NhanHuynh2006/smart-water-tank/iot-report-en/main.tex

\documentclass[a4paper, oneside, 13.5pt, top=2.5cm, bottom=2.5cm, left=3cm, right=2.5cm]{book}

% ================================
% Các gói hỗ trợ định dạng văn bản
% ================================
\usepackage{hcmutethesis}
\usepackage{graphicx}
\usepackage[english]{babel}
\usepackage[T5]{fontenc}
\usepackage[utf8]{inputenc}
\usepackage{indentfirst}
\usepackage{titlesec}

% ================================
% Các gói hỗ trợ kỹ thuật
% ================================
\usepackage{tikz}
\usetikzlibrary{calc, arrows.meta, fit, backgrounds, positioning}
\usepackage{amsmath, amssymb}
\usepackage{tabularx}
\usepackage{makecell}
\usepackage{wrapfig}
\PassOptionsToPackage{hidelinks}{hyperref}
\usepackage{array}
\usepackage[table]{xcolor}
\usepackage{multirow}
\usepackage{longtable}
\usepackage{float}
\usepackage{rotating}
\usepackage{chngcntr}
\usepackage{textcomp}
\usepackage{fancyhdr}
\usepackage{caption}
\usepackage{enumitem}
\usepackage{tocloft}
\usepackage{listings}
\setlength{\cftfignumwidth}{2.5em}

% ================================
% Đánh số hình và bảng theo chương
% ================================
\counterwithin{figure}{section}
\counterwithin{table}{section}

% ================================
% Định dạng tiêu đề
% ================================
\titleformat{\subsection}{\normalfont\large\bfseries}{\hspace{1em}\thesubsection}{0.5em}{}
\titleformat{\subsubsection}{\normalfont\normalsize\bfseries}{\hspace{2em}\thesubsubsection}{0.5em}{}

\setlist[itemize,enumerate]{
    labelindent=1em,
    leftmargin=3em,
    listparindent=2em,
    parsep=0pt
}

\renewcommand{\baselinestretch}{1.3}
\titlespacing*{\section}{0pt}{20pt}{15pt}
\titleformat*{\section}{\fontsize{18pt}{0pt}\selectfont \bfseries}
\titlespacing*{\subsection}{0pt}{15pt}{10pt}
\titleformat*{\subsection}{\fontsize{16pt}{0pt}\selectfont \bfseries}
\titlespacing*{\subsubsection}{0pt}{15pt}{10pt}
\titleformat*{\subsubsection}{\fontsize{14pt}{0pt}\selectfont\bfseries}
\titlespacing*{\paragraph}{0pt}{15pt}{0pt}
\titleformat*{\paragraph}{\fontsize{13pt}{0pt}\selectfont \bfseries}

\setcounter{secnumdepth}{3}
\setcounter{tocdepth}{3}

% ================================
% Định dạng khối mã nguồn
% ================================
\definecolor{codebg}{HTML}{F4F6F8}
\definecolor{codekw}{HTML}{123E6B}
\definecolor{codecm}{HTML}{5A6B78}
\lstset{
    backgroundcolor=\color{codebg},
    basicstyle=\ttfamily\footnotesize,
    keywordstyle=\color{codekw}\bfseries,
    commentstyle=\color{codecm}\itshape,
    breaklines=true,
    frame=single,
    rulecolor=\color{codecm},
    xleftmargin=1em,
    numbers=none,
    showstringspaces=false,
    captionpos=b
}

% ================================
% Figure placeholder box
% Replace \chohinh{...}{...} with
% \includegraphics[width=0.9\textwidth]{fig/filename.png}
% ================================
\newcommand{\chohinh}[2]{%
  \fbox{\parbox[c][2.9cm][c]{0.86\textwidth}{\centering \textit{#1}\\[0.5em]
  \small Insert figure here: \texttt{fig/#2}}}%
}

% ================================
% Cài đặt header và footer
% ================================
\pagestyle{fancy}
\fancyhf{}
\fancyhead[L]{\leftmark}
\fancyfoot[C]{\thepage}

% ================================
% Khai báo thông tin đồ án
% ================================
\thesislayout
\input{bia_phancong/thongtin_bia}

\setstretch{1.5}

% ================================
% Cho phép dùng mục điều khiển của IEEEtran khi không dùng lớp IEEEtran
% ================================
\makeatletter
\def\bstctlcite{\@ifnextchar[{\@bstctlcite}{\@bstctlcite[@auxout]}}
\def\@bstctlcite[#1]#2{\@bsphack
  \@for\@citeb:=#2\do{%
    \edef\@citeb{\expandafter\@firstofone\@citeb}%
    \if@filesw\immediate\write\csname #1\endcsname{\string\citation{\@citeb}}\fi}%
  \@esphack}
\makeatother

\hypersetup{hidelinks}
\begin{document}
\bstctlcite{BSTcontrol}

% Trang bìa
\coverpage
\newpage
\pagestyle{fancy}

% ======== Acknowledgments ========
\begin{acknowledgments}
Throughout this final project for the course IoT Foundations and Applications, our group received careful guidance and valuable technical feedback from Dr. Huynh The Thien. His lectures on layered architecture, application layer messaging and time series data infrastructure provided the theoretical basis for most of the design decisions in the system we built.\\

We also thank the Faculty of Advanced Education for granting us laboratory access, which allowed us to complete the hardware prototype and carry out the measurements reported here.\\

We would like to express our sincere and deepest gratitude.

\begin{table}[!h]
\centering
\begin{tabular}{p{3cm} p{3cm} p{3cm} p{3cm}}
&   & \multicolumn{2}{c}{Project group} \\
&   & \multicolumn{2}{c}{\textit{(Signature and full name)}} \\
&   &                                  \\
&   &                                  \\
&   &                                  \\
&   &                                  \\
&   &                                  \\
&   &                                  \\
\end{tabular}
\end{table}
\end{acknowledgments}
\newpage
\pagestyle{fancy}

% ======== Declaration ========
\begin{declaration}
We declare that the entire content presented in this report is the result of our own research and implementation. The firmware, the backend service and the monitoring interface were written by us. The experimental data were collected directly on the physical prototype that we assembled. Every item taken from the course lectures, technical standards and scientific literature is cited at the point of use and listed in the references.
\\
\begin{table}[!h]
\centering
\begin{tabular}{p{3cm} p{3cm} p{3cm} p{3cm}}
&   & \multicolumn{2}{c}{Project group} \\
&   & \multicolumn{2}{c}{\textit{(Signature and full name)}} \\
&   &                                  \\
&   &                                  \\
&   &                                  \\
&   &                                  \\
&   &                                  \\
&   &                                  \\
\end{tabular}
\end{table}
\end{declaration}
\newpage
\pagestyle{fancy}

% ======== Abstract ========
\begin{abstract}
\sloppy

This project builds a closed loop smart water tank for Project 08: it measures water level and flow, drives a pump automatically, accumulates consumed volume, detects and classifies faults, and can be supervised from anywhere on the Internet. The system spans the layered model of the Internet of Things: an ESP32 with an ultrasonic level sensor, two turbine flow sensors, a Hall current sensor and two float switches; MQTT over Wi-Fi to a Mosquitto broker; a FastAPI service with a SQLite time series store; and a web dashboard published through an HTTPS tunnel, where anyone may watch and only a password authenticated administrator may control.

The central design decision is to place the entire control law and every safety rule inside the edge microcontroller. Level regulation therefore keeps working while the network is down, and a ring buffer replays telemetry when it returns. The controller is a seven state machine with a 30 to 70 percent hysteresis band and minimum on and off times; eleven fault rules, a single guard function through which every pump start must pass, and independent overflow layers ensure that manual commands cannot bypass safety. Level readings pass a robust filter chain (lower quartile of a fifteen ping window, interquartile spread gate, physical rate checks and an alpha-beta filter), backed by a tank model that bridges intervals without a trusted reading, and a pump health classifier separates hydraulic from electrical pump faults using current and level evidence. A rolling baseline over 48 half hour slots detects abnormal consumption on the backend.

On the bench, every automatic fill of the control session stopped between 70.1 and 70.8 percent with at most 1.85 percent overshoot, the pump started 12.9 times per hour with no relay chatter, no false alarm was raised in 84 minutes, and pumped volume was estimated with a mean error of $-5.2$ percent against a geometric reference. Calibrated against a ruler and the pumped volume, the level reads within 0.68 centimetres root mean square outside one ultrasonic blind zone. On the final firmware the tank kept filling through a two minute network outage and stopped itself at 70.7 percent, 4 of 129 messages were lost, and commands were confirmed with a median round trip of 29 milliseconds. The report states openly where the prototype falls short: the flow sensors are fitted and the inlet sensor is calibrated, but control and accounting still use flow derived from the level; the no current fault was not injected physically; and the MQTT path inside the laboratory is not encrypted.

\end{abstract}
\newpage
\pagestyle{fancy}

% ======== Contents ========
\tableofcontents
\newpage
\listoftables
\listoffigures
\newpage
\pagestyle{fancy}

% ======== Abbreviations ========
\begin{abbreviation}
The following abbreviations are used throughout this report.
\begin{table}[!h]
\renewcommand{\arraystretch}{1.3}
\begin{tabular}{p{3cm} p{11cm}}
\textbf{Abbreviation} &  \textbf{Definition} \\
\hline
IoT   & Internet of Things \\
MQTT  & Message Queuing Telemetry Transport \\
QoS   & Quality of Service \\
LWT   & Last Will and Testament \\
ACL   & Access Control List \\
TLS   & Transport Layer Security \\
REST  & Representational State Transfer \\
API   & Application Programming Interface \\
JSON  & JavaScript Object Notation \\
IQR   & Interquartile Range \\
mDNS  & Multicast Domain Name System \\
RTT   & Round Trip Time \\
HTTPS & Hypertext Transfer Protocol Secure \\
TSDB  & Time Series Database \\
ADC   & Analog to Digital Converter \\
SAR   & Successive Approximation Register \\
PWM   & Pulse Width Modulation \\
GPIO  & General Purpose Input Output \\
MCU   & Microcontroller Unit \\
FSM   & Finite State Machine \\
ISR   & Interrupt Service Routine \\
NVS   & Non-Volatile Storage \\
EMF   & Electromotive Force \\
MAE   & Mean Absolute Error \\
RMSE  & Root Mean Square Error \\
EWMA  & Exponentially Weighted Moving Average \\
CUSUM & Cumulative Sum \\
\hline
\end{tabular}
\end{table}
\end{abbreviation}
\newpage
\pagestyle{fancy}

% ======== Main content ========

\include{chapters/chapter01}
\include{chapters/chapter02}
\include{chapters/chapter03}
\include{chapters/chapter04}
\include{chapters/chapter05}
\appendix
\include{chapters/appendixA}

% ======== References ========
\bibliographystyle{IEEEtran}
\bibliography{refs}

\end{document}
