NhanHuynh2006/smart-water-tank/iot-report-en/bia_phancong/bang_phancong.tex

% BANG PHAN CONG: sua noi dung tung dong o day.
\begin{table}[H]
\caption{Distribution of work among group members.}
\label{tab:phancong}
\centering
\renewcommand{\arraystretch}{1.15}
\begin{tabular}{|p{4.6cm}|p{8.4cm}|}
\hline
\textbf{Member} & \textbf{Area of responsibility} \\
\hline
\raggedright Trịnh Trần Quốc Bảo\newline 24119016 & Problem statement and requirements; system architecture, the edge decision principle, the bench rig and signal conditioning. Presents Parts 1 and 2. \\
\hline
\raggedright Đặng Cao Dương\newline 24119024 & Lessons from bench faults, limitations and next steps, conclusion; coordinates the live demonstration and explains each test case and its purpose. Presents Part 7 and the demo. \\
\hline
\raggedright Huỳnh Lê Thành Nhân\newline 24119068 & Firmware and code: MQTT protocol and acknowledgements, level filter pipeline, flow from level, state machine, fault rules, safety guard, pump health and leak detection. Presents Parts 3 and 4. \\
\hline
\raggedright Nguyễn Đoàn Hoàng Ngân\newline 24119064 & Backend and SQLite schema, REST API, dashboard and Cloudflare tunnel, security model, ring buffer and outage recovery. Presents Part 5. \\
\hline
\raggedright Tô Ngọc Thảo Uyên\newline 24119098 & Experiment plan and analysis: control response, volume estimation error, latency and Wi-Fi power saving, fault and outage results. Presents Part 6. \\
\hline
\end{tabular}
\end{table}
