NhanHuynh2006/smart-water-tank/iot-report-en/bia_phancong/thongtin_bia.tex

% THONG TIN TRANG BIA: ten de tai, nganh, sinh vien, giang vien huong dan, thoi gian.
% Sua o day. Ten truong, ten khoa va logo nam trong hcmutethesis.sty.
\ctname{\textbf{SMART WATER TANK: LEVEL AND FLOW MONITORING WITH AUTOMATIC PUMP CONTROL}}
\cmjname{\textbf{MAJOR IN COMPUTER ENGINEERING TECHNOLOGY}}
\cstuname{\textbf{Trịnh Trần Quốc Bảo} \\[0.15em] Student ID: 24119016 \\[0.4em]
            \textbf{Đặng Cao Dương} \\[0.15em] Student ID: 24119024 \\[0.4em]
            \textbf{Huỳnh Lê Thành Nhân} \\[0.15em] Student ID: 24119068 \\[0.4em]
            \textbf{Nguyễn Đoàn Hoàng Ngân} \\[0.15em] Student ID: 24119064 \\[0.4em]
            \textbf{Tô Ngọc Thảo Uyên} \\[0.15em] Student ID: 24119098}
\csSupervise{\textbf{Dr. HUYNH THE THIEN}}
\cttime{10/2026}
