NhanHuynh2006/smart-water-tank/iot-report-en/chapters/chapter04.tex

\chapter{BACKEND, INTERFACE, SECURITY AND RELIABILITY}
\label{chap:platform}

\section{Backend architecture}
\label{sec:o5-1}

The backend is a single Python process containing three concurrent components. The ingestion component holds a persistent broker session and subscribes to the six specified topics. The API server exposes endpoints for the dashboard and for extracting experimental data. The rolling baseline leak detector is invoked on every incoming telemetry message and is described in Section~\ref{sec:o6-6}; because it learns slowly, it is rebuilt from the stored history each time the process starts, so a restart does not discard days of learning. In addition the process keeps an in memory copy of the latest state, so that the current state endpoint can answer without touching the database, since the dashboard calls it once per second.

For every telemetry message the ingestion component records the device timestamp alongside \texttt{recv\_ts}, written by the backend on arrival, so that a one way delay $\tau = t_{recv} - t_{sample}$ is available from a single query without external instrumentation. The device timestamp is stored twice: \texttt{ts} at one second resolution, kept so that existing consumers of the payload continue to parse, and \texttt{ts\_ms} at millisecond resolution, which is the field the latency query prefers. The coarser field alone carries a quantisation error of up to 500 milliseconds, larger than the transport delay it is meant to measure, and Section~\ref{sec:o8-5} records the corrected figures side by side. The measurement assumes both clocks are synchronised; messages emitted before synchronisation completes carry a zero timestamp and are excluded from the statistics. Because that assumption cannot be discharged on a microcontroller disciplined only by the network time protocol, the one way figure is treated as a comparison quantity and the command round trip, timed entirely by the server clock, is the reported result.

\section{Data schema and API}
\label{sec:o5-2}

The schema has six tables, split according to data behaviour, and is shown with the whole repository in the code guide delivered alongside this report: \texttt{telemetry} is written continuously at one row per second, while \texttt{faults}, \texttt{pump\_events}, \texttt{commands}, \texttt{availability} and \texttt{config} are written sparsely and discretely. The telemetry table is indexed on the timestamp column, the only column ever used as a filter predicate. The group applies the tag and field separation principle of Section~\ref{sec:o2-5}: the device identifier acts as an indexed tag while the measured quantities are unindexed fields. In particular the sequence number column, although it changes on every row, is deliberately left unindexed to avoid exactly the cardinality explosion the lectures warn about \cite{slide04}. The command table stores both the send time and the acknowledgement time, whose difference is the command round trip latency.

On database choice, the group is aware that the theory in Section~\ref{sec:o2-5} identifies real limits of relational engines for high rate time series data \cite{slide04}. Those limits, however, appear at thousands of writes per second, whereas this system writes one row per second from one node, three to four orders of magnitude below the problematic regime. Deploying a dedicated time series engine would add operational complexity without any measurable benefit, so the group chose SQLite while still respecting the schema design principles above \cite{sqlite}.

\begin{table}[H]
\caption{Main API endpoints.}
\label{tab:api}
\centering
\renewcommand{\arraystretch}{1.1}
\begin{tabular}{|p{1.5cm}|p{4.6cm}|p{6.9cm}|}
\hline
\textbf{Method} & \textbf{Path} & \textbf{Purpose} \\
\hline
GET & \texttt{/api/latest} & Latest state, data freshness, pending commands \\
\hline
GET & \texttt{/api/telemetry} & Time series over a requested interval \\
\hline
GET & \texttt{/api/volume/daily} & Volume pumped in and drawn out per day \\
\hline
GET & \texttt{/api/leak/baseline} & State of the rolling baseline, slots learned \\
\hline
POST & \texttt{/api/login}, \texttt{/api/logout} & Open or close an administrator session \\
\hline
GET & \texttt{/api/auth} & Whether this browser may control the pump \\
\hline
GET & \texttt{/api/faults}, \texttt{/api/events}, \texttt{/api/commands} & Fault log, pump switching log, command log with acknowledgement latency \\
\hline
POST & \texttt{/api/command} & Issue a command, returns its identifier; session required \\
\hline
GET, PUT & \texttt{/api/config} & Read thresholds; update requires a session \\
\hline
GET & \texttt{/api/stats/latency} & Latency statistics used in Section~\ref{sec:o8-5} \\
\hline
\end{tabular}
\end{table}

Method selection follows the two properties introduced in Section~\ref{sec:o2-5}. Read endpoints use GET because they are safe and change no state. The configuration endpoint uses PUT because replacing the full threshold set is idempotent. The command endpoint uses POST because each call creates a new command record with its own identifier and is therefore not idempotent \cite{slide05}.

\textbf{Daily volume.} The first implementation computed each day's volume as the maximum minus the minimum of the accumulated counter. That is wrong whenever the counter is reset during the day, and it was: the result swung by litres after every reset. The corrected query uses a window function to take the increment between consecutive rows and sums only increments that are positive and physically possible in one second, so a reset contributes nothing instead of a large negative step. Inflow increments are additionally counted only while the previous row showed the pump running, because with flow derived from level the inlet cannot be non zero with the pump off. Rows stamped before the device clock synchronised carry a timestamp near zero and are assigned to the server's arrival date instead, which removed a spurious day in 1970 from the chart. Figure \ref{fig:daily} shows the result for the four bench days.

\begin{figure}[H]
    \centering
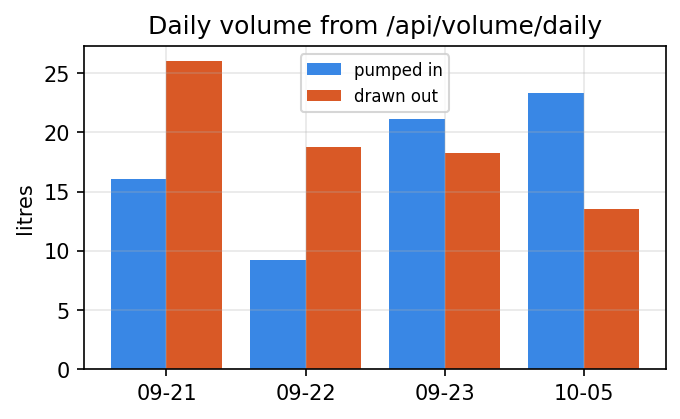
[picture p7: iot-report-en/fig/daily_volume.png]
    
    \caption{Daily volume pumped in and drawn out, as served by the API.}
    \label{fig:daily}
\end{figure}

\section{Monitoring interface}
\label{sec:o5-3}

\begin{figure}[H]
    \centering
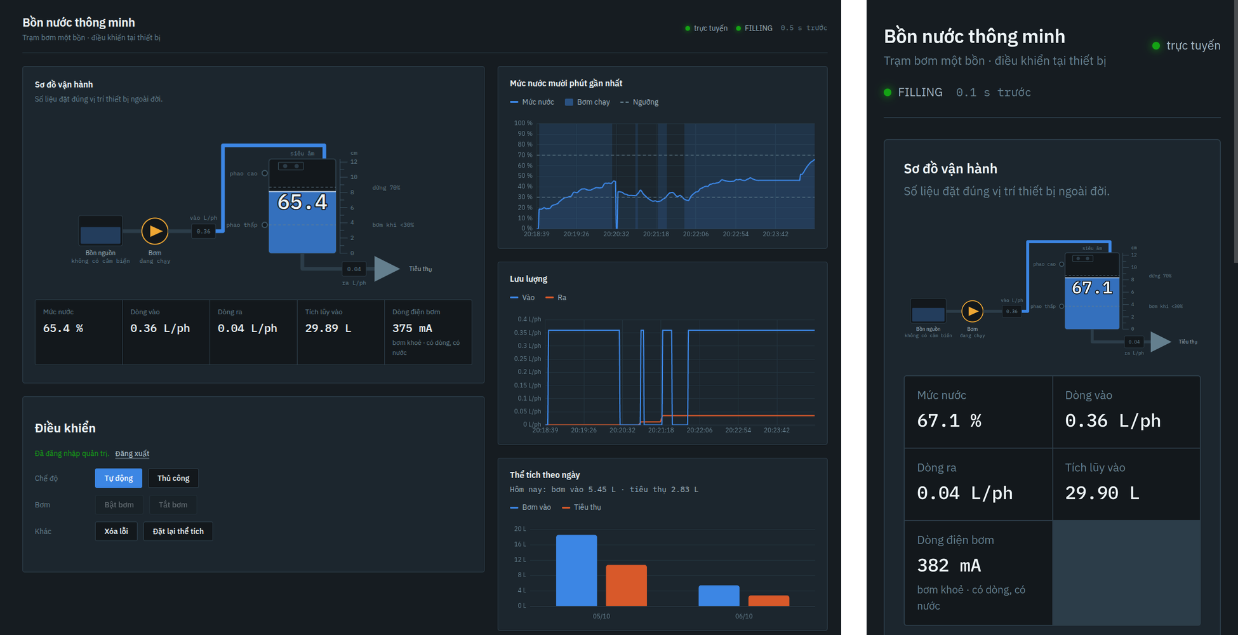
[picture p8: iot-report-en/fig/dashboard_pc_mobile.png]
    
    \caption[Monitoring dashboard on a computer and on a phone]{Monitoring dashboard during an automatic fill, on a computer (left, logged in as administrator) and on a phone (right, viewer). The same page rearranges itself to a single column on a narrow screen: process mimic first, then the numeric tiles, the controls and the charts. For these screenshots, recorded data from 6 October were replayed into an isolated copy of the backend, so the live database was not modified.}
    \label{fig:dashboard}
\end{figure}

The interface is designed for an operator who glances at the screen for a few seconds to answer three questions: what is the level, is the pump running, and is anything wrong. It is a single HTML file with no build step and no framework. The same page serves computers and phones: on a narrow screen the panels stack into one column, the numeric tiles fall into two columns, and the controls stay reachable with a thumb, which matters because the public link is most often opened on a phone (Figure~\ref{fig:dashboard}). The upper part is a process mimic in the style of a control room: the source bucket, the pump, the pipe and the tank are drawn as a diagram, the water in the tank rises and falls with the measured level against a ruler graduated from 0 to 12.4 centimetres, and the low, high and overflow thresholds are drawn at their true positions for the active configuration. Drawing the thresholds on the tank lets a viewer see at once where the level sits relative to the hysteresis band and why the pump just switched.

Below the mimic are the numeric tiles: level, inlet and outlet flow, pump current in milliamperes with the pump health label underneath it, and today's volume. Beside them are the history charts, a daily volume bar chart, and three logs: faults (with the pump health at the moment of each fault), pump events and commands. A freshness line next to the connection lamp shows how many seconds ago the last message arrived.

Two display details matter more than they appear to. The device reports once per second, so a number written straight into the page moves in visible steps; the interface eases the displayed value towards each new reading. And the filtered level still moves by a few millimetres from sample to sample, which on a large readout looks like instability; the display applies a deadband of 0.25 centimetres, below the resolution anyone can act on, so the number holds still unless the water really moves. Neither detail touches the data: the database and the API carry the unmodified values.

On the update mechanism, the lectures recommend REST for low frequency administrative tasks and WebSocket for live streams \cite{slide06, rfc6455}. The group chose polling at 1 Hz, which runs against that general recommendation and therefore needs justification. The device publishes at 1 Hz, so the polling rate equals the data production rate and no request is wasted. With a handful of clients and one node the resulting traffic is a few kilobytes per second. A WebSocket introduces a stateful channel with its own lifecycle to manage, including heartbeats and reconnection \cite{slide06}, that is a new set of failure states in exchange for a benefit that is not measurable at this scale. The conclusion reverses beyond roughly ten nodes or a required update rate of 5 Hz.

The feedback sync principle is implemented in how command state is displayed. When the user presses the pump button the interface does not change the pump symbol; it posts the request, receives an identifier, shows ``sending command'' and polls the command log for that identifier. When the acknowledgement arrives it reports the outcome in a plain sentence, including the reason for a rejection, while the pump symbol follows only the pump state reported in telemetry. An early version gave no feedback at all on a rejection, and a user reported that manual mode ``did not work'' when the device had in fact correctly refused a start inside the 20 second minimum off time; the countdown shown on the button now makes that interlock visible instead of mysterious.

\textbf{Remote access and control rights.} The assignment frames the system as remote supervision, so the dashboard is published through an outbound Cloudflare tunnel that gives it a public HTTPS address without opening any inbound port on the laboratory network. Anyone with the address can watch. Control is a separate matter: the control panel stays hidden until the browser holds an administrator session, obtained by entering a password kept in a file outside the repository. The group first tried to grant control by client address, allowing only the host machine, and abandoned it for two reasons found in testing: through the tunnel every request arrives from the loopback address, so the rule granted control to the whole Internet; and on the host itself every open tab could control the pump, which is not what the owner meant by ``only my machine''. Section~\ref{sec:o7-2} describes the session mechanism.

The interface adapts to the state reported by the device, following the conditional rendering principle \cite{slide06}: data older than 5 seconds or an arriving last will message turns the connection lamp red; a fault or overflow lock switches the status to an alarm style; and a false \texttt{level\_ok} flag marks the level as untrusted. Hiding or disabling buttons is only a convenience, since the backend rejects commands without a session and the device rejects unsafe ones regardless of who sent them.

\section{Device simulator}
\label{sec:o5-4}

The simulator implements the hydraulic model introduced in Section~\ref{sec:o2-6} together with a sensor noise model, and publishes messages that conform to the specification of Sections \ref{sec:o4-1} to \ref{sec:o4-4}. It serves two purposes: while components had not arrived it allowed the backend and interface branches to be developed fully, and it allows control parameters to be swept across dozens of configurations in a few minutes, which is not feasible on real hardware. The sweep results are reported in Section~\ref{sec:o8-3}. The simulator can also inject three failure modes, namely a pump that runs without delivering water, a sensor stuck at a fixed value, and a leak at a prescribed flow rate.

\section{Threat model and mitigations}
\label{sec:o7-1}

Under the ITU-T Y.2060 model of Section~\ref{sec:o2-2}, security is a cross cutting capability acting on every layer rather than a layer of its own \cite{itu2060}, so the analysis is organised per layer.

\begin{table}[H]
\caption{Threat scenarios and mitigations.}
\label{tab:threat}
\centering
\renewcommand{\arraystretch}{1.1}
\begin{tabular}{|p{5.2cm}|p{3.4cm}|p{4.4cm}|}
\hline
\textbf{Attack scenario} & \textbf{Consequence} & \textbf{Mitigation} \\
\hline
Connect to the broker and publish a pump on command & Overflow, pump damage & Mandatory authentication, per topic access control \\
\hline
Sniff traffic to harvest credentials & Full control takeover & \textbf{Not mitigated in the lab build:} broker on plain port 1883, reachable only inside the laboratory network; TLS on port 8883 is the deployment step \\
\hline
Forge telemetry so the system misreads the level & Incorrect pumping, possible overflow & Local interlock based on the mechanical float \\
\hline
Replay commands repeatedly to make the pump chatter & Mechanical pump damage & Minimum on and off times enforced on the device \\
\hline
Call the API directly, bypassing the web interface & Unauthorised commands & Every control endpoint checks an administrator session \\
\hline
Guess the administrator password through the public address & Control takeover & Five failures in five minutes lock the source address \\
\hline
\end{tabular}
\end{table}

The second row is the one gap the group leaves open, and Section~\ref{sec:o7-2} states it without qualification. The two rows after it are worth highlighting because they are mitigated not by cryptography but by the control design itself. The mechanical float is a physical constraint that no network message can override, and the minimum switching times are enforced in firmware, so an attacker may send any number of commands without making the pump toggle faster than the limit. This illustrates the principle that safety in a cyber physical system cannot be separated from its control design.

\section{Authentication, authorisation and encryption}
\label{sec:o7-2}

The Mosquitto configuration disables anonymous connections entirely and mandates both a password file and an access control list file \cite{mosquitto}. The group applies least privilege: the edge device may only publish on the northbound topics under its own branch and may only subscribe to its own command topic, while the backend may publish on the command topic and read the whole northbound branch. The practical meaning is that if the edge device is compromised, the attacker still cannot use that device to issue control commands, because the device account has no write permission on the command topic. This is exactly the node compromise scenario the lectures raise when introducing access control lists \cite{slide03}.

On the API side the system distinguishes a viewer, who needs nothing and may call every read endpoint, from an administrator, who may also call the command and configuration endpoints. Administrator rights are obtained by password. The password lives in a file outside the repository with owner only permissions, and is compared in constant time. A correct password creates a random 256 bit session token, returned as a cookie marked HttpOnly so page scripts cannot read it, SameSite Strict so another site cannot make the browser send it, and Secure whenever the request arrived over HTTPS, which through the tunnel is always. Sessions last seven days and are held in memory, so restarting the backend logs everyone out, which the group accepts at this scale. A missing or expired session returns 401. Five wrong passwords within five minutes lock further attempts from that address for the rest of the window, with the client address taken from the tunnel's forwarded header only when the connection itself comes from the local machine, since any remote caller could forge that header.

The group records one design it rejected. Control was first granted to requests from the host machine's own address. Behind the tunnel every request, from anywhere, arrives from the loopback address, so the rule silently gave control to the whole Internet; and even without the tunnel it gave control to every browser tab on the host rather than to a person. Identity has to come from something the person knows, not from where the packet appears to come from.

\textbf{What is not encrypted.} The system as built does not use TLS on the MQTT path, and the group does not claim end to end encryption. The broker listens on the unencrypted port 1883, inside the laboratory network only; the Cloudflare tunnel carries the dashboard and the API over HTTPS and never exposes the broker. Anyone able to capture Wi-Fi traffic on that network could therefore read the telemetry and the broker passwords of the device and the backend, which is exactly the sniffing threat of Table~\ref{tab:threat}. Within the lab, the access control list limits what a stolen device password allows, and the control design limits what a forged command can do; neither replaces encryption. For a real deployment the group would move to MQTTS on port 8883 with a certificate on the broker \cite{slide03, rfc8446}. The cost should be stated plainly: the TLS handshake requires the microcontroller to perform public key operations, which noticeably increases startup time and memory consumption. One principle holds in every configuration, namely that no secret ever appears inside the telemetry payload.

\section{Reliability during a network outage}
\label{sec:o7-3}

This is a mandatory requirement and also the most important property of the system. Four mechanisms are implemented.

First, the control loop runs on a fixed cycle, and the network calls it cannot avoid are bounded: opening a socket to the broker gives up after 500 milliseconds instead of the default three seconds, waiting for the broker's acknowledgement gives up after two seconds, and no message is written to a socket that cannot accept it at once (Section~\ref{sec:o4-4}). Measured on the final firmware with the link cut for 120 seconds, the longest control period during the outage was 0.88 seconds, against up to ten seconds before the socket check was added. During an outage the system therefore loses only remote visibility while retaining every control and safety function, and the longest control period is published in the first message after reconnection so the claim can be checked rather than assumed.

Second, when the link is down telemetry messages are not discarded but packed into a compact structure and pushed into a circular buffer holding 240 entries, about four minutes of data. The circular buffer was chosen for exactly the reason given in the lectures, namely constant time insertion with no array shifting \cite{slide01}. Each entry stores only the essential fields as scaled integers instead of a full JSON string. Once the link returns the whole buffer is replayed in order, tagged so it can be excluded from latency statistics. The buffer only starts filling once the firmware knows the link is down, which is why the socket is closed after three seconds of refused writes rather than left to the 15 second keep alive.

Third, accumulated volume is written to non volatile storage and reloaded at startup, so a sudden power loss does not erase the consumption history.

Fourth, inside the initialisation routine and before any sensor is read, the relay control pin is driven to the pump off level, so every restart begins from a safe state. The state machine then stays in \texttt{BOOT} until a first level reading has been accepted, so the zero that the level variable holds at power up can never be read as an empty tank (Section~\ref{sec:o8-3}). The integrated brownout detector acts as an additional protective layer: when the supply falls below the critical threshold, flash writes become unreliable and the core may execute corrupted instructions, so the hardware deliberately holds the device in a safe reset state until the voltage recovers \cite{slide01}.

\begin{table}[H]
\caption{Independent layers of overflow protection.}
\label{tab:layers}
\centering
\renewcommand{\arraystretch}{1.1}
\begin{tabular}{|p{4.6cm}|p{3.6cm}|p{4.8cm}|}
\hline
\textbf{Mechanism} & \textbf{Location} & \textbf{Still effective when} \\
\hline
High threshold of the hysteresis band & State machine & Sensor is healthy \\
\hline
Safety limit at 85 percent & Fault rule & Sensor is healthy \\
\hline
Raw distance closer than 4.5 cm, three pings in a row & Fault rule, unfiltered & The filter chain is producing nonsense \\
\hline
No level progress in 90 seconds & Fault rule & Level reading is frozen or false \\
\hline
2.5 litres in one run; 240 s and unconditional 300 s run limits & Fault rules & Every level sensor has failed \\
\hline
Upper mechanical float & Digital input & Ultrasonic sensor has failed \\
\hline
Relay driven off as the first instruction at boot & Firmware start up & Controller has just reset \\
\hline
\end{tabular}
\end{table}

The value of this arrangement lies in the independence of the layers. The first two both rely on the filtered ultrasonic level and fail together if it fails, but the raw distance guard bypasses the filter, the run limits consult only the clock, and the float requires no measurement at all. The time limits are honestly the weakest layer: a 240 second run at the measured delivery adds 1.44 litres, more than the whole 1.24 litre tank, so on their own they bound the damage rather than prevent it, and they sit behind the float rather than replacing it. No single point of failure disables the overflow protection as a whole.
