NhanHuynh2006/smart-water-tank/iot-report-en/chapters/chapter01.tex

\chapter{INTRODUCTION AND BACKGROUND}
\label{chap:intro}

\section{Motivation and problem statement}
\label{sec:o1-1}

Household water management in Vietnam still relies largely on a mechanical float placed inside the storage tank. The device is cheap and durable, but it solves exactly one problem: cutting the pump when the tank is full. The owner has no idea how much water was consumed, cannot notice a pipe leak until the bill rises unexpectedly, and has no way of knowing that the pump is running dry until it has already failed.

The problem carries every characteristic of a cyber physical system, meaning a system in which computation, communication and a physical process are tied together through feedback loops \cite{slide01}. A physical quantity is measured, digitised, transported to a data infrastructure, turned into a decision, and finally acted back upon the same physical process through an actuator.

From an engineering point of view the tank is a nonlinear plant carrying a hard safety constraint. Discharge flow depends on the square root of the water column height, so the plant response changes with the current level. At the same time there is one constraint that may never be violated under any circumstance, including a manual command issued by an operator: the tank must not overflow. Having to guarantee control quality and an absolute safety constraint at the same time is what lifts this project above a simple exercise in wiring a sensor to a display.

The system must therefore address four groups of problems: measuring level and flow with an error budget established experimentally rather than copied from a datasheet; holding the level inside a desired band without letting the pump chatter around the switching threshold; detecting abnormal hydraulic operating modes; and providing remote supervision through a time series store and a real time interface. Overarching all of them is a single requirement that shapes the whole architecture: essential level control must keep working when the network link is lost.

\section{Scope and working method}
\label{sec:o1-2}

The system is built at laboratory prototype scale with one sensing node, a tank with a 1.24 litre working volume and a low voltage direct current pump. The entire electrical side operates at safe extra low voltage. Distributed multi node deployment, machine learning based consumption forecasting and integration with a commercial cloud platform are outside the scope of this work.

The group organised the work along the V model introduced in the project management part of the course \cite{slide01}, in which every decomposition step on the descending branch has a matching verification step on the ascending branch: requirement analysis pairs with full system acceptance, architectural design pairs with integration testing, protocol specification pairs with protocol level testing, and circuit design pairs with unit testing of each individual sensor.

One methodological decision deserves emphasis. The group specified the complete MQTT topic tree, the message payloads, the set of API endpoints and the database schema before writing a single line of code. That specification acted as an internal contract, which allowed the firmware branch, the backend branch and the interface branch to advance in parallel instead of waiting on one another. While components had not yet arrived, a simulator publishing messages that conform to the agreed specification let the other two branches be developed and tested in full.

\section{Requirements of the assignment}
\label{sec:o2-1}

The assignment, Project 08, asks for a smart water tank that monitors consumption and controls its pump automatically. Table \ref{tab:yeucau} restates each requirement in the words of the brief and points to where the report answers it. The third column is the group's own assessment of how completely the requirement is done, because a requirement that is only partly met is better stated than hidden.

\begin{table}[H]
\caption{Requirements of Project 08 and where they are addressed.}
\label{tab:yeucau}
\centering
\renewcommand{\arraystretch}{1.1}
\small
\begin{tabular}{|>{\raggedright\arraybackslash}p{6.3cm}|>{\raggedright\arraybackslash}p{2.7cm}|>{\raggedright\arraybackslash}p{4.4cm}|}
\hline
\textbf{Requirement} & \textbf{Where} & \textbf{Status} \\
\hline
ESP32 class controller with tank level and flow sensors; pressure and pump current optional & Sections~\ref{sec:o3-3}, \ref{sec:o6-2}, \ref{sec:o8-2} & Partly validated: both fitted and read, inlet calibrated; control and volume use level derived flow \\
\hline
Low voltage pump through a relay or MOSFET driver with inductive protection & Section~\ref{sec:o3-4} & Done \\
\hline
Prevent overflow and behave safely on failed or implausible sensors & Sections~\ref{sec:o6-4}, \ref{sec:o7-3} & Done, seven independent layers \\
\hline
Instantaneous flow and accumulated volume & Sections~\ref{sec:o6-2}, \ref{sec:o8-2} & Done, from level; mean error $-5.2$\% \\
\hline
Publish telemetry, actuator state, faults and availability over MQTT & Sections \ref{sec:o4-1} to \ref{sec:o4-4} & Done \\
\hline
Time series storage, REST API, dashboard with level, flow, daily volume, pump state, alarms and freshness & Sections \ref{sec:o5-1} to \ref{sec:o5-4} & Done \\
\hline
Automatic control with hysteresis or a state machine and at least one fault rule, such as pump on with near zero flow & Sections~\ref{sec:o6-3}, \ref{sec:o6-4} & Done, eleven rules \\
\hline
Manual mode cannot bypass safety; commands acknowledged with confirmed state & Sections~\ref{sec:o6-5}, \ref{sec:o4-3} & Done \\
\hline
Local level control keeps working during a network outage & Sections~\ref{sec:o3-2}, \ref{sec:o7-3}, \ref{sec:o8-5} & Done \\
\hline
Advanced: leak detection from a rolling baseline, or pump current and flow consistency to classify pump faults & Sections~\ref{sec:o6-6}, \ref{sec:o6-7} & Both built; baseline still converging \\
\hline
Calibrate level and flow against a physical reference & Section~\ref{sec:o8-2} & Done: ruler and pumped volume, RMSE 0.68 cm; one blind zone \\
\hline
Control response, switching frequency, fault detection delay, volume estimation error & Sections~\ref{sec:o8-2} to \ref{sec:o8-4} & Done \\
\hline
Sensor or no flow fault test, network loss and recovery, telemetry and control latency & Sections~\ref{sec:o8-4}, \ref{sec:o8-5} & Done; outage rerun on final firmware; \texttt{NO\_CURRENT} not injected \\
\hline
\end{tabular}
\end{table}

\section{Layered architecture and computation placement}
\label{sec:o2-2}

An Internet of Things deployment is commonly described by a five layer model made of perception, transport, processing, application and business layers, allowing each stage of signal conversion, transport and storage to be optimised independently \cite{slide01}. Recommendation ITU-T Y.2060 adds two capability groups that cut across the stack, management and security \cite{itu2060}. Treating security as cross cutting rather than as a separate layer has a direct consequence for our design: it cannot be handled at a single point but must appear in broker authentication, per topic access control, transport encryption and API authorisation. Data flow is likewise split into a southbound path carrying commands down to the hardware and a northbound path carrying telemetry and alerts up to the server \cite{slide01}.

Deciding where a computation belongs is driven by quantitative constraints rather than taste. Edge computation offers deterministic latency and very low bandwidth cost but only short term storage, while cloud computation offers durable storage and analytic capacity at the price of latency from hundreds of milliseconds to several seconds \cite{slide01}. The resulting rule is that any operation requiring an immediate safe stop must be computed at the edge, whereas trend analysis is routed upward. Cutting the pump on a dry run condition or when the level passes the safety threshold clearly belongs to the first category, which is the direct basis for the decision in Section~\ref{sec:o3-2}.

\section{Sensing, digitisation and actuation}
\label{sec:o2-3}

Faithful reconstruction of a continuous analog signal requires a sampling rate greater than twice its highest frequency component \cite{shannon1949}. With the pump actually fitted and the tank base measuring 10 by 10 centimetres, the group measured the fill rate directly rather than deriving it from the datasheet. The level rose 1.2 centimetres in 20 seconds, that is $0.06$ centimetres per second, equivalent to $0.36$ litres per minute. This is nearly five times slower than the $1.67$ litres per minute the JT-DC3L datasheet promises at zero head, the difference being delivery head and tubing resistance. A sampling period of 200 milliseconds therefore satisfies the condition by roughly three orders of magnitude. The group records both figures deliberately: an earlier draft quoted 0.6 centimetres per second from an unchecked estimate, the datasheet implies 0.28, and the bench measures 0.06. Only the last of the three was used to size the timing thresholds of Section~\ref{sec:o6-3}, because a threshold derived from a datasheet the hardware does not obey will fire during normal operation. Even the bench figure is not a constant: on 5 October, with a lower source bucket, the same pump delivered 0.24 litres per minute, a fact that matters again in Section~\ref{sec:o8-2}. The ESP32 digitises voltage using a successive approximation register converter \cite{slide01, esp32ds}, and mapping a continuous range onto finite integer steps introduces an unavoidable loss of precision with a quantisation step of

\begin{equation}
\Delta V = \frac{V_{ref}}{2^N}
\label{eq:lsb}
\end{equation}

and quantisation noise bounded within $\pm \frac{1}{2}\Delta V$. This error is mathematical in nature and can never be filtered away in software \cite{slide01}. At 12 bits and 3.3 volts the step is 0.806 millivolts, a figure used in Section~\ref{sec:o3-3}. The lectures also warn that the transfer curve is severely nonlinear near both ends of the range, which is why our dividers place each signal near the middle of the span.

A microcontroller operating at 3.3 volts with roughly 12 milliamperes per pin cannot perform mechanical work directly, so a power stage with galvanic separation has to be inserted. When current through an inductive load is interrupted abruptly, the collapsing field produces a reverse spike following Lenz law, $V = L\,di/dt$, which can exceed several hundred volts and destroy the switching device; the standard remedy is a flyback diode placed antiparallel across the load \cite{slide01}.

\section{Application layer messaging}
\label{sec:o2-4}

A standard HTTP header easily exceeds 500 to 1000 bytes, so sending a measurement of a few bytes spends most of the energy budget on framing, and every transaction additionally forces the radio through a complete TCP handshake \cite{slide03}. MQTT addresses this with a binary frame whose fixed header is two bytes, routed through a broker under a publish and subscribe model that decouples communication in space, time and synchronisation \cite{slide03, mqtt311}.

Three MQTT mechanisms are exploited directly by our system. The three quality of service levels define delivery as at most once, at least once and exactly once, and the lectures caution against defaulting every topic to the highest level because a constrained node will exhaust its memory. The last will mechanism lets the broker publish a pre registered payload by itself once a client vanishes without a clean disconnect, and retained messages make the broker push the current value immediately to a newly subscribing client, eliminating the cold start gap \cite{slide03}. On the security side, MQTTS carries the same binary frames inside a TLS tunnel on port 8883 instead of the unencrypted port 1883, and the lectures stress that a username and password pair alone is insufficient without an access control list mapping each client to the topics it may read and write \cite{slide03, rfc8446}.

\section{Data infrastructure and the feedback sync principle}
\label{sec:o2-5}

Machine telemetry has three structural invariants: it is append only, indexed primarily by time, and its write to read ratio is very high \cite{slide04}. A relational engine is built for transactional integrity, so every inserted row forces a rebalancing of an in memory B-tree, whereas a time series engine optimises for tail appends and separates indexed tags from unindexed fields. The lectures also warn about index cardinality explosion when a randomly varying value is placed in a tag position \cite{slide04}, a principle our schema in Section~\ref{sec:o5-2} follows. The REST style demands client server separation and statelessness, favours nouns over verbs, and asks the designer to evaluate safety $f(s)=s$ and idempotency $f(f(s))=f(s)$ \cite{fielding2000, slide05}; on the microcontroller side, firmware must forbid dynamic allocation inside the loop and reserve a fixed buffer at startup \cite{slide05, arduinojson}.

The single idea with the largest influence on our interface design is the feedback sync principle derived from the device shadow model \cite{slide04}. The anti pattern to avoid is a dashboard toggle that flips to the on state the instant the user presses it, before anything is known about whether the real machine started. The correct architecture splits the path: the user action maps to an outgoing command topic while the indicator stays unchanged until an explicit acknowledgement arrives from the device. This is the basis for the mechanism described in Section~\ref{sec:o4-3}.

\section{On off control with hysteresis}
\label{sec:o2-6}

The material in this section does not appear in the course slides. The group added it from control engineering literature and states the sources here explicitly, so that it is clearly distinguished from the knowledge taken from the lectures.

On off control, also called two position control, is the simplest form of feedback control, in which the actuator takes one of exactly two states \cite{ogata2010}. If the two thresholds coincide, even the smallest measurement noise around that point makes the actuator flip repeatedly, causing rapid wear and repeated inrush events. The standard remedy is to separate them into a hysteresis band inside which the state is held unchanged \cite{astrom2008}:

\begin{equation}
u(t) = 1 \text{ if } h < h_L; \quad u(t) = 0 \text{ if } h > h_H; \quad u(t) = u(t^-) \text{ if } h_L \le h \le h_H
\label{eq:hysteresis}
\end{equation}

The width $h_H - h_L$ is a direct trade off parameter: a wider band lowers the switching frequency but widens the level excursion.

For diagnosis, the group applies the principle of checking consistency between two independent signal sources, following established fault diagnosis theory \cite{isermann2006}. Slow leaks belong to the class of small persistent shift detection, for which the cumulative sum method of Page is far more sensitive than a fixed threshold because it accumulates small deviations over time \cite{page1954}.

To select control parameters before hardware existed, the group built a dynamic model from the volume balance $dV/dt = Q_{in} - Q_{out} - Q_{leak}$ with $h = V/A$, where discharge follows Torricelli law $Q_{out} = C_d A_o \sqrt{2gh}$ \cite{white2011}. The square root dependence makes the plant nonlinear, since discharge at a full tank is appreciably faster than near empty. This is why the hysteresis parameters had to be swept in simulation, as described in Section~\ref{sec:o8-3}.
