NhanHuynh2006/smart-water-tank/IOT/docs/SO_LIEU_20261005.md

# Số liệu đo trên phần cứng ngày 05/10/2026 (dùng để sửa báo cáo và slide)

File gốc nằm cùng thư mục: `systest_20261005_203736.json`, `bench_outage_20261005_203452.json`,
`stepcal_20261005.txt`, `stepcal_high_20261005.txt`, `results_20261005.json`.
E5 (bơm lỗi bằng tay) **không làm** theo quyết định của nhóm.

## Phần cứng và cấu hình đã đổi
- Rơ-le ở **GPIO 10**, Flash Mode **DIO** (`board_build.flash_mode = dio`). Không reset, không chập chờn.
- Thứ tự mạch bơm: rơ-le → ACS712 → bơm chìm; dây bơm có tụ và diode, nguồn có tụ 470 µF.
- Cảm biến lưu lượng: vào GPIO 4, ra GPIO 19 (đã đổi chỗ). Hết nhiễu, dùng được để so sánh.
  Hệ số K đầu vào **85,5** xung/(L/phút), chỉnh theo thước (K = 98 đếm thiếu 14,6 %).
- Hình học: cảm biến cách đáy **15,88 cm** (6¼ inch), mức làm việc tối đa **12,4 cm** (cách cảm biến 3,5 cm), đáy 10 × 10 cm, 1,24 L.
- Ngưỡng 30 / 70 / 85 %. Cửa sổ 15 mẫu, lấy phân vị 25 (tiếng dội yếu làm đọc xa hơn khoảng +0,43 cm mỗi chu kỳ 40 kHz).

## E1 — hiệu chuẩn mực nước (bơm theo bậc, chuẩn là thể tích bơm vào)
- Đọc thước lần cuối 4,9 cm, cảm biến báo 4,92 cm.
- Vùng thấp (mực 0,7–4,9 cm): sai lệch so với thể tích bơm trong khoảng ±0,5 cm (bậc 3 và 5 bị dội chập lệch tới 1 cm).
- **Vùng mù** khi mặt nước cách cảm biến khoảng 7,9–8,7 cm (mực 7–8 cm, 57–64 %): cảm biến trả về tiếng dội ma ổn định
  (bậc thực 7,21 cm đọc 1,01 cm; bậc thực 7,97 cm đọc −5,42 cm). Firmware loại bằng cổng hình học, cổng tốc độ và mô hình bắc cầu tối đa 90 s.
- Nước không chảy ngược qua bơm: đóng van xả, mực phẳng trong 80 s, cảm biến đầu vào 0.

| Bậc | Thể tích (L) | Mực theo thể tích (cm) | Khoảng cách p25 (cm) | Mực cảm biến (cm) |
|---|---|---|---|---|
| Lượt thấp 0–6 | 0 / 0,071 / 0,142 / 0,213 / 0,282 / 0,350 / 0,419 | +0 / 0,71 / 1,42 / 2,13 / 2,82 / 3,50 / 4,19 | 17,68 / 15,16 / 13,57 / 14,13 / 12,07 / 12,16 / 10,96 | −1,80 / 0,72 / 2,31 / 1,75 / 3,81 / 3,72 / 4,92 |
| Lượt cao 0–6 | 0 / 0,067 / 0,136 / 0,202 / 0,268 / 0,333 / 0,400 | +0 / 0,67 / 1,35 / 2,02 / 2,68 / 3,33 / 4,00 | 11,40 / 11,04 / 9,83 / 14,87 / 21,30 / 8,71 / 6,31 | 4,48 / 4,84 / 6,05 / 1,01 (ma) / −5,42 (ma) / 7,17 / 9,57 |

(Lượt thấp bắt đầu từ đáy khô nên bậc 0 âm; lượt cao bắt đầu từ 4,48 cm.)

## Điều khiển tự động
- Ba chu kỳ đủ (17:07–17:40): dừng ở 70,1–70,4 %, vượt 1,72 %, thời gian bơm khoảng 128 s.
- Chu kỳ tối 20:32–20:35: bật từ dưới 30 %, tự dừng ở **70,7 %**.
- Bơm hiện chỉ đưa vào khoảng 0,24–0,3 L/phút (kiểm tra bồn nguồn, van xả để hé).

## E6 — mất mạng 120 s, backend vẫn chạy (bench_outage_20261005_203452)
- Cắt lúc bơm đang chạy ở 9,0 %; sau 120 s mực **50,9 %**, bơm vẫn chạy, không đổi trạng thái lúc mất mạng; chu kỳ đó tự dừng ở 70,7 %.
- Last will (offline) sau **21,8 s**; có lại mạng thì trực tuyến sau **10,0 s**, bản tin trực tiếp đầu tiên sau 10,9 s.
- Gửi lại **125** bản tin đã đệm (seq 707–831), thiếu **4/129**, bộ đệm không tràn (ring_drop 0).
- Vòng điều khiển dừng lâu nhất khi mất mạng **0,88 s** (trước khi sửa là 10 s).

## Kiểm thử hệ thống systest (20:37, 5/5 PASS)
- T1 kết nối: 10 bản tin/10 s, không hụt seq, đủ trường, status giữ lại online.
- T2 bảo mật: xem 200, lệnh không phiên 401, sai mật khẩu 401, đăng nhập 200.
- T3 / E7 lệnh: n = 40, mất 0, khứ hồi **trung vị 29,1 ms, p95 48,5 ms**, nhỏ nhất 16,5, lớn nhất 67,5 ms.
- T4 từ chối: bật bơm ở chế độ tự động → `auto_mode_active`; bật lại trong thời gian nghỉ → `min_off_time`; xóa lỗi khi không có lỗi → `no_active_fault`.
- T5 bơm tay: dòng khi chạy **471–487 mA**, khi tắt 0 mA; nhãn starting → ok.

## Chỗ báo cáo còn ghi số cũ cần sửa
17,5 cm / 14 cm (hình học), 0,36 L/phút, nhiễu 1500 Hz ở cảm biến lưu lượng, rơ-le GPIO 26, bảng E5 (bỏ hoặc ghi không đo), E6/E7/E1 điền số ở trên.
