NhanHuynh2006/smart-water-tank/slides-en/README.txt

English slide deck, 43 slides (about 36 min full script + 10-15 min demo).
Live deck (present, download as PPTX/PDF): https://claude.ai/artifact/TmihFwubP3Ltox1HqgkGtL

project/            source of every slide; speaker notes = English script
SCRIPT_EN.md        full English script with timings + likely Q&A
KICH_BAN_VI.md      the same script in Vietnamese, for rehearsal
img/                architecture & command diagrams (archify), dashboard screenshot
diagrams/           archify specs (*.json) and chart geometry scripts (level.py, bars.py)

Still to fill: group number on slide 1.
Numbers match the report of 5 Oct (E1 calibration, E6 outage on final firmware, systest, E7 29 ms).
