NhanHuynh2006/smart-water-tank/iot-report-en/fig/architecture.png

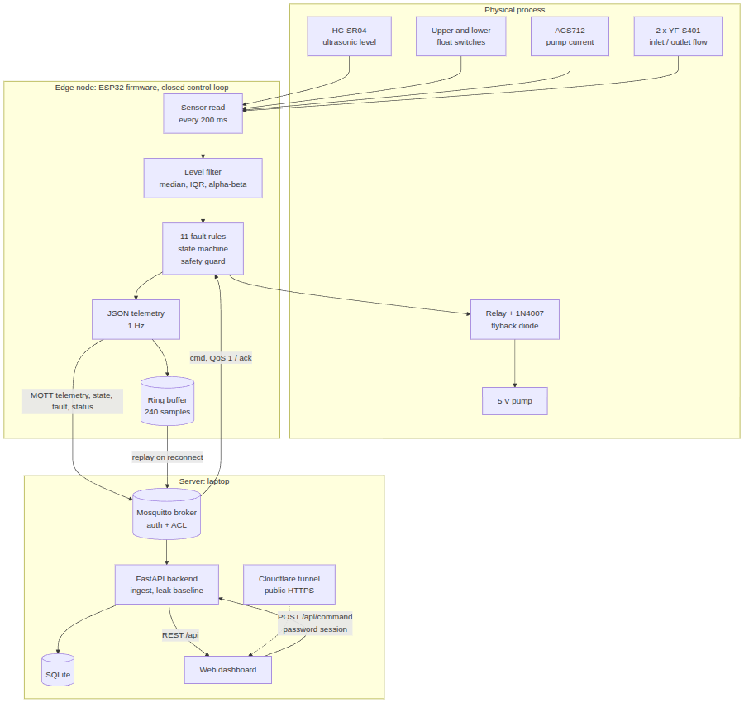
iot-report-en/fig/architecture.png
