NhanHuynh2006/smart-water-tank/iot-report-en/fig/dashboard.png

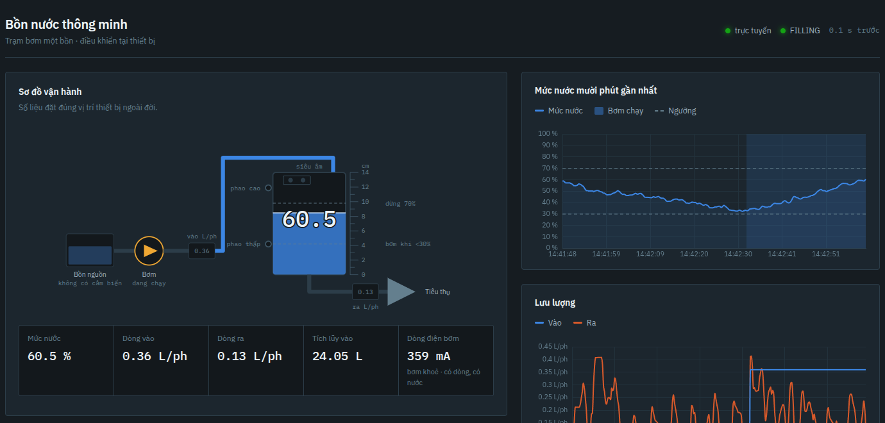
iot-report-en/fig/dashboard.png
