NhanHuynh2006/smart-water-tank/iot-report-en/fig/e7_rtt_hist.png

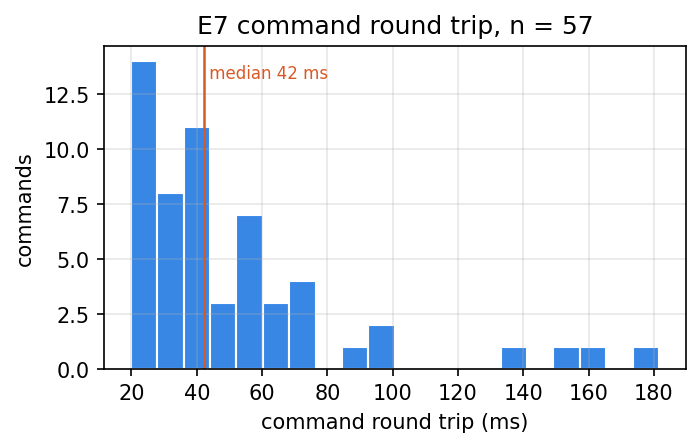
iot-report-en/fig/e7_rtt_hist.png
