NhanHuynh2006/smart-water-tank/slides-en/img/architecture.png

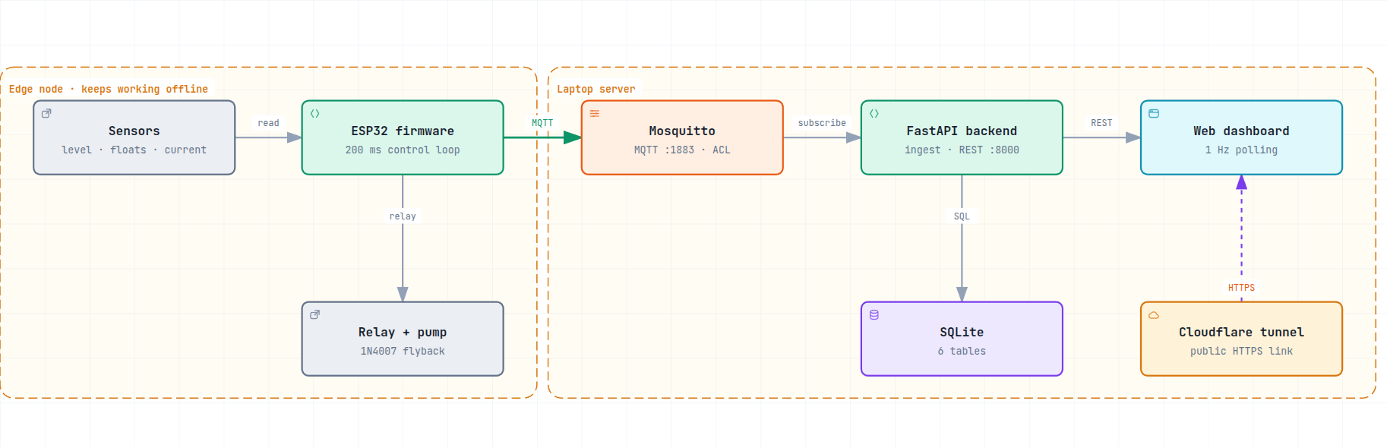
slides-en/img/architecture.png
