NhanHuynh2006/smart-water-tank/slides-en/img/command.png

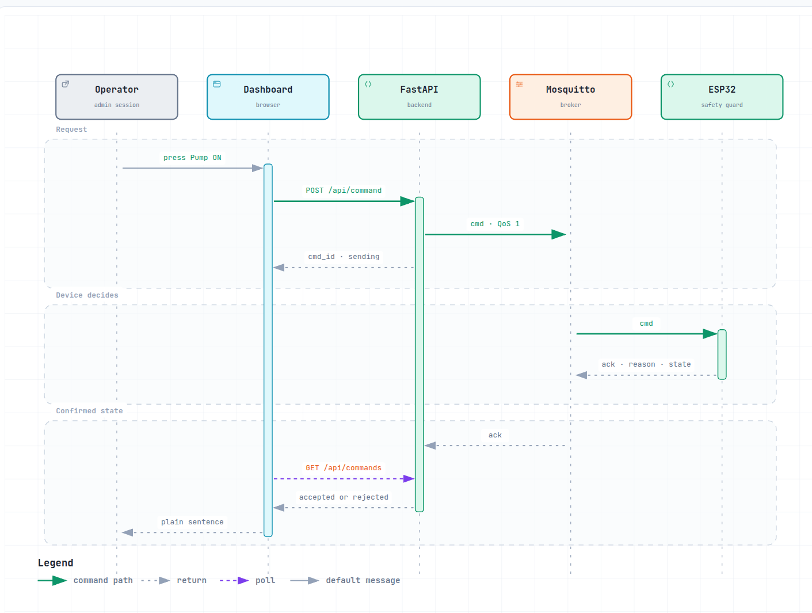
slides-en/img/command.png
