NhanHuynh2006/smart-water-tank/IOT/src/main.cpp

// ============================================================
//  Smart Water Tank - firmware chinh cho ESP32
//  Toan bo luat dieu khien va luat phat hien su co nam o day,
//  nen he van chay dung khi mat ket noi mang.
// ============================================================
#include <Arduino.h>
#include <WiFi.h>
#include <ESPmDNS.h>
#include <PubSubClient.h>
#include <ArduinoJson.h>
#include <Preferences.h>
#include <time.h>
#include <sys/time.h>
#include "config.h"

// ------------------------------------------------------------
//  Trang thai
// ------------------------------------------------------------
enum State { ST_BOOT, ST_IDLE, ST_FILLING, ST_MANUAL_ON,
             ST_FAULT_DRYRUN, ST_FAULT_SENSOR, ST_OVERFLOW_LOCK };

static const char* STATE_NAME[] = {
  "BOOT","IDLE","FILLING","MANUAL_ON",
  "FAULT_DRYRUN","FAULT_SENSOR","OVERFLOW_LOCK" };

State state = ST_BOOT;
bool  autoMode  = true;
bool  pumpOn    = false;
char  faultCode[24] = "";

// ------------------------------------------------------------
//  Do luong
// ------------------------------------------------------------
volatile uint32_t flowPulses = 0;        // cam bien DAU VAO
uint32_t lastPulseSnapshot   = 0;
volatile uint32_t flowOutPulses = 0;     // cam bien DAU RA
// Bo dem xung THO: dem MOI suon xuong, khong qua bo loc nao. Dung de biet
// day tin hieu co dang bat song hay khong.
volatile uint32_t flowRawPulses    = 0;
volatile uint32_t flowOutRawPulses = 0;
uint32_t lastPulseOutSnapshot   = 0;
uint32_t lastRawSnapshot        = 0;
uint32_t lastRawOutSnapshot     = 0;
// false = day tin hieu dang nhieu, so doc luu luong KHONG dung duoc
bool  flowOk = true, flowOutOk = true;

float levelCm   = 0, levelPct = 0;
bool  levelOk   = false;
float flowLpm    = 0;                    // L/phut DAU VAO
float volumeL    = 0, volumeTodayL    = 0;
float flowOutLpm = 0;
float sensorInLpm = 0, sensorOutLpm = 0, sensorInL = 0, sensorOutL = 0;  // cam bien, chi de doi chieu
float volumeOutL = 0, volumeOutTodayL = 0;
float currentMv = 0, currentOffsetMv = 0;
// floatMax = nuoc da cham vach CAO tren bon chua  -> phai ngat bom
// floatMin = nuoc da tut duoi vach THAP tren bon chua -> duoc phep bat bom
bool  floatMax  = false, floatMin = false;

uint32_t lastValidLevelMs = 0;
uint32_t sensorGoodSince  = 0;
float    lastGoodLevelCm  = -1;

// ------------------------------------------------------------
//  Dinh thi
// ------------------------------------------------------------
uint32_t pumpOnSince = 0, pumpOffSince = 0;
uint32_t dryRunSince = 0, noCurrentSince = 0, leakSince = 0;
uint32_t lastControlMs = 0, lastTelemetryMs = 0, lastNvsMs = 0;
// true khi bom chay du lau ma muc KHONG len (nhan no_flow). Cap nhat moi chu
// ky trong loop(); readLevel va mo hinh dung no de bo gia dinh "bom chay thi
// muc phai len" — gia dinh nay sai khi xa ra bang luong bom vao.
bool pumpNoFlow = false;
uint32_t ctlGapMaxMs = 0;     // chu ky dieu khien dai nhat, xem buildTelemetry
uint32_t ringDropped = 0;     // so mau offline bi ghi de vi bo dem day
uint32_t seqNo = 0;

// ------------------------------------------------------------
//  MQTT
// ------------------------------------------------------------
WiFiClient   net;
PubSubClient mqtt(net);
Preferences  prefs;

char topicTelemetry[64], topicPumpState[64], topicFault[64];
char topicStatus[64], topicCmd[64], topicAck[64];

uint32_t nextReconnectMs = 0;
uint8_t  reconnectFails  = 0;

// ------------------------------------------------------------
//  SOCKET CON GHI DUOC KHONG
//  Do tren mach 05/10: cat mang 120 s thi vong dieu khien bi treo 10 GIAY
//  (ctl_gap_ms = 10032). Nguyen nhan: khi broker im lang ma TCP chua bao dut,
//  bo dem gui cua socket day dan, va WiFiClient::write() thu lai 10 lan,
//  moi lan cho select() 1 giay. Trong 10 giay do khong doc cam bien, khong
//  xet chong tran. Kiem tra truoc bang select() voi thoi gian cho bang 0:
//  khong ghi duoc thi KHONG gui, coi nhu mat mang.
// ------------------------------------------------------------
static uint32_t unwritableSince = 0;
static bool netWritable() {
  int fd = net.fd();
  if (fd < 0) return false;
  fd_set set; FD_ZERO(&set); FD_SET(fd, &set);
  struct timeval tv = {0, 0};
  return select(fd + 1, NULL, &set, NULL, &tv) > 0 && FD_ISSET(fd, &set);
}
// Chi gui khi chac chan khong bi chan. Tra ve false neu bo qua.
static bool mqttCanSend() {
  if (!mqtt.connected()) return false;
  if (netWritable()) { unwritableSince = 0; return true; }
  if (unwritableSince == 0) unwritableSince = millis();
  return false;
}

// ------------------------------------------------------------
//  Bo dem vong khi mat mang
// ------------------------------------------------------------
struct Sample {
  uint32_t ts;
  uint32_t seq;
  int16_t  levelPct10;   // phan tram x10
  int16_t  flowLpm100;    // L/phut x100, dau vao
  int16_t  flowOutLpm100; // L/phut x100, dau ra
  uint32_t volumeL100;    // lit x100, dau vao
  uint8_t  flags;        // bit0 pump, bit1 levelOk, bit2 floatMax
  uint8_t  state;
};
Sample  ring[OFFLINE_BUFFER_SIZE];
uint16_t ringHead = 0, ringCount = 0;

void ringPush(const Sample& s) {
  ring[ringHead] = s;
  ringHead = (ringHead + 1) % OFFLINE_BUFFER_SIZE;
  if (ringCount < OFFLINE_BUFFER_SIZE) ringCount++;
  else ringDropped++;          // day: mau cu nhat bi ghi de, dem lai de biet
}

// ------------------------------------------------------------
//  Tien ich
// ------------------------------------------------------------
// Loc xung qua gan nhau. Do tren mach that: khi Wi-Fi bat, hai chan nay bat
// duoc 1600 den 2700 Hz nhieu trong khi khong he co nuoc chay; tat Wi-Fi thi
// dem duoc dung 0. Dien tro keo len NOI BO cua ESP32 khoang 45 kOhm, qua yeu
// de giu muc cao truoc nhieu vo tuyen tren day dan dai.
// YF-S401 o luu luong toi da 6 L/phut chi cho 6 x 98 = 588 Hz, tuc moi xung
// cach nhau it nhat 1,7 ms. Bo qua xung den som hon FLOW_MIN_PULSE_US.
// LUU Y: day CHI la lop phong thu phan mem. Cach sua that la han them dien
// tro keo len NGOAI 4,7 kOhm len 3,3 V, manh gap 10 lan loai noi bo.
volatile uint32_t lastFlowUs = 0, lastFlowOutUs = 0;

void IRAM_ATTR onFlowPulse() {
  uint32_t now = micros();
  flowRawPulses++;
  if (now - lastFlowUs >= FLOW_MIN_PULSE_US) { flowPulses++; lastFlowUs = now; }
}
void IRAM_ATTR onFlowOutPulse() {
  uint32_t now = micros();
  flowOutRawPulses++;
  if (now - lastFlowOutUs >= FLOW_MIN_PULSE_US) { flowOutPulses++; lastFlowOutUs = now; }
}

void setRelay(bool on) {
#if RELAY_ACTIVE_LOW
  digitalWrite(PIN_RELAY, on ? LOW : HIGH);
#else
  digitalWrite(PIN_RELAY, on ? HIGH : LOW);
#endif
}

uint32_t nowTs() {
  time_t t = time(nullptr);
  return (t > 1600000000) ? (uint32_t)t : 0;   // 0 = chua dong bo NTP
}

// Dau thoi gian do phan giai mili giay. Truong "ts" cu chi co do phan giai
// mot giay, nen hieu (recv_ts - ts) bi sai so luong tu hoa toi +-500 ms va
// nhan chim do tre mang that. Truong nay giu nguyen "ts" de khong pha vo
// cac ben doc cu, va bo sung "ts_ms" cho phep do E7.
uint64_t nowTsMs() {
  struct timeval tv;
  if (gettimeofday(&tv, nullptr) != 0) return 0;
  if (tv.tv_sec < 1600000000) return 0;        // 0 = chua dong bo NTP
  return (uint64_t)tv.tv_sec * 1000ULL + (uint64_t)(tv.tv_usec / 1000);
}

// ------------------------------------------------------------
//  Doc cam bien
// ------------------------------------------------------------
float readDistanceOnce() {
  digitalWrite(PIN_TRIG, LOW);  delayMicroseconds(4);
  digitalWrite(PIN_TRIG, HIGH); delayMicroseconds(10);
  digitalWrite(PIN_TRIG, LOW);
  uint32_t dur = pulseIn(PIN_ECHO, HIGH, 30000UL);   // timeout 30 ms
  if (dur == 0) return -1;
  return dur * 0.0343f / 2.0f;                        // cm
}

// Bo loc trung vi 5 mau: loai bo dot bien don le do song mat nuoc
// Trung vi truot. Ban cu phat 5 lan lien tiep cach nhau 6 ms ngay trong mot
// lan goi: vi pham khuyen cao >= 60 ms cua HC-SR04 nen lan phat sau bat phai
// tieng vong con lai cua lan truoc, va ham chan toi 180 ms trong chu ky 200 ms.
// Nay moi chu ky dieu khien phat DUNG MOT lan, cach nhau tron CONTROL_PERIOD_MS
// = 200 ms, va trung vi lay tren cua so LEVEL_MEDIAN_WINDOW mau gan nhat.
static float   levelWin[LEVEL_MEDIAN_WINDOW];
static uint8_t levelWinCount = 0, levelWinHead = 0, levelFailStreak = 0;

// So doc THO cua lan phat gan nhat, chua qua bo loc nao. Chan an toan
// LEVEL_MIN_DISTANCE_CM dung thang so nay, de mot bo loc hong khong the
// lam mat luon lop bao ve cuoi cung. Am nghia la lan phat do khong co tieng doi.
static float   lastRawDistCm = -1.0f;
// Dau ra cua bo loc mu. Am nghia la chua co mau nao de khoi tao.
static float   levelEmaCm    = -1.0f;
// Toc do uoc luong boi bo loc alpha-beta, cm moi giay.
static float    levelVelCmS  = 0.0f;
static uint32_t lastFiltMs   = 0;

// ------------------------------------------------------------
//  DEM LY DO LOAI SO DOC MUC NUOC
//  Khong the sua cai gi minh chua do duoc. Moi cong loc co mot o dem rieng,
//  cong bo ra telemetry, de biet CONG NAO dang loai va loai bao nhieu.
// ------------------------------------------------------------
enum { RJ_ECHO, RJ_GATE, RJ_FEW, RJ_SPREAD, RJ_RANGE, RJ_RATE, RJ_FALL, RJ_REJOIN, RJ_N };
static uint16_t rej[RJ_N] = {0};
static uint16_t levelTries = 0, levelGood = 0;
// Toc do doi muc, cm moi giay. Duong = dang day, am = dang can.
static float   levelRateCmS  = 0.0f;
// Dong xa uoc luong, L/phut. Chi cap nhat khi bom tat va muc da on dinh,
// giu nguyen trong luc bom chay. Dung chung cho dashboard va mo hinh muc.
static float    drainHoldLpm = 0.0f;
static uint32_t pumpOffAtMs  = 0;
static bool     prevPumpOn   = false;
static float   lastRateLevelCm = -1.0f;
static uint32_t lastRateMs   = 0;
// Mo hinh muc nuoc chay song song voi phep do, de coi tiep khi cam bien mat.
static float   levelModelCm  = -1.0f;
static uint32_t blindSinceMs = 0;
// So lan phat LIEN TIEP cho ket qua gan hon LEVEL_MIN_DISTANCE_CM.
static uint8_t tooCloseStreak = 0;

// Moc dau moi lan bom, de do tien do va tong luong da bom trong lan do.
static float   fillStartVolumeL = 0, fillStartLevelCm = -1;
static uint32_t progressMarkMs  = 0;
// Thoi diem levelOk bat dau false trong khi dang bom. 0 = dang co tin hieu.
static uint32_t fillBlindSince  = 0;
static float   progressMarkCm   = -1;

// Cua so truot chi nhan nhung so doc NAM TRONG DAI VAT LY CO THE.
// Mat cam bien cach day bon TANK_SENSOR_TO_BOTTOM_CM, nuoc day nhat thi
// khoang cach con TANK_SENSOR_TO_BOTTOM_CM - TANK_MAX_LEVEL_CM. Ngoai dai
// do cong them bien LEVEL_GATE_MARGIN_CM la nhieu, loai truoc khi vao cua so
// chu khong de no lam ban trung vi.
float medianOf5() {
  // Khong bao gio nhan so doc duoi 3 cm vao cua so trung vi: HC-SR04 co vung
  // mu 2 cm, gan hon the la rac chu khong phai phep do. Chan an toan
  // waterTooClose doc thang khoang cach tho nen van bat duoc truong hop nuoc
  // that su len qua cao, khong phu thuoc cua so nay.
  const float dFloor = 3.0f;
  float dMin = TANK_SENSOR_TO_BOTTOM_CM - TANK_MAX_LEVEL_CM - LEVEL_GATE_MARGIN_CM;
  if (dMin < dFloor) dMin = dFloor;
  // Nuoc khong the o duoi day bon. So doc xa hon day qua LEVEL_FLOOR_MARGIN_CM
  // la tieng doi lac (do 05/10: nuoc that cach cam bien 8 cm ma doc 21,3 cm).
  const float dMax = TANK_SENSOR_TO_BOTTOM_CM + LEVEL_FLOOR_MARGIN_CM;

  float d = readDistanceOnce();
  lastRawDistCm = d;
  levelTries++;
  if (d < 0) rej[RJ_ECHO]++;
  else if (d < dMin || d > dMax) rej[RJ_GATE]++;
  // Chi dem khi CO tieng doi. Lan phat khong co tieng doi khong noi len dieu
  // gi ve muc nuoc, va khong duoc phep lam dut chuoi lan cung khong.
  if (d > 0) {
    if (d < LEVEL_MIN_DISTANCE_CM) { if (tooCloseStreak < 255) tooCloseStreak++; }
    else tooCloseStreak = 0;
  }
  bool good = (d > 0) && (d >= dMin) && (d <= dMax);

  if (good) {
    levelWin[levelWinHead] = d;
    levelWinHead = (levelWinHead + 1) % LEVEL_MEDIAN_WINDOW;
    if (levelWinCount < LEVEL_MEDIAN_WINDOW) levelWinCount++;
    levelFailStreak = 0;
  } else {
    // Vai lan hong roi rac thi bo qua, cua so cu van dung. Hong LIEN TIEP
    // moi co nghia la mat cam bien that, luc do xoa han cua so de levelOk
    // chuyen sang false va luat SENSOR_TIMEOUT co co hoi phat.
    if (levelFailStreak < 255) levelFailStreak++;
    if (levelFailStreak >= LEVEL_FAIL_STREAK_MAX) { levelWinCount = 0; return -1; }
  }
  // Can it nhat mot nua cua so truoc khi dam lay trung vi. Voi cua so 9 mau
  // la 5 mau: du de 4 mau hong lien tiep khong lam lech ket qua.
  if (levelWinCount < (LEVEL_MEDIAN_WINDOW + 1) / 2) { rej[RJ_FEW]++; return -1; }

  // Chep levelWinCount mau MOI NHAT, di nguoc tu dau ghi. Chep tu chi so 0
  // la sai khi vong dem da quay vong: cac o dau khong con la mau moi nhat.
  float v[LEVEL_MEDIAN_WINDOW];
  for (uint8_t i = 0; i < levelWinCount; i++)
    v[i] = levelWin[(levelWinHead + LEVEL_MEDIAN_WINDOW - 1 - i) % LEVEL_MEDIAN_WINDOW];

  for (uint8_t i = 0; i + 1 < levelWinCount; i++)
    for (uint8_t j = i + 1; j < levelWinCount; j++)
      if (v[j] < v[i]) { float t = v[i]; v[i] = v[j]; v[j] = t; }

  // Cua so trai ra qua rong thi cac mau khong noi ve cung mot mat nuoc.
  // Tra ve -1 de bao KHONG DOC DUOC, chu khong dam lay trung vi cua hai nhom
  // xap xi bang nhau — trung vi luc do chi la mot lan tung dong xu.
#if !LEVEL_TRUST_ALWAYS
  // Do phan tan bang KHOANG TU PHAN VI, khong bang max - min.
  //
  // Do ngay 23/09 trong mot lan bom binh thuong: 605 lan phat, 244 bi loai,
  // va 98 phan tram so bi loai la do chinh cong nay. Khong co tieng doi chi
  // chiem 2 phan tram — cam bien tra ve gan nhu moi lan.
  //
  // Nguyen nhan: max - min nhay voi DUY NHAT mot tieng doi lac. Mot mau trong
  // 15 doi tu day thung la du bi vut ca cua so. Dung bo loc trung vi — von de
  // chiu duoc nhieu le — roi chan no bang thuoc do nhay voi nhieu le nhat la
  // tu pha chinh minh.
  //
  // Khoang tu phan vi bo qua mot phan tu cao nhat va mot phan tu thap nhat.
  // Vai tieng doi lac khong lam no nhuc nhich. No chi lon ra khi cam bien
  // that su nhay giua hai che do — mat nuoc va day thung — khoang nua so mau
  // moi ben, dung truong hop can tu choi.
  uint8_t q1 = levelWinCount / 4, q3 = (levelWinCount * 3) / 4;
  if (q3 >= levelWinCount) q3 = levelWinCount - 1;
  if (v[q3] - v[q1] > LEVEL_SPREAD_MAX_CM) { rej[RJ_SPREAD]++; return -1; }
#endif

  return v[(levelWinCount * LEVEL_PICK_PCT) / 100];
}

// Mot lan phat hong KHONG co nghia la mat cam bien. Giu so doc hop le cuoi
// them LEVEL_STALE_MS nua roi moi ha co levelOk.
void markLevelStale() {
  // lastGoodLevelCm >= 0: da CO it nhat mot so do that. Thieu dieu kien nay
  // thi ngay sau khi khoi dong levelOk bang true (setup() dat lastValidLevelMs
  // = millis() de tinh SENSOR_TIMEOUT tu luc bat may) trong khi levelPct van
  // la 0 — bo dieu khien thay "bon can" va BAT BOM sau moi lan khoi dong, bat
  // ke bon dang day bao nhieu. Thay trong du lieu 23/09: moi lan khoi dong lai
  // deu co mot lan bom bat o seq 2 voi muc 0,0 %.
  levelOk = (lastGoodLevelCm >= 0) && (lastValidLevelMs != 0) &&
            (millis() - lastValidLevelMs <= LEVEL_STALE_MS);
  // Mat han cam bien thi xoa bo loc. Neu khong, luc tin hieu quay lai no se
  // keo dau ra tu gia tri cu sang gia tri moi trong suot ba giay, va muc nuoc
  // hien tren giao dien se troi tu tu qua mot khoang cham khong he co that.
  if (!levelOk) levelEmaCm = -1.0f;
}

void readLevel() {
  float d = medianOf5();
  if (d < 0) { markLevelStale(); return; }

  float h = TANK_SENSOR_TO_BOTTOM_CM - d;
  h = LEVEL_CAL_A * h + LEVEL_CAL_B;

  // Loc so doc phi vat ly ngay tai nguon
  if (h < -LEVEL_GATE_MARGIN_CM || h > TANK_MAX_LEVEL_CM + 2.0f) { rej[RJ_RANGE]++; markLevelStale(); return; }

  // Tieng doi tro ve tu DAY bon hoac xa hon nghia la KHONG CO NUOC, chu khong
  // phai la phep do hong. Thung 10 x 10 cm hep hon chum song 15 do cua
  // HC-SR04 o khoang 15,5 cm, nen luc can nuoc tia song danh vao THANH thung
  // roi moi doi ve, thanh ra xa hon day that — do duoc 21 cm thay vi 15,5 cm.
  //
  // Neu coi do la loi thi bon can se khong bao gio do duoc, bom khong bao gio
  // duoc phep chay, va he thong thanh vo dung. Vay coi la muc 0.
  // An toan khong mat gi: neu cam bien that su hong theo kieu tra so qua lon,
  // luat NO_PROGRESS ngat bom sau NO_PROGRESS_MS vi muc khong nhich len.
  //
  // Phai ep ve 0 TRUOC khi kiem tra toc do doi muc, neu khong so am se bi
  // hieu la muc nhay 6 cm trong mot chu ky va bi loai oan.
  if (h < 0) h = 0;

#if !LEVEL_TRUST_ALWAYS
  if (lastGoodLevelCm >= 0) {
    float dt = (millis() - lastValidLevelMs) / 1000.0f;
    // Gioi han = phan do nuoc that su co the troi trong khoang dt, CONG
    // them sai so cua rieng phep do. Thieu ve sau thi nhieu tung mau bi
    // hieu nham la cam bien hong.
    float allowed = MAX_LEVEL_RATE_CMS * dt + LEVEL_NOISE_CM;
    if (dt > 0.05f && fabs(h - lastGoodLevelCm) > allowed) {
      rej[RJ_RATE]++; markLevelStale(); return;
    }
    // Cong khong doi xung khi dang bom. Bom day 0,36 L/phut con xa trong luc
    // chi 0,147 L/phut, nen muc BAT BUOC phai len — moi so doc tut xuong deu
    // la sai. Cong doi xung o tren khong bat duoc chuoi truot dan cua cam
    // bien, vi tung buoc mot deu nam duoi gioi han cua no.
    // NHUNG gia dinh "dang bom thi muc phai len" sai khi xa ra bang luong bom
    // vao (do 05/10: bom 0,32 L/phut, xa ~0,3 L/phut, muc dung o ~52 %).
    // Luc do moi so doc thap hon lastGoodLevelCm qua 1 cm deu bi loai, ma
    // lastGoodLevelCm lai khong bao gio cap nhat — cong tu KHOA CHET, thiet
    // bi mu 40 s roi bao SENSOR_TIMEOUT du day cam van cam. Mot cu tut that
    // thi lap lai on dinh, con mot tieng doi lac thi khong: cho qua khi cong
    // nay da chan lien tiep FALL_ACCEPT_STREAK lan (2 s).
    static uint8_t fallStreak = 0;
    static float   fallRef    = -1;
    // So voi muc DA LOC (levelEmaCm), khong so voi mot mau le: mau le co the
    // la dinh nhieu, va so voi no thi muc that hoi thap hon cung bi chan mai.
    float ref = (levelEmaCm >= 0) ? levelEmaCm : lastGoodLevelCm;
    if (pumpOn && dt > 0.05f && (ref - h) > LEVEL_FALL_PUMPING_CM) {
      // Tut that thi cac so doc nam sat nhau; tieng doi lac (do 05/10: luc
      // bom chay lau, cam bien bao muc tu 22 % roi 12 % trong khi nuoc that
      // o 55 %) thi nhay lung tung. Chi chap nhan chuoi on dinh.
      if (fallRef >= 0 && fabs(h - fallRef) < 1.0f) fallStreak++;
      else fallStreak = 0;
      fallRef = h;
      if (FALL_ACCEPT_STREAK >= 255 || fallStreak < FALL_ACCEPT_STREAK) {
        rej[RJ_FALL]++; markLevelStale(); return;
      }
      fallStreak = 0; fallRef = -1;   // chuoi on dinh: tut that
    } else {
      fallStreak = 0; fallRef = -1;
    }
  }

  // Quay lai sau mot doan mat cam bien: doi chieu voi mo hinh truoc khi tin.
  // Trong doan mat, mo hinh la thu duy nhat con biet muc nuoc o dau; neu nhan
  // bua so doc dau tien quay ve thi chinh mo hinh bi keo sup theo.
  // Nhung mo hinh cung co the sai: no gia dinh bom day dung PUMP_FILL_LPM,
  // nen khi xa ra bang luong bom vao thi mo hinh cu tang con muc that dung
  // yen, va cong nay chan mai moi so doc that (do 05/10). So doc that ma
  // ON DINH (lech nhau duoi 1 cm) lien tiep JOIN_ACCEPT_STREAK lan thi tin
  // so do, keo mo hinh ve theo.
  static uint8_t joinStreak = 0;
  static float   joinRef    = -1;
  if (blindSinceMs != 0 && levelModelCm >= 0 &&
      fabs(h - levelModelCm) > MODEL_REJOIN_CM) {
    if (joinRef >= 0 && fabs(h - joinRef) < 1.0f) joinStreak++;
    else joinStreak = 0;
    joinRef = h;
    if (JOIN_ACCEPT_STREAK >= 255 || joinStreak < JOIN_ACCEPT_STREAK) {
      rej[RJ_REJOIN]++; markLevelStale(); return;
    }
    levelModelCm = h;          // so do on dinh thang: mo hinh da troi
    joinStreak = 0; joinRef = -1;
  } else {
    joinStreak = 0; joinRef = -1;
  }

  {
  }
#endif

  // h la so doc THO sau trung vi. Cac cong xac thuc o tren deu so voi no,
  // va lastGoodLevelCm cung luu no — neu so voi dau ra da lam muot thi cong
  // chan toc do se tu so voi chinh phien ban tre cua minh va mat tac dung.
  lastGoodLevelCm  = h;
  lastValidLevelMs = millis();
  levelOk  = true;
  levelGood++;

  // Trung vi loai dot bien nhung KHONG lam muot. Trung binh truot mu moi lam
  // muot. Mau dau tien nhay thang vao, khong co gi de trung binh voi no.
  // Bo loc ALPHA-BETA thay cho trung binh truot mu.
  //
  // Nguoi dung thay so muc nuoc nhay len roi xuong roi len, ca luc xa lan luc
  // bom, trong khi nuoc that chi di MOT chieu. Trung binh truot mu chi biet
  // keo dau ra ve phia so moi, nen moi dot nhieu +-0,3 cm deu day no nguoc
  // chieu mot chut. Nuoc xa that chi tut 0,12 cm moi 5 giay, nho hon nhieu.
  //
  // Alpha-beta theo doi CA muc nuoc LAN toc do. No du bao diem ke tiep theo
  // xu huong, roi chi sua mot phan nho theo sai lech. Voi muc nuoc doi deu —
  // dung la luc bom hay xa — no khong bi tre, va nhieu khong day duoc no
  // nguoc chieu. beta = alpha^2 / (2 - alpha) cho dap ung tat dan toi han.
  uint32_t nowF = millis();
  if (levelEmaCm < 0) {
    levelEmaCm = h; levelVelCmS = 0; lastFiltMs = nowF;
  } else {
    float dtF = (nowF - lastFiltMs) / 1000.0f;
    lastFiltMs = nowF;
    if (dtF > 2.0f) dtF = 2.0f;
    if (dtF > 0.01f) {
      const float a = LEVEL_AB_ALPHA;
      const float b = a * a / (2.0f - a);
      float pred = levelEmaCm + levelVelCmS * dtF;
      float r    = h - pred;
      levelEmaCm  = pred + a * r;
      levelVelCmS += (b / dtF) * r;
      // Toc do that khong the vuot gioi han vat ly cua bom va van xa.
      if (levelVelCmS >  MAX_LEVEL_RATE_CMS) levelVelCmS =  MAX_LEVEL_RATE_CMS;
      if (levelVelCmS < -MAX_LEVEL_RATE_CMS) levelVelCmS = -MAX_LEVEL_RATE_CMS;
    }
  }

  levelCm  = levelEmaCm;
  levelPct = (levelEmaCm / TANK_MAX_LEVEL_CM) * 100.0f;
  if (levelPct > 100) levelPct = 100;
  if (levelPct < 0)   levelPct = 0;

  // Toc do doi muc lay thang tu bo loc alpha-beta: no da duoc uoc luong cung
  // voi muc nuoc, khong phai lay hieu hai so doc roi lam muot lai lan nua.
  levelRateCmS = levelVelCmS;
}

// ------------------------------------------------------------
//  MO HINH MUC NUOC CHAY SONG SONG
//  Co so do that thi keo mo hinh ve so do. Mat cam bien thi mo hinh tu chay
//  tiep, va may trang thai dieu khien theo no thay vi ngat bom ngay.
// ------------------------------------------------------------
void updateDrainEstimate() {
  uint32_t now = millis();
  if (prevPumpOn && !pumpOn) pumpOffAtMs = now;          // vua tat bom
  if (!pumpOn && pumpOffAtMs == 0) pumpOffAtMs = now;     // luc khoi dong
  prevPumpOn = pumpOn;

  bool settled = !pumpOn && levelOk && (now - pumpOffAtMs > DRAIN_SETTLE_MS);
  if (!settled) return;                                   // giu so cu
  float netLpm = levelRateCmS * TANK_AREA_CM2 * 60.0f / 1000.0f;   // am khi xa
  float inst   = netLpm < 0 ? -netLpm : 0.0f;
  drainHoldLpm += (inst - drainHoldLpm) * DRAIN_EMA_ALPHA;
}

void updateLevelModel(uint32_t dtMs) {
  updateDrainEstimate();
  float dt = dtMs / 1000.0f;

  if (levelModelCm < 0) {                 // chua khoi tao
    if (levelOk) levelModelCm = levelCm;
    return;
  }

  // Du bao: bom day vao voi luu luong da hieu chuan, va nuoc xa ra theo toc
  // do quan sat duoc gan nhat luc bom tat.
  // Bom chay ma bang chung cho thay muc khong len thi mo hinh cung khong
  // duoc tu y cong them nuoc, neu khong no troi xa khoi so do that.
  // Luu luong vao: lay tu CAM BIEN dau vao khi no dang do duoc (05/10: het
  // nhieu, da hieu chuan K theo thuoc). Mo hinh chinh xac thi cong "lech mo
  // hinh" moi chan duoc tieng doi lac o vung mu ma khong chan nham muc that.
  float inLpm = (sensorInLpm > 0.05f) ? sensorInLpm
              : ((pumpOn && !pumpNoFlow) ? PUMP_FILL_LPM : 0.0f);
  float fillCmS = inLpm * 1000.0f / 60.0f / TANK_AREA_CM2;
  // Dung chung uoc luong dong xa voi dashboard, doi ra cm/s.
  float drainCmS = drainHoldLpm * 1000.0f / 60.0f / TANK_AREA_CM2;
  levelModelCm += (fillCmS - drainCmS) * dt;

  if (levelModelCm < 0) levelModelCm = 0;
  if (levelModelCm > TANK_MAX_LEVEL_CM) levelModelCm = TANK_MAX_LEVEL_CM;

  if (levelOk) {
    levelModelCm += (levelCm - levelModelCm) * MODEL_CORRECT_ALPHA;
    blindSinceMs = 0;
  } else if (blindSinceMs == 0) {
    blindSinceMs = millis();
  }
}

// Phan tram dung de DIEU KHIEN: so do that khi co, mo hinh khi mat cam bien.
float controlPct() {
  if (levelOk) return levelPct;
  if (levelModelCm >= 0) return (levelModelCm / TANK_MAX_LEVEL_CM) * 100.0f;
  return 0;
}

void readFlow(uint32_t dtMs) {
  noInterrupts();
  uint32_t p  = flowPulses,    pr  = flowRawPulses;
  uint32_t po = flowOutPulses, por = flowOutRawPulses;
  interrupts();

  uint32_t d     = p  - lastPulseSnapshot;     lastPulseSnapshot    = p;
  uint32_t dOut  = po - lastPulseOutSnapshot;  lastPulseOutSnapshot = po;
  uint32_t dRaw  = pr - lastRawSnapshot;       lastRawSnapshot      = pr;
  uint32_t dRawO = por - lastRawOutSnapshot;   lastRawOutSnapshot   = por;

  float inv = (dtMs > 0) ? (1000.0f / dtMs) : 0;

  // Tan so THO quyet dinh so doc co dung duoc hay khong. Vuot qua nguong
  // vat ly nghia la day tin hieu dang bat song chu khong phai co nuoc chay.
#if FLOW_FROM_LEVEL
  // Van doc hai cam bien de DOI CHIEU, khong dung cho dieu khien. Do 05/10:
  // sau khi doi day, nhieu 1500 Hz luc bom chay da het (dau vao 29,8 Hz khi
  // bom chay, 0 Hz khi tat), nen so cua cam bien dang duoc ghi lai song song.
  {
    float a = 0.2f;
    sensorInLpm  += ((d    * inv) / FLOW_K_FACTOR     - sensorInLpm)  * a;
    sensorOutLpm += ((dOut * inv) / FLOW_OUT_K_FACTOR - sensorOutLpm) * a;
    sensorInL  += (d    / FLOW_K_FACTOR)     / 60.0f;   // xung / (K*60) = lit
    sensorOutL += (dOut / FLOW_OUT_K_FACTOR) / 60.0f;
  }
  // Bo han hai cam bien luu luong. Dau vao la hang so da hieu chuan khi bom
  // chay; dau ra suy nguoc tu toc do doi muc:
  //     luu luong rong = toc do doi muc x tiet dien x 60 / 1000
  //     dau ra         = luu luong bom - luu luong rong
  // Bom tat ma muc van tut thi luu luong rong am, va dau ra chinh la phan tut.
  flowLpm    = pumpOn ? PUMP_FILL_LPM : 0.0f;
  // Dau ra la dong xa da uoc luong luc bom tat, KHONG phai hieu so tuc thi
  // giua bom va toc do doi muc. Xem giai thich o DRAIN_SETTLE_MS.
  flowOutLpm = drainHoldLpm;

  flowOk    = true;       // hang so hieu chuan, luon dung duoc
  flowOutOk = levelOk;    // chi dang tin khi muc nuoc dang doc duoc

  float addIn  = flowLpm    * (dtMs / 1000.0f) / 60.0f;
  volumeL      += addIn;
  volumeTodayL += addIn;
  if (flowOutOk) {
    float addOut = flowOutLpm * (dtMs / 1000.0f) / 60.0f;
    volumeOutL      += addOut;
    volumeOutTodayL += addOut;
  }
  return;
#elif FLOW_SENSOR_ENABLED
  flowOk    = (dRaw  * inv) <= FLOW_MAX_PLAUSIBLE_HZ;
  flowOutOk = (dRawO * inv) <= FLOW_MAX_PLAUSIBLE_HZ;
#else
  flowOk = flowOutOk = false;   // chua dau xong, khong tin so doc nao het
#endif

  if (flowOk) {
    flowLpm = (d * inv) / FLOW_K_FACTOR;
    float addL = flowLpm * (dtMs / 1000.0f) / 60.0f;
    volumeL      += addL;
    volumeTodayL += addL;
  } else {
    // Bao 0 va KHONG cong don. Cong don so rac vao bo dem the tich la cach
    // chac chan nhat de pha hong rang buoc an toan theo the tich.
    flowLpm = 0;
  }

  if (flowOutOk) {
    flowOutLpm = (dOut * inv) / FLOW_OUT_K_FACTOR;
    float addOut = flowOutLpm * (dtMs / 1000.0f) / 60.0f;
    volumeOutL      += addOut;
    volumeOutTodayL += addOut;
  } else {
    flowOutLpm = 0;
  }
}

// Chi dung o dang nhi phan: do phan giai khong du cho gia tri dinh luong
void readCurrent() {
  uint32_t acc = 0;
  for (int i = 0; i < 200; i++) acc += analogRead(PIN_CURRENT);
  float mv = (acc / 200.0f) * 3300.0f / 4095.0f;
  currentMv = fabs(mv - currentOffsetMv);

  // Diem nghi cua ACS712 KHONG dung yen. Do thuc te tren mach nay thay no
  // troi 32 mV trong 20 giay dau sau khi cap nguon, tuc lon hon ca nguong
  // nhan biet 15 mV. Hieu chuan mot lan duy nhat luc khoi dong la khong du:
  // sau vai phut moi phep so sanh deu lech theo.
  // Nen bam theo diem nghi bang trung binh truot cham, chi cap nhat KHI BOM
  // DANG TAT. Bom chay thi dung cap nhat, neu khong no se hoc luon ca dong
  // cua bom va lam luat NO_CURRENT mu han.
  if (!pumpOn) {
    currentOffsetMv += (mv - currentOffsetMv) * CURRENT_OFFSET_ALPHA;
  }
}

void readFloats() {
#if FLOAT_MAX_ACTIVE_LOW
  floatMax = (digitalRead(PIN_FLOAT_MAX) == LOW);
#else
  floatMax = (digitalRead(PIN_FLOAT_MAX) == HIGH);
#endif
#if FLOAT_MIN_ACTIVE_LOW
  floatMin = (digitalRead(PIN_FLOAT_MIN) == LOW);
#else
  floatMin = (digitalRead(PIN_FLOAT_MIN) == HIGH);
#endif
}

// ------------------------------------------------------------
//  PHAN LOAI SUC KHOE BOM
//  Tu tinh nhat quan giua dong dien va dong chay. Chi la NHAN chan doan de
//  cong bo; viec ngat bom van do cac luat NO_CURRENT, DRY_RUN va NO_PROGRESS
//  lam. Moi su co cong bo kem nhan nay, nen biet ngay hong phan dien hay
//  hong phia nuoc.
// ------------------------------------------------------------
enum PumpHealth { PH_IDLE, PH_STARTING, PH_OK, PH_NO_CURRENT, PH_NO_FLOW, PH_DRY };
const char* PUMP_HEALTH_NAME[] = { "idle", "starting", "ok", "no_current", "no_flow", "dry" };

PumpHealth pumpHealth() {
  static PumpHealth last = PH_IDLE;
  if (!pumpOn) return last = PH_IDLE;
  uint32_t on = millis() - pumpOnSince;
  if (on < PUMP_START_MS) return last = PH_STARTING;       // xung dong, ro le
  if (currentMv < CURRENT_ON_MV) return last = PH_NO_CURRENT;
  // Co dong nhung thap han muc bom ngap nuoc: dong co quay khong tai.
  if (currentMv * CURRENT_MA_PER_MV < DRY_CURRENT_MA) return last = PH_DRY;

  bool evidence;
#if FLOW_FROM_LEVEL
  // Mat muc nuoc thi khong ket luan duoc gi ve dong chay: giu nhan cu.
  if (!levelOk) return last;
  evidence = levelRateCmS > FLOW_EVIDENCE_CMS;
#else
  evidence = flowOk && flowLpm >= DRYRUN_FLOW_LPM;
#endif
  if (on < FLOW_EVIDENCE_MS) return last = (evidence ? PH_OK : PH_STARTING);
  return last = (evidence ? PH_OK : PH_NO_FLOW);
}

// ------------------------------------------------------------
//  CHAN AN TOAN CUNG
//  Chay MOI chu ky, truoc may trang thai, va khong dua vao levelOk,
//  vao trung vi hay vao phao. Chi can MOT trong cac dieu kien nay dung
//  la bom bi ngat ngay trong chu ky do.
// ------------------------------------------------------------
bool waterTooClose() {
  return tooCloseStreak >= TOO_CLOSE_STREAK;
}

// ------------------------------------------------------------
//  RAO AN TOAN
//  Moi duong dan co the bat bom deu phai di qua ham nay.
//  Tra ve nullptr neu duoc phep, tra ve ma ly do neu bi chan.
// ------------------------------------------------------------
const char* pumpBlockReason() {
  if (faultCode[0] != '\0')                 return "fault_active";
  if (floatMax)                             return "float_max_triggered";
  if (waterTooClose())                      return "water_too_close";
  if (levelOk && levelPct >= LEVEL_OVERFLOW_PCT) return "overflow_guard";
  // Bom DANG chay ma cam bien vua mat tin hieu (vung mu ~7-8 cm): cho chay
  // tiep theo mo hinh nhu che do tu dong, toi da MODEL_MAX_BLIND_MS, va chan
  // tran theo muc mo hinh. Truoc day bom tay bi ngat moi lan di qua vung mu,
  // khong bao gio len duoc toi phao tren.
  // Bat MOI khi dang mu cung cho phep, mien la mo hinh hop le: neu khong,
  // nuoc dung yen trong vung mu thi bom tay khong bao gio bat duoc (06/10).
  // Thoi gian mu tinh tu luc bom bat, nen moi lan bat chi duoc chay mu toi
  // da MODEL_MAX_BLIND_MS; phao tren va khoang cach tho van chan tran.
  uint32_t blindFor = blindSinceMs ? millis() - blindSinceMs : 0;
  if (pumpOn && millis() - pumpOnSince < blindFor) blindFor = millis() - pumpOnSince;
  bool modelBridge = !levelOk && levelModelCm >= 0 &&
                     (!pumpOn || blindFor < MODEL_MAX_BLIND_MS);
  if (modelBridge && controlPct() >= LEVEL_OVERFLOW_PCT) return "overflow_guard";
  if (!levelOk && !modelBridge)             return "level_sensor_invalid";
  if (!pumpOn && pumpOffSince && millis() - pumpOffSince < MIN_OFF_MS)
                                            return "min_off_time";
  return nullptr;
}

void publishPumpState();

bool startPump() {
  if (pumpBlockReason() != nullptr) return false;
  if (!pumpOn) {
    pumpOn = true; setRelay(true);
    pumpOnSince = millis();
    dryRunSince = noCurrentSince = 0;
    fillStartVolumeL = volumeL;
    fillBlindSince   = 0;
    fillStartLevelCm = levelOk ? levelCm : -1;
    progressMarkMs   = pumpOnSince;
    progressMarkCm   = levelOk ? levelCm : -1;
    publishPumpState();
  }
  return true;
}

void stopPump() {
  if (pumpOn) {
    pumpOn = false; setRelay(false);
    pumpOffSince = millis();
    publishPumpState();
  }
}

void raiseFault(const char* code) {
  if (strcmp(faultCode, code) == 0) return;
  strncpy(faultCode, code, sizeof(faultCode) - 1);
  // Chup nhan suc khoe bom TRUOC khi ngat: sau stopPump() nhan chi con "idle".
  const char* health = PUMP_HEALTH_NAME[pumpHealth()];
  stopPump();

  StaticJsonDocument<256> doc;
  doc["dev"]  = DEVICE_ID;
  doc["code"] = code;
  doc["pump_health"] = health;
  doc["current_ma"]  = (currentMv < CURRENT_NOISE_MV) ? 0.0f : currentMv * CURRENT_MA_PER_MV;
  doc["ts"]   = nowTs();
  doc["level_pct"] = levelPct;
  doc["flow_lpm"]  = flowLpm;
  char buf[256]; size_t n = serializeJson(doc, buf);
  if (n >= sizeof(buf) - 1) Serial.println("[LOI] ban tin su co bi cat");
  if (mqttCanSend()) mqtt.publish(topicFault, (uint8_t*)buf, n, false);

  digitalWrite(PIN_LED_FAULT, HIGH);
  Serial.printf("[FAULT] %s\n", code);
}

// ------------------------------------------------------------
//  BAY LUAT PHAT HIEN SU CO, kiem tra theo thu tu uu tien
// ------------------------------------------------------------
void checkFaults() {
  uint32_t now = millis();

  // 1. Mat tin hieu cam bien muc
  // lastValidLevelMs == 0 nghia la chua tung doc duoc mau hop le nao ke tu khi
  // khoi dong. Ban cu doi dieu kien nay khac 0 nen thiet bi dut day cam bien
  // ngay tu dau se KHONG BAO GIO bao loi, chi im lang khong chay bom.
  uint32_t sinceValid = lastValidLevelMs ? (now - lastValidLevelMs) : now;

  // MAU THUAN DA SUA. Luat nay cat o SENSOR_TIMEOUT_MS = 9 giay, trong khi
  // mo hinh muc nuoc duoc phep chay mu toi MODEL_MAX_BLIND_MS = 45 giay.
  // Ket qua la mo hinh KHONG BAO GIO duoc dung toi: bom luon bi ngat o giay
  // thu 9, dung cai tinh huong ma mo hinh sinh ra de vuot qua.
  //
  // Dang bom va mo hinh con dung duoc thi cho theo cua so cua mo hinh. Luc
  // ranh roi thi van la 9 giay, vi khong co gi phai vuot qua ca.
  // Mo hinh con dung duoc (dang bom HOAC dang ranh) thi cho theo cua so cua
  // mo hinh. Do 05/10: co mot VUNG MU khi mat nuoc cach cam bien ~8-9 cm,
  // muc di qua vung nay mat 40-75 s ca luc bom lan luc xa.
  uint32_t levelTimeoutMs =
      (levelModelCm >= 0) ? MODEL_MAX_BLIND_MS : SENSOR_TIMEOUT_MS;
  if (!levelOk && sinceValid > levelTimeoutMs) {
    raiseFault("SENSOR_TIMEOUT"); state = ST_FAULT_SENSOR; return;
  }
  // 2. Mau thuan giua phao va sieu am, ca hai chieu
  if (floatMax && levelOk && levelPct < CONFLICT_LEVEL_PCT) {
    raiseFault("SENSOR_CONFLICT"); state = ST_FAULT_SENSOR; return;
  }
  // Phao muc thap bao da tut duoi vach thap ma sieu am lai bao con day:
  // mot trong hai dang hong, khong duoc tin cai nao het.
  if (floatMin && levelOk && levelPct > CONFLICT_MIN_PCT) {
    raiseFault("SENSOR_CONFLICT"); state = ST_FAULT_SENSOR; return;
  }
  // 3. Chong tran. Ba duong doc lap: phao, phan tram da loc, va khoang cach
  //    tho. Chi can mot duong bao la khoa, khong doi hai duong dong y.
  if (floatMax || waterTooClose() || (levelOk && levelPct >= LEVEL_OVERFLOW_PCT)) {
    raiseFault("OVERFLOW"); state = ST_OVERFLOW_LOCK; return;
  }
  // 4. Bom chay kho
  // Khi suy luu luong tu muc nuoc thi dau vao la mot HANG SO hieu chuan, nen
  // no khong bao gio tut duoi nguong va luat nay khong con y nghia. Tat han
  // con hon de no nam do gia vo canh gac. Chay kho van duoc bat bang
  // NO_CURRENT va NO_PROGRESS, ca hai dua tren dai luong do that.
#if !FLOW_FROM_LEVEL
  if (pumpOn && flowOk) {
    if (flowLpm < DRYRUN_FLOW_LPM) {
      if (dryRunSince == 0) dryRunSince = now;
      else if (now - dryRunSince > DRYRUN_MS) {
        raiseFault("DRY_RUN"); state = ST_FAULT_DRYRUN; return;
      }
    } else dryRunSince = 0;
  } else dryRunSince = 0;
#endif

  // 4b. Bom chay kho theo DONG DIEN: co dong (khong phai dut day) nhung thap
  //     hon han muc luc bom day nuoc. Nhanh hon NO_PROGRESS rat nhieu.
  static uint32_t dryCurrentSince = 0;
  if (pumpOn && now - pumpOnSince >= PUMP_START_MS &&
      currentMv >= CURRENT_ON_MV && currentMv * CURRENT_MA_PER_MV < DRY_CURRENT_MA) {
    if (dryCurrentSince == 0) dryCurrentSince = now;
    else if (now - dryCurrentSince > DRY_CURRENT_MS) {
      dryCurrentSince = 0;
      raiseFault("DRY_RUN"); state = ST_FAULT_DRYRUN; return;
    }
  } else dryCurrentSince = 0;

  // 5. Bom duoc lenh bat nhung khong co dong dien
  if (pumpOn) {
    if (currentMv < CURRENT_ON_MV) {
      if (noCurrentSince == 0) noCurrentSince = now;
      else if (now - noCurrentSince > NOCURRENT_MS) {
        raiseFault("NO_CURRENT"); state = ST_FAULT_DRYRUN; return;
      }
    } else noCurrentSince = 0;
  } else noCurrentSince = 0;

  // 6. Nghi ngo ro ri: bom tat ma van co dong chay
  if (!pumpOn && flowOk && flowLpm > LEAK_FLOW_LPM) {
    if (leakSince == 0) leakSince = now;
    else if (now - leakSince > LEAK_MS) {
      raiseFault("LEAK_SUSPECTED");   // canh bao, khong khoa bom
      leakSince = now;
    }
  } else leakSince = 0;

  // 7. Bom chay qua lau ma chua day
  if (pumpOn && pumpOnSince && now - pumpOnSince > MAX_FILL_MS) {
    raiseFault("FILL_TIMEOUT"); state = ST_FAULT_DRYRUN; return;
  }

  // 8. Tran cuoi cung theo thoi gian. Khong dieu kien, khong ngoai le.
  //    Luat 7 co the bi vo hieu neu pumpOnSince bi dat lai, luat nay thi khong.
  if (pumpOn && pumpOnSince && now - pumpOnSince > PUMP_HARD_LIMIT_MS) {
    raiseFault("HARD_LIMIT"); state = ST_OVERFLOW_LOCK; return;
  }

  // 9. Da bom qua nhieu nuoc trong MOT lan. Dem bang cam bien luu luong
  //    dau vao, hoan toan doc lap voi cam bien sieu am va voi phao.
  if (pumpOn && flowOk && (volumeL - fillStartVolumeL) > MAX_FILL_VOLUME_L) {
    raiseFault("VOLUME_LIMIT"); state = ST_OVERFLOW_LOCK; return;
  }

  // 10. Bom chay ma muc nuoc khong len. Hoac cam bien muc hong, hoac nuoc
  //     dang di dau mat. Ca hai deu la ly do phai dung.
  if (pumpOn && levelOk) {
    if (progressMarkCm < 0) { progressMarkCm = levelCm; progressMarkMs = now; }
    // Moc chi di XUONG theo day cua dai nhieu, khong bao gio di len theo mot
    // so doc vot cao. Ban cu dat moc bang so doc tuc thoi, nen mot dinh nhieu
    // nang moc len va muc that sau do khong con vuot noi moc + nguong.
    else if (levelCm < progressMarkCm) progressMarkCm = levelCm;
    else if (levelCm > progressMarkCm + NO_PROGRESS_CM) {
      progressMarkCm = levelCm; progressMarkMs = now;       // co tien do that
    } else if (now - progressMarkMs > NO_PROGRESS_MS) {
      raiseFault("NO_PROGRESS"); state = ST_FAULT_DRYRUN; return;
    }
  }
}

// ------------------------------------------------------------
//  MAY TRANG THAI
// ------------------------------------------------------------
// Su co thuoc nhom cam bien thi tu phuc hoi duoc; cac su co khac phai cho
// nguoi van hanh xoa bang tay.
static bool isSensorFault(const char* code) {
  return !strcmp(code, "SENSOR_TIMEOUT")
      || !strcmp(code, "SENSOR_CONFLICT")
      || !strcmp(code, "LEVEL_LOST");
}

void runStateMachine() {
  uint32_t now = millis();

  // BAT BIEN: co ma su co thi trang thai PHAI la mot trang thai su co.
  //
  // Ban cu de hai thu nay roi nhau. ST_MANUAL_ON bi rao chan va ST_FILLING
  // khi tat che do tu dong deu nhay thang ve ST_IDLE ma khong xoa faultCode.
  // Ket qua la thiet bi hien IDLE nhu binh thuong, trong khi pumpBlockReason
  // van tra ve "fault_active" va chan moi lenh bat bom. Nhin thi lanh, thuc
  // te la ket cung va khong co gi tren giao dien noi ra dieu do.
  if (faultCode[0] != '\0' &&
      (state == ST_BOOT || state == ST_IDLE ||
       state == ST_FILLING || state == ST_MANUAL_ON)) {
    state = isSensorFault(faultCode) ? ST_FAULT_SENSOR : ST_FAULT_DRYRUN;
  }

  switch (state) {
    case ST_BOOT:
      if (levelOk) state = ST_IDLE;
      break;

    case ST_IDLE:
      // Hai duong doc lap cung cho phep bat bom. Sieu am rot 30 phan tram
      // so lan do trong thung hep nay, nen neu chi dua vao no thi co luc bon
      // can that ma he thong van dung yen. Phao muc thap la duong thu hai.
      if (autoMode && ((levelOk && levelPct < LEVEL_LOW_PCT) || floatMin)) {
        if (startPump()) state = ST_FILLING;
      }
      break;

    case ST_FILLING:
      if (!autoMode) { stopPump(); state = ST_IDLE; break; }
      // Mat tin hieu muc: cho them FILL_LEVEL_GRACE_MS roi moi ngat.
      //
      // Khong ngat ngay, vi chinh viec bom chay lam mat nuoc gon va lam
      // levelOk chop tat — ngat ngay thi lan bom nao cung dung som.
      // Khong cho vo han, vi so phan tram luc do dong bang o lan doc cuoi.
      //
      // Trong suot khoang an han nay, waterTooClose van doc thang khoang
      // cach tho tung lan phat nen chan chong tran khong he bi tat.
      // Mat tin hieu muc thi KHONG ngat ngay nua. Mo hinh muc nuoc chay song
      // song se cam lai viec dieu khien, va bom van len duoc toi nguong thay
      // vi dung som o khoang 50 phan tram nhu truoc.
      //
      // Nhung mo hinh khong duoc thay cam bien lau dai: qua MODEL_MAX_BLIND_MS
      // ma van khong co mot so do that nao thi ngat va bao loi.
      if (!levelOk) {
        if (fillBlindSince == 0) fillBlindSince = now;
        else if (now - fillBlindSince > MODEL_MAX_BLIND_MS || levelModelCm < 0) {
          raiseFault("LEVEL_LOST"); state = ST_FAULT_SENSOR; break;
        }
      } else {
        fillBlindSince = 0;
      }
      if (controlPct() > LEVEL_HIGH_PCT && now - pumpOnSince >= MIN_ON_MS) {
        stopPump(); state = ST_IDLE;
      }
      break;

    case ST_MANUAL_ON:
      // Rao an toan van duoc kiem tra moi chu ky ngay ca o che do thu cong.
      // MIN_ON_MS khong ap dung o day: rao chan luon thang.
      if (autoMode || pumpBlockReason() != nullptr) {
        stopPump();
        state = autoMode ? ST_IDLE : ST_IDLE;
      }
      break;

    case ST_FAULT_SENSOR:
      stopPump();   // giu ngat moi chu ky, khong chi mot lan luc phat loi
      // Nhom tu phuc hoi: tin hieu hop le lien tuc du lau thi tu het
      if (levelOk && !(floatMax && levelPct < CONFLICT_LEVEL_PCT)
                  && !(floatMin && levelPct > CONFLICT_MIN_PCT)) {
        if (sensorGoodSince == 0) sensorGoodSince = now;
        else if (now - sensorGoodSince > SENSOR_RECOVER_MS) {
          faultCode[0] = '\0';
          digitalWrite(PIN_LED_FAULT, LOW);
          sensorGoodSince = 0;
          state = ST_IDLE;
        }
      } else sensorGoodSince = 0;
      break;

    case ST_FAULT_DRYRUN:
    case ST_OVERFLOW_LOCK:
      stopPump();   // giu trang thai cho toi khi nguoi van hanh xoa loi
      break;
  }
}

// ------------------------------------------------------------
//  Cong bo ban tin
// ------------------------------------------------------------
void publishPumpState() {
  StaticJsonDocument<128> doc;
  doc["dev"]   = DEVICE_ID;
  doc["pump"]  = pumpOn;
  doc["state"] = STATE_NAME[state];
  doc["ts"]    = nowTs();
  char buf[128]; size_t n = serializeJson(doc, buf);
  if (mqttCanSend()) mqtt.publish(topicPumpState, (uint8_t*)buf, n, true);
}

size_t buildTelemetry(char* buf, size_t cap, const Sample* s) {
  // 640 chu khong phai 512. Ban tin day du dai 449 byte va con them duoc
  // ma su co dai toi 15 ky tu, nen 512 chi con thua vai chuc byte. Them hai
  // truong flow_ok la tran, va ArduinoJson CAT CUT AM THAM: no van tra ve
  // mot chuoi, chi la chuoi JSON hong.
  StaticJsonDocument<1024> doc;
  doc["dev"] = DEVICE_ID;
  if (s) {
    doc["ts"]  = s->ts;
    doc["seq"] = s->seq;
    doc["level_pct"] = s->levelPct10 / 10.0f;
    doc["flow_lpm"]     = s->flowLpm100 / 100.0f;
    doc["flow_out_lpm"] = s->flowOutLpm100 / 100.0f;
    doc["volume_l"]  = s->volumeL100 / 100.0f;
    doc["pump"]      = (bool)(s->flags & 0x01);
    doc["level_ok"]  = (bool)(s->flags & 0x02);
    doc["float_max"] = (bool)(s->flags & 0x04);
    doc["state"]     = STATE_NAME[s->state];
    doc["replay"]    = true;
  } else {
    doc["ts"]    = nowTs();
    doc["ts_ms"] = nowTsMs();
    doc["seq"]   = seqNo;
    doc["level_pct"]      = levelPct;
    doc["level_cm"]       = levelCm;
    doc["level_ok"]       = levelOk;
    doc["flow_lpm"]           = flowLpm;
    doc["volume_l"]           = volumeL;
    doc["volume_today_l"]     = volumeTodayL;
    doc["flow_out_lpm"]       = flowOutLpm;
    doc["flow_ok"]            = flowOk;
    doc["flow_out_ok"]        = flowOutOk;
    doc["level_trust_always"] = (bool)LEVEL_TRUST_ALWAYS;
    doc["level_rate_cms"]     = levelRateCmS;
    doc["level_model_cm"]     = levelModelCm;
    doc["blind_ms"]           = blindSinceMs ? (millis() - blindSinceMs) : 0;
    // Dem cong don ly do loai so doc, de biet cong nao dang chan.
    doc["lv_try"]  = levelTries;  doc["lv_ok"]   = levelGood;
    doc["rj_echo"] = rej[RJ_ECHO];   doc["rj_gate"]   = rej[RJ_GATE];
    doc["rj_few"]  = rej[RJ_FEW];    doc["rj_spread"] = rej[RJ_SPREAD];
    doc["rj_rng"]  = rej[RJ_RANGE];  doc["rj_rate"]   = rej[RJ_RATE];
    doc["rj_fall"] = rej[RJ_FALL];   doc["rj_join"]   = rej[RJ_REJOIN];
    doc["flow_src"]           = FLOW_FROM_LEVEL ? "level" : "sensor";
    doc["volume_out_l"]       = volumeOutL;
    doc["volume_out_today_l"] = volumeOutTodayL;
    doc["pump"]      = pumpOn;
    doc["state"]     = STATE_NAME[state];
    doc["mode"]      = autoMode ? "AUTO" : "MANUAL";
    doc["current_mv"]= currentMv;
    // Doi ra mA de hien thi. mV la dien ap tho cua cam bien, khong phai dong.
    doc["pump_health"] = PUMP_HEALTH_NAME[pumpHealth()];
    doc["current_ma"]= (currentMv < CURRENT_NOISE_MV) ? 0.0f
                                                       : currentMv * CURRENT_MA_PER_MV;
    doc["float_max"] = floatMax;
    doc["float_min"] = floatMin;
    doc["fault"]     = faultCode;
    doc["rssi"]      = WiFi.RSSI();
    // Chu ky dieu khien dai nhat ke tu ban tin song truoc. Binh thuong ~200.
    // Ban tin dau tien sau khi mat mang cho biet vong dieu khien co bi mang
    // lam treo hay khong trong suot thoi gian mat ket noi.
    doc["ctl_gap_ms"] = ctlGapMaxMs;
    doc["sens_in_lpm"]  = sensorInLpm;   doc["sens_out_lpm"] = sensorOutLpm;
    doc["sens_in_l"]    = sensorInL;     doc["sens_out_l"]   = sensorOutL;
    doc["ring_drop"]  = ringDropped;
  }
  if (doc.overflowed()) {
    Serial.println("[LOI] ban tin telemetry TRAN BO DEM — JSON se hong, "
                   "hay tang StaticJsonDocument va char buf[]");
  }
  size_t n = serializeJson(doc, buf, cap);
  if (n >= cap - 1) {
    Serial.printf("[LOI] ban tin telemetry bi CAT CUT o %u byte\n", (unsigned)n);
  }
  return n;
}

void flushRing();
void publishTelemetry() {
  seqNo++;
  // Da tung dat 448 va bi cat cut. Hau qua rat kho tim: thiet bi van gui,
  // broker van chuyen, backend van song — nhung json.loads hong nen moi ban
  // tin bi vut lang le, va dashboard dung yen o so cu hang phut.
  char buf[1024];
  size_t n = buildTelemetry(buf, sizeof(buf), nullptr);

  if (mqttCanSend()) {
    if (ringCount) flushRing();      // con mau dem tu lan mat mang truoc
    ctlGapMaxMs = 0;
    if (!mqtt.publish(topicTelemetry, (uint8_t*)buf, n, false)) {
      Serial.printf("[MQTT] GUI THAT BAI, ban tin %u byte — bo dem qua nho?\n",
                    (unsigned)n);
    }
  } else {
    Sample s;
    s.ts = nowTs(); s.seq = seqNo;
    s.levelPct10 = (int16_t)(levelPct * 10);
    s.flowLpm100    = (int16_t)(flowLpm * 100);
    s.flowOutLpm100 = (int16_t)(flowOutLpm * 100);
    s.volumeL100 = (uint32_t)(volumeL * 100);
    s.flags = (pumpOn ? 1 : 0) | (levelOk ? 2 : 0) | (floatMax ? 4 : 0);
    s.state = (uint8_t)state;
    ringPush(s);
  }
}

void flushRing() {
  if (ringCount == 0) return;
  Serial.printf("[MQTT] phat lai %u ban tin da dem\n", ringCount);
  uint16_t idx = (ringHead + OFFLINE_BUFFER_SIZE - ringCount) % OFFLINE_BUFFER_SIZE;
  char buf[1024];
  while (ringCount > 0) {
    // Socket day thi dung lai, giu phan con lai cho lan sau, khong chan
    // vong dieu khien (xem netWritable).
    if (!netWritable()) { Serial.println("[MQTT] socket day, phat lai tiep sau"); return; }
    size_t n = buildTelemetry(buf, sizeof(buf), &ring[idx]);
    mqtt.publish(topicTelemetry, (uint8_t*)buf, n, false);
    idx = (idx + 1) % OFFLINE_BUFFER_SIZE;
    ringCount--;
    mqtt.loop();
    delay(5);
  }
}

void sendAck(const char* cmdId, const char* status, const char* reason) {
  StaticJsonDocument<320> doc;
  doc["dev"]    = DEVICE_ID;
  doc["cmd_id"] = cmdId;
  doc["status"] = status;
  if (reason) doc["reason"] = reason;
  doc["state"]  = STATE_NAME[state];
  doc["pump"]   = pumpOn;
  doc["mode"]   = autoMode ? "AUTO" : "MANUAL";
  doc["ts"]     = nowTs();
  char buf[320]; size_t n = serializeJson(doc, buf);
  if (n >= sizeof(buf) - 1)
    Serial.printf("[LOI] xac nhan lenh bi cat o %u byte\n", (unsigned)n);
  if (mqttCanSend()) mqtt.publish(topicAck, (uint8_t*)buf, n, false);
}

// ------------------------------------------------------------
//  Xu ly lenh di xuong
// ------------------------------------------------------------
void onMessage(char* topic, byte* payload, unsigned int len) {
  // CHEP ban tin ra bo dem rieng TRUOC khi phan tich.
  //
  // payload tro vao bo dem noi bo cua PubSubClient, va thu vien dung CHUNG
  // mot bo dem do cho ca nhan lan gui. deserializeJson voi con tro khong-const
  // chay che do khong sao chep: cmdId, action chi la con tro vao bo dem ay.
  // Lenh "pump" goi startPump() -> publishPumpState() -> mqtt.publish(), ghi
  // de len bo dem, va cmdId bien thanh rac ngay truoc khi gui xac nhan.
  //
  // Do that ngay 23/09: xac nhan lenh "mode" dai 118 byte va ve dung, con
  // xac nhan lenh "pump" dai DUNG 256 byte — bang kich thuoc bo dem gui — vi
  // cmd_id da thanh rac. JSON bi cat, backend vut di, bang lenh treo mai o
  // "pending" trong khi bom da chay that.
  char in[256];
  if (len >= sizeof(in)) return;
  memcpy(in, payload, len);
  in[len] = '\0';

  StaticJsonDocument<256> doc;
  if (deserializeJson(doc, in)) return;

  // Chep luon hai chuoi can dung ve sau, khong phu thuoc vao song chet cua doc.
  char cmdId[24], action[20];
  strlcpy(cmdId,  doc["cmd_id"] | "unknown", sizeof(cmdId));
  strlcpy(action, doc["action"] | "",        sizeof(action));

  if (!strcmp(action, "mode")) {
    bool wantAuto = doc["value"] | true;
    autoMode = wantAuto;
    if (autoMode && state == ST_MANUAL_ON) { stopPump(); state = ST_IDLE; }
    sendAck(cmdId, "accepted", nullptr);

  } else if (!strcmp(action, "pump")) {
    bool want = doc["value"] | false;
    if (autoMode) { sendAck(cmdId, "rejected", "auto_mode_active"); return; }
    if (want) {
      const char* why = pumpBlockReason();
      if (why) { sendAck(cmdId, "rejected", why); return; }
      startPump(); state = ST_MANUAL_ON;
      sendAck(cmdId, "accepted", nullptr);
    } else {
      stopPump(); state = ST_IDLE;
      sendAck(cmdId, "accepted", nullptr);
    }

  } else if (!strcmp(action, "clear_fault")) {
    if (faultCode[0] == '\0') { sendAck(cmdId, "rejected", "no_active_fault"); return; }
    // Cung ba duong kiem tra nhu luat chong tran, de khong xoa duoc loi
    // trong khi dieu kien gay ra no van con.
    if (floatMax || waterTooClose() || (levelOk && levelPct >= LEVEL_OVERFLOW_PCT)) {
      sendAck(cmdId, "rejected", "condition_still_present"); return;
    }
    faultCode[0] = '\0';
    digitalWrite(PIN_LED_FAULT, LOW);
    state = ST_IDLE;
    sendAck(cmdId, "accepted", nullptr);

  } else if (!strcmp(action, "reset_volume")) {
    // Xoa ca bo dem trong ngay LAN bo dem tong. Ban cu chi xoa bo dem ngay,
    // nen 5 858 lit rac do nhieu tich luy lai nam mai trong NVS va khong co
    // cach nao xoa duoc tu giao dien.
    volumeTodayL = volumeOutTodayL = 0;
    volumeL      = volumeOutL      = 0;
    prefs.putFloat("vol", 0.0f);
    prefs.putFloat("volday", 0.0f);
    prefs.putFloat("volout", 0.0f);
    prefs.putFloat("voloutday", 0.0f);
    sendAck(cmdId, "accepted", nullptr);

  } else {
    sendAck(cmdId, "rejected", "unknown_action");
  }
}

// ------------------------------------------------------------
//  Ket noi khong chan
// ------------------------------------------------------------
static const char* resetReasonText() {
  switch (esp_reset_reason()) {
    case ESP_RST_POWERON:  return "power_on";
    case ESP_RST_SW:       return "software";
    case ESP_RST_PANIC:    return "panic";
    case ESP_RST_INT_WDT:
    case ESP_RST_TASK_WDT:
    case ESP_RST_WDT:      return "watchdog";
    case ESP_RST_BROWNOUT: return "brownout";
    case ESP_RST_EXT:      return "reset_pin";
    default:               return "other";
  }
}

// Mat Wi-Fi thi xoa dia chi broker da phan giai: mang moi thi IP moi.
static bool  wifiLost = false;
static void  wifiAnnouncedReset(){ wifiLost = true; }

// Ma trang thai cua WiFi.status() doi ra chu, de doc man hinh biet hong o dau
static const char* wifiStatusText(int st) {
  switch (st) {
    case WL_IDLE_STATUS:     return "dang khoi dong";
    case WL_NO_SSID_AVAIL:   return "KHONG THAY MANG nay";
    case WL_CONNECT_FAILED:  return "SAI MAT KHAU hoac bi tu choi";
    case WL_CONNECTION_LOST: return "MAT KET NOI";
    case WL_DISCONNECTED:    return "chua noi";
    default:                 return "trang thai la";
  }
}

void mqttTryConnect() {
  if (millis() < nextReconnectMs) return;
  if (WiFi.status() != WL_CONNECTED) {
    // Ban cu im lang hoan toan o nhanh nay. Hau qua: mat Wi-Fi trong nhu
    // thiet bi treo — man hinh chi co mot dong [BOOT] san sang roi khong gi
    // nua, va khong co cach nao biet la hong o Wi-Fi hay o MQTT.
    static uint32_t lastWifiMsgMs = 0;
    if (millis() - lastWifiMsgMs > 5000) {
      lastWifiMsgMs = millis();
        Serial.printf("[WIFI] chua noi duoc — %s (ma %d)\n",
                    wifiStatusText(WiFi.status()), WiFi.status());
    }
    // Thu lan luot cac mang da khai bao. Moi lan vao day thi doi sang mang
    // ke tiep, nen neu mot mang bien mat thiet bi tu chuyen sang mang khac
    // thay vi nam cho mai mot cai khong con ton tai.
    wifiAnnouncedReset();
    // Cho moi lan thu Wi-Fi it nhat 10 s. Ban cu goi lai WiFi.begin() moi
    // 1 s: bat tay WPA2 + DHCP cua diem phat dien thoai can 2-5 s, nen lan
    // nao cung bi cat ngang va thiet bi KHONG BAO GIO vao duoc mang
    // (do 05/10: "chua noi (ma 6)" lien tuc trong khi mat khau dung).
    static uint32_t lastBeginMs = 0;
    if (lastBeginMs != 0 && millis() - lastBeginMs < 10000) {
      nextReconnectMs = millis() + RECONNECT_BASE_MS;
      return;
    }
    lastBeginMs = millis();
    static uint8_t netIdx = 0;
    const char* ssids[] = { WIFI_SSID, WIFI_SSID_2, WIFI_SSID_3 };
    const char* pwds[]  = { WIFI_PASSWORD, WIFI_PASSWORD_2, WIFI_PASSWORD_3 };
    do { netIdx = (netIdx + 1) % 3; } while (ssids[netIdx][0] == '\0' && netIdx != 0);
    WiFi.begin(ssids[netIdx], pwds[netIdx]);
    nextReconnectMs = millis() + RECONNECT_BASE_MS;
    return;
  }
  static bool wifiAnnounced = false;
  if (!wifiAnnounced) {
    wifiAnnounced = true;
    Serial.printf("[WIFI] da noi '%s' · IP %s · RSSI %d dBm\n",
                  WiFi.SSID().c_str(), WiFi.localIP().toString().c_str(), WiFi.RSSI());
  }

  // Hoi mang xem may chay broker dang o IP nao. Chi hoi mot lan cho moi lan
  // noi lai Wi-Fi; khong tra loi thi dung dia chi du phong trong config.
  // Neu lan hoi truoc khong thay (vi du laptop vao diem phat sau ESP32) thi
  // dia chi du phong gan nhu chac chan sai: hoi lai o moi lan thu ket noi
  // that bai, voi han ngan 500 ms de vong dieu khien khong dung lau.
  static String brokerAddr;
  static bool brokerFallback = false;
  static bool mdnsStarted = false;      // MDNS.begin mot lan cho moi lan noi Wi-Fi
  static bool firstQuery = true;
  if (wifiLost) { wifiLost = false; brokerAddr = ""; wifiAnnounced = false;
                  mdnsStarted = false; firstQuery = true; }
  if (brokerAddr.isEmpty()) {
    brokerAddr = MQTT_HOST;
    brokerFallback = false;
    if (MQTT_HOST_NAME[0] != '\0') {
      if (!mdnsStarted) { MDNS.begin("watertank"); mdnsStarted = true; }
      IPAddress ip = MDNS.queryHost(MQTT_HOST_NAME, firstQuery ? 2000 : 500);
      firstQuery = false;
      if (ip != IPAddress((uint32_t)0)) {
        brokerAddr = ip.toString();
        Serial.printf("[mDNS] %s.local -> %s\n", MQTT_HOST_NAME, brokerAddr.c_str());
      } else {
        brokerFallback = true;
        Serial.printf("[mDNS] khong thay %s.local, dung dia chi du phong %s\n",
                      MQTT_HOST_NAME, MQTT_HOST);
      }
    }
    mqtt.setServer(brokerAddr.c_str(), MQTT_PORT);
  }
  Serial.printf("[MQTT] dang ket noi %s:%d... ", brokerAddr.c_str(), MQTT_PORT);
  // Mo TCP truoc voi han 500 ms. Mac dinh WiFiClient cho toi 3 giay, va
  // trong 3 giay do vong dieu khien DUNG HAN: khong doc muc nuoc, khong xet
  // chong tran. Khi Wi-Fi con ma broker mat (may chu tat, tuong lua chan)
  // thi lan thu nao cung ton du 3 giay. PubSubClient thay socket da mo se
  // dung luon, khong tu mo lai.
  bool ok = net.connect(brokerAddr.c_str(), MQTT_PORT, 500);
  if (ok) ok = mqtt.connect(DEVICE_ID, MQTT_USER, MQTT_PASS,
                         topicStatus, 1, true, "{\"online\":false}");
  if (ok) {
    Serial.println("thanh cong");
    reconnectFails = 0;
    // Kem ly do khoi dong lan cuoi: phan biet nap lai phan sun, mat nguon
    // va sut ap (brownout) ma khong can cam day serial.
    char st[96];
    snprintf(st, sizeof(st), "{\"online\":true,\"reset\":\"%s\",\"up_s\":%lu}",
             resetReasonText(), (unsigned long)(millis() / 1000));
    mqtt.publish(topicStatus, st, true);
    mqtt.subscribe(topicCmd, 1);
    publishPumpState();
    flushRing();
  } else {
    reconnectFails = min<uint8_t>(reconnectFails + 1, 5);
    uint32_t wait = RECONNECT_BASE_MS * (1UL << reconnectFails);
    if (wait > RECONNECT_MAX_MS) wait = RECONNECT_MAX_MS;
    nextReconnectMs = millis() + wait;
    net.stop();
    if (brokerFallback) brokerAddr = "";   // lan sau hoi mDNS lai
    Serial.printf("that bai rc=%d, thu lai sau %lu ms\n", mqtt.state(), wait);
  }
}

// ------------------------------------------------------------
void setup() {
  // Dua ro le ve NGAT NGAY DONG DAU TIEN, truoc ca Serial.begin.
  // Tu luc cap dien toi luc dong nay chay, chan GPIO 10 van tha noi, va
  // mo dun ro le kich muc thap se hieu muc tha noi la LENH BAT. Moi mili
  // giay tri hoan o day la mot mili giay bom chay ngoai y muon.
  // Phan con lai, khoang 300 ms cua bootloader ROM, phan mem khong the
  // rut ngan duoc: chi dien tro keo len NGOAI 10 kOhm tu chan IN len 3,3 V
  // moi bit han duoc, xem docs/wiring.md.
  pinMode(PIN_RELAY, OUTPUT);
  setRelay(false);

  Serial.begin(115200);
  delay(200);

  pinMode(PIN_TRIG, OUTPUT);
  pinMode(PIN_ECHO, INPUT);
#if FLOW_PIN_PULLUP
  pinMode(PIN_FLOW, INPUT_PULLUP);   // noi thang, keo len noi bo len 3,3 V
#else
  pinMode(PIN_FLOW, INPUT);          // qua chia ap, KHONG keo len noi bo
#endif
  pinMode(PIN_FLOAT_MAX, INPUT_PULLUP);
  pinMode(PIN_FLOAT_MIN, INPUT_PULLUP);
  pinMode(PIN_LED_OK, OUTPUT);
  pinMode(PIN_LED_FAULT, OUTPUT);
  pinMode(PIN_BTN_RESET, INPUT_PULLUP);
  analogReadResolution(12);

  attachInterrupt(digitalPinToInterrupt(PIN_FLOW), onFlowPulse, FALLING);
#if FLOW_OUT_PIN_PULLUP
  pinMode(PIN_FLOW_OUT, INPUT_PULLUP);
#else
  pinMode(PIN_FLOW_OUT, INPUT);
#endif
  attachInterrupt(digitalPinToInterrupt(PIN_FLOW_OUT), onFlowOutPulse, FALLING);

  snprintf(topicTelemetry, sizeof(topicTelemetry), "wt/%s/%s/telemetry",  SITE_ID, DEVICE_ID);
  snprintf(topicPumpState, sizeof(topicPumpState), "wt/%s/%s/state/pump", SITE_ID, DEVICE_ID);
  snprintf(topicFault,     sizeof(topicFault),     "wt/%s/%s/event/fault",SITE_ID, DEVICE_ID);
  snprintf(topicStatus,    sizeof(topicStatus),    "wt/%s/%s/status",     SITE_ID, DEVICE_ID);
  snprintf(topicCmd,       sizeof(topicCmd),       "wt/%s/%s/cmd",        SITE_ID, DEVICE_ID);
  snprintf(topicAck,       sizeof(topicAck),       "wt/%s/%s/cmd/ack",    SITE_ID, DEVICE_ID);

  // Do gia tri lech khong cua cam bien dong khi bom chac chan dang tat.
  // Cho nguon va cam bien on dinh truoc, neu khong se lay nham gia tri
  // dang troi ngay sau khi cap dien lam moc.
  delay(CURRENT_SETTLE_MS);
  uint32_t acc = 0;
  for (int i = 0; i < 200; i++) acc += analogRead(PIN_CURRENT);
  currentOffsetMv = (acc / 200.0f) * 3300.0f / 4095.0f;

  prefs.begin("wtank", false);
  volumeL         = prefs.getFloat("vol", 0);
  volumeTodayL    = prefs.getFloat("volday", 0);
  volumeOutL      = prefs.getFloat("volout", 0);
  volumeOutTodayL = prefs.getFloat("voloutday", 0);

  WiFi.mode(WIFI_STA);
  WiFi.begin(WIFI_SSID, WIFI_PASSWORD);
  // Tat che do tiet kiem dien cua Wi-Fi. Mac dinh ESP32 chi bat radio theo
  // nhip DTIM cua router, nen goi tin den phai nam cho toi 100-300 ms moi
  // duoc xu ly. Tat di thi do tre lenh giam manh, doi lai ton them dong.
  WiFi.setSleep(false);
  configTime(7 * 3600, 0, "pool.ntp.org", "time.nist.gov");

  mqtt.setServer(MQTT_HOST, MQTT_PORT);
  mqtt.setCallback(onMessage);
  mqtt.setKeepAlive(MQTT_KEEPALIVE_S);
  // 768 chu khong phai 512. Ban tin telemetry dung bo dem 640 byte, va
  // PubSubClient::publish tra ve false MA KHONG BAO GI neu goi tin dai hon
  // bo dem cua no. Hai con so nay phai di cung nhau, neu khong thiet bi se
  // im lang dung luc no tuong minh dang gui.
  mqtt.setBufferSize(1200);
  // Cho CONNACK toi da 2 giay thay vi 15 (mac dinh = keepalive).
  mqtt.setSocketTimeout(2);

  lastValidLevelMs = millis();
  Serial.println("[BOOT] san sang");
}

void loop() {
  // Ket noi lai khong chan: vong dieu khien khong bao gio bi treo vi mang
  if (!mqtt.connected()) mqttTryConnect();
  else {
    // Socket khong ghi duoc qua 3 s: broker da mat ma TCP chua biet.
    // Dong han de chuyen sang che do dem va noi lai, thay vi doi keep alive
    // 15 s (trong luc do moi mau gui vao socket chet deu mat).
    if (!netWritable()) {
      if (unwritableSince == 0) unwritableSince = millis();
      if (millis() - unwritableSince > 3000) {
        Serial.println("[MQTT] socket khong ghi duoc 3 s, dong ket noi");
        net.stop(); unwritableSince = 0;
      }
    } else {
      unwritableSince = 0;
      mqtt.loop();
    }
  }

  uint32_t now = millis();

  if (now - lastControlMs >= CONTROL_PERIOD_MS) {
    uint32_t dt = now - lastControlMs;
    lastControlMs = now;
    if (dt > ctlGapMaxMs) ctlGapMaxMs = dt;

    readLevel();
    readFlow(dt);
    readCurrent();
    readFloats();

    { PumpHealth h = pumpHealth(); pumpNoFlow = (h == PH_NO_FLOW || h == PH_DRY); }
    updateLevelModel(dt);
    checkFaults();
    runStateMachine();

    digitalWrite(PIN_LED_OK, mqtt.connected() ? HIGH : LOW);

    // Nut xoa loi tren thiet bi
    if (digitalRead(PIN_BTN_RESET) == LOW && faultCode[0] != '\0') {
      if (!floatMax && !(levelOk && levelPct >= LEVEL_OVERFLOW_PCT)) {
        faultCode[0] = '\0';
        digitalWrite(PIN_LED_FAULT, LOW);
        state = ST_IDLE;
      }
    }
  }

  if (now - lastTelemetryMs >= TELEMETRY_PERIOD_MS) {
    lastTelemetryMs = now;
    publishTelemetry();
  }

  if (now - lastNvsMs >= NVS_SAVE_PERIOD_MS) {
    lastNvsMs = now;
    prefs.putFloat("vol", volumeL);
    prefs.putFloat("volday", volumeTodayL);
    prefs.putFloat("volout", volumeOutL);
    prefs.putFloat("voloutday", volumeOutTodayL);
  }
}
