NhanHuynh2006/smart-water-tank/water-tank-arduino/water_tank/water_tank.ino

// ============================================================
//  Arduino IDE bat buoc moi sketch phai co mot file .ino
//  trung ten voi thu muc chua no. File nay CO Y de trong.
//
//  Toan bo phan sun nam trong water_tank_firmware.cpp, ke ca
//  setup() va loop(). Ly do khong doi thang main.cpp thanh
//  .ino: Arduino IDE tu chen prototype ngay sau dong #include
//  cuoi cung, tuc la TRUOC cho dinh nghia "struct Sample",
//  nen ham ringPush(const Sample&) se bao loi chua khai bao.
//  De code trong file .cpp thi Arduino bien dich nhu C++ thuan
//  va khong dung toi trinh chen prototype do.
//
//  Dung viet code vao file nay.
// ============================================================
