NhanHuynh2006/smart-water-tank/IOT/include/config.example.h

// ============================================================
//  config.h  -  DAY LA FILE DUY NHAT BAN CAN SUA
//  Sua wifi, dia chi broker va cac nguong o day roi nap lai.
// ============================================================
#pragma once

// ---------- Wi-Fi ----------
#define WIFI_SSID       "TEN_WIFI_CUA_BAN"
#define WIFI_PASSWORD   "MAT_KHAU_WIFI"

// Mang du phong. Thiet bi thu lan luot tung mang cho toi khi vao duoc mot cai.
// De trong thi bo qua. ESP32 CHI bat duoc bang 2,4 GHz — mang 5 GHz no khong
// nhin thay, du dien thoai va may tinh deu thay binh thuong.
#define WIFI_SSID_2     ""
#define WIFI_PASSWORD_2 ""
#define WIFI_SSID_3     ""
#define WIFI_PASSWORD_3 ""

// ---------- MQTT broker ----------
// ---------- Tim broker ----------
// Dat ten may chay mosquitto vao day thi thiet bi tu hoi mang xem may do
// dang o IP nao, bang mDNS. Doi Wi-Fi hay doi IP bao nhieu lan cung khong
// phai sua file nay nua.
//
// Vi sao can: trong hai ngay thu nghiem, IP may tinh doi hai lan
// (x.x.x.x -> x.x.x.x) va ca hai lan thiet bi deu im lang cho
// toi khi sua tay MQTT_HOST. Dat tay mot dia chi IP la tu buoc minh phai sua
// no moi lan doi mang.
//
// Ten lay bang lenh: hostname
// Kiem tra phan giai duoc chua: getent hosts $(hostname).local
// De trong "" thi bo qua mDNS va dung thang MQTT_HOST ben duoi.
#define MQTT_HOST_NAME  "ten-may-cua-ban"

// Dia chi du phong, dung khi mDNS khong tra loi.
#define MQTT_HOST       "192.168.1.10"   // IP may chay mosquitto
#define MQTT_PORT       1883
#define MQTT_USER       "device1"
#define MQTT_PASS       "device_pass"

// ---------- Dinh danh thiet bi ----------
#define SITE_ID         "lab1"
#define DEVICE_ID       "esp32-01"

// ---------- Chan GPIO ----------
#define PIN_TRIG        5     // ultrasonic trigger
#define PIN_ECHO        18    // ultrasonic echo (qua chia ap 10k/20k)
// DA DAO NGAY 21/09. Bang chung: che do thu cong, bom TAT, ong xa LUON MO.
//    GPIO 4  doc 0,26-0,36 L/phut   <- co dong chay
//    GPIO 19 doc 0,00                <- khong co dong chay
// Bom dang tat thi duong VAO bat buoc phai bang 0. No khong bang 0, con
// duong duoc goi la RA thi lai bang 0 dung luc nuoc dang xa that.
// Vay GPIO 4 la cam bien DAU RA, va GPIO 19 la cam bien DAU VAO.
#define PIN_FLOW        4     // xung cam bien luu luong DAU VAO (bom -> bon); doi cho voi DAU RA ngay 05/10
#define PIN_FLOW_OUT   19     // xung cam bien luu luong DAU RA  (bon -> tieu thu)
#define PIN_RELAY       10    // relay dieu khien bom. GPIO 10 = chan SD3 cua flash:
                              // CHI dung duoc khi flash o che do DIO (platformio.ini)
#define PIN_CURRENT     34    // ACS712 (qua chia ap 10k/10k), chan chi vao
#define PIN_FLOAT_MAX   27    // phao muc cao, INPUT_PULLUP
#define PIN_FLOAT_MIN   14    // phao MUC THAP tren bon chua, INPUT_PULLUP
#define PIN_LED_OK      2
#define PIN_LED_FAULT   25
#define PIN_BTN_RESET   33    // nut xoa loi, INPUT_PULLUP

// DO THAT NGAY 21/09: dat 1, firmware dua chan len MUC CAO de NGAT bom,
// nhung bom VAN CHAY. Muc nuoc dang tu 0,2 cm len 11,2 cm trong khi web bao
// "bom tat". Vay module nay KICH MUC CAO, phai dat 0.
//
// Day la ly do that su cua viec bom khong chiu dung: khong phai phan mem
// quen ngat, ma la moi lan phan mem ra lenh NGAT thi phan cung lai BAT.
#define RELAY_ACTIVE_LOW  0

// ---------- Cuc tinh hai phao ----------
// Ca hai chan deu bat keo len noi bo, nen chan HO doc ra muc CAO.
// Dat 1 = tiep diem DONG (chan bi keo xuong dat) co nghia la DA KICH HOAT.
// Dat 0 = tiep diem HO (chan o muc cao) co nghia la DA KICH HOAT.
//
// DO THAT TREN MACH NGAY 21/09: ca hai chan doc ra MUC THAP khi bon CHUA day.
// Vay muc thap la trang thai NGHI, va phao muc cao phai dat 0.
// Cach nay con an toan hon: dut day thi chan len muc cao, thanh "bon day",
// va bom bi chan — hong theo huong an toan.
//
// KIEM CHUNG LAI bang: pio run -e test_floats -t upload -t monitor
// Nhan tay phao muc cao len, dong chu phai doi thanh "DA KICH HOAT".
// CA HAI PHAO DEU NAM TREN BON CHUA. Bon nguon khong co cam bien nao ca,
// nen phan mem KHONG CACH NAO biet bon nguon con nuoc hay khong, va khong
// duoc phep vin vao do de chan bom. Chay kho duoc bat bang ba luat khac:
// DRY_RUN (co lenh bom ma khong co dong chay), NO_CURRENT (khong co dong
// dien) va NO_PROGRESS (bom chay ma muc khong len).
//
//   phao MUC CAO  (GPIO 27): nuoc cham toi vach cao  -> NGAT bom
//   phao MUC THAP (GPIO 14): nuoc tut duoi vach thap -> CHO PHEP bat bom
//
// DO THAT NGAY 21/09, luc bon gan can:
//   GPIO 27 doc MUC THAP  -> phao muc cao chua cham -> dat ACTIVE_LOW = 0
//   GPIO 14 doc MUC CAO   -> phao muc thap da cham  -> dat ACTIVE_LOW = 0
// Hai phao cung kieu, cung dau day, nen cung mot gia tri la hop ly.
//
// KIEM CHUNG LAI: pio run -e test_floats -t upload -t monitor
#define FLOAT_MAX_ACTIVE_LOW  0
#define FLOAT_MIN_ACTIVE_LOW  0

// ---------- Hinh hoc bon ----------
// DO THAT NGAY 21/09: mat cam bien cach day thung 15,5 cm, day 10 x 10 cm.
//
// Muc nuoc cao nhat KHONG duoc lay bang 15,5. HC-SR04 co vung mu 2 cm va so
// doc duoi 4 cm da khong con dang tin. Chua 5,5 cm cho vung mu va sai so,
// con lai 10 cm la muc lam viec.
//
// The tich lam viec = 100 cm2 x 10 cm = 1 000 cm3 = 1 LIT.
// Bon 1 lit, khong phai 10 lit. Moi nguong thoi gian va the tich ben duoi
// deu duoc tinh lai theo con so nay.
// SUA NGAY 23/09 tu 15,5 len 17,5 cm.
//
// Nguoi dung do bang thuoc: nuoc that 9 cm, nhung giao dien bao 7 cm.
// Kiem chung o CA HAI dau thang do thay chi co mot nguyen nhan khop:
//    nuoc 9 cm  ->  khoang cach do duoc 17,5 - 9 = 8,5 cm
//                   cong thuc cu: 15,5 - 8,5 = 7,0 cm   <- dung so bao sai
//    bon can    ->  khoang cach 17,5 cm
//                   cong thuc cu: 15,5 - 17,5 = -2 -> ep ve 0  <- van dung
//
// Mot so bu cong thang (LEVEL_CAL_B) chi khop o diem 9 cm roi lam lech diem 0.
// Sua dung con so hinh hoc thi khop ca hai, VA cac cong loc hinh hoc — dMin,
// dMax, waterTooClose — cung tu dong dich theo. Do la ly do khong dung bias.
#define TANK_SENSOR_TO_BOTTOM_CM   15.88f   // do bang thuoc 05/10: 6 1/4 inch tu day len mat cam bien
// SUA NGAY 23/09 tu 10 len 14 cm — dung chieu cao THAT cua thung.
//
// Vi sao lay ca 14 chu khong tru bot: de 100 phan tram tren giao dien la 100
// phan tram cua cai thung nguoi dung nhin thay. Truoc day toi dat 10 cm, nen
// web bao 70 phan tram trong khi mat chi thay 7/14 = 50 phan tram chieu cao
// thung — hai ben noi ve hai thang do khac nhau va khong cach nao khop.
//
// An toan khong mat gi, vi cac nguong deu la phan tram cua con so nay:
//    dung bom   70%  = 9,8 cm   con cach mieng thung 4,2 cm
//    khoa tran  85%  = 11,9 cm  con cach mieng thung 2,1 cm
//    chan cung        = 13,0 cm con cach mieng thung 1,0 cm
// Khoang cach cam bien o muc khoa tran la 17,5 - 11,9 = 5,6 cm, van nam trong
// dai do duoc cua HC-SR04. Khong bao gio chay toi vung mu 2 cm.
#define TANK_MAX_LEVEL_CM          12.4f    // = 15,88 - 3,5 cm chua trong duoi cam bien
#define TANK_AREA_CM2             100.0f

// ---------- Hieu chuan (lay tu thi nghiem E1 va E2) ----------
#define LEVEL_CAL_A     1.0f
#define LEVEL_CAL_B     0.0f
// He so K = so xung moi giay tren moi lit/phut. KHAC NHAU THEO LOAI CAM BIEN:
//    YF-S201  (ren 1/2", 1-30 L/phut) : 7.5
//    YF-S401  (ren 1/4", 0.3-6 L/phut): 98.0
//    YF-B10   (ren 1/2", 1-25 L/phut) : 6.6
// Dat sai he so nay thi so doc lech dung bang ti so hai he so.
// Gia tri duoi day PHAI duoc kiem chung lai bang thi nghiem E2.
#define FLOW_K_FACTOR       85.5f   // 05/10: hieu chuan theo thuoc (98 dem thieu 14,6 %)   // cam bien DAU VAO
#define FLOW_OUT_K_FACTOR   98.0f   // cam bien DAU RA, doi neu hai con khac loai

// Chan xung cam bien luu luong noi the nao.
//    1 = noi THANG vao GPIO, dung dien tro keo len NOI BO cua ESP32 len 3,3 V.
//        Dung cho cam biến hall ngo ra cuc thu ho, KHONG co chia ap.
//    0 = qua CHIA AP 10k/20k tu 5 V, chan de o che do INPUT thuan.
//        Dung khi mo dun da co san dien tro keo len VCC 5 V.
//
// KHONG BAO GIO dung dong thoi keo len noi bo VA chia ap: dien tro keo len
// cua ESP32 khoang 45 kOhm, mac song song voi 20 kOhm xuong dat cho dien ap
// nghi 3,3 x 20/(45+20) = 1,02 V. Nguong vao cua ESP32 la 0,825 V va 2,475 V,
// nen 1,02 V roi vao VUNG KHONG XAC DINH va chan se dao dong theo nhieu,
// sinh ra hang nghin xung gia moi giay.
#define FLOW_PIN_PULLUP       1   // cho chan PIN_FLOW
#define FLOW_OUT_PIN_PULLUP   1   // cho chan PIN_FLOW_OUT

// Khoang cach toi thieu giua hai xung duoc dem, tinh bang micro giay.
// YF-S401 toi da 6 L/phut x 98 = 588 Hz -> moi xung cach nhau >= 1700 us.
// Dat 1200 us cho tran 833 Hz: con du 40 phan tram bien so voi cam bien
// that, nhung cat bot phan lon nhieu do Wi-Fi da do duoc o 1600-2700 Hz.
#define FLOW_MIN_PULSE_US   1200UL

// Tan so xung LON NHAT ma cam bien co the sinh ra ve mat vat ly.
// YF-S401 chay het co 6 L/phut x 98 xung moi lit/phut = 588 Hz.
// YF-S201 chay het co 30 L/phut x 7,5 = 225 Hz.
// Lay 1200 Hz la rong gap doi truong hop nhanh nhat.
//
// CAO HON SO NAY KHONG PHAI LA NUOC. Do thuc te tren mach ngay 21/09: chan
// GPIO 4 dem duoc 17 000 Hz khi da TAT Wi-Fi va khong co giot nuoc nao chay.
// Day tin hieu dang tha noi tren dien tro keo len noi bo 45 kOhm nen bat song.
//
// Phai bat duoc truong hop nay, vi bo loc FLOW_MIN_PULSE_US khong loai bo
// duoc nhieu — no chi lay mau thua ra, bien 17 000 Hz thanh 833 Hz, tuc
// 8,5 L/phut, mot con so trong RAT THAT. Doc con so do vao rang buoc an toan
// con nguy hiem hon la khong co cam bien.
// HA TU 1200 XUONG 700 ngay 22/09. Do sau khi gan dien tro 4,7 kOhm, luc bom
// chay hai chan van cho 1474 va 1548 Hz. Mot phan nhieu do dao dong xuong
// duoi 1200 Hz va LOT QUA cong, cong don hon 2 lit ao trong vai giay va lam
// no bao dong gia VOLUME_LIMIT ngay trong lan bom dau tien.
//
// 700 Hz van cao hon gioi han vat ly 588 Hz cua YF-S401, va cao gap hai muoi
// lan tan so that cua he nay: bom day 0,36 L/phut, tuc chi 35 Hz.
#define FLOW_MAX_PLAUSIBLE_HZ   700.0f

// ---------- TAT HAI CAM BIEN LUU LUONG ----------
// Dat 0 khi day tin hieu chua dau xong. Do that ngay 21/09, bom da rut,
// khong mot giot nuoc chay:
//    GPIO 4  : 3 445 Hz keo len · 13 403 Hz khong keo · 3 150 Hz keo xuong
//    GPIO 19 : 3 282 Hz keo len · 12 123 Hz khong keo · 2 938 Hz keo xuong
//    GPIO 23 : 0 Hz keo len · 0 Hz keo xuong   <- chan doi chieu, khong noi gi
// Tan so DOI theo tung kieu keo, nghia la khong co nguon nao giu chac day.
// Gioi han vat ly cua YF-S401 la 588 Hz.
//
// Nhieu do lot qua duoc nguong 1200 Hz tung luc, sinh ra 8 lit "da bom" trong
// mot bon 1 lit, va lam no cac bao dong gia LEAK_SUSPECTED va VOLUME_LIMIT.
// Mot cam bien noi doi thi phai TAT han, khong duoc tin mot nua: he van chay
// dung bang cam bien muc, hai phao va cam bien dong dien.
//
// Bat lai thanh 1 sau khi da: cap du 5 V va GND cho ca hai cam bien, va gan
// dien tro keo len 4,7 kOhm tu moi chan tin hieu len 3,3 V.
// Kiem tra bang: pio run -e test_flownoise -t upload -t monitor
// 21/09, sau khi bo TXS0108E khoi hai chan luu luong:
//    GPIO 4  : 3 445 Hz  ->  25 Hz   (keo len 3,3 V)
//    GPIO 19 : 3 282 Hz  ->  51 Hz
//    GPIO 23 : 0 Hz (chan doi chieu, khong noi gi)
// Giam khoang 100 lan, du duoi nguong 1200 Hz nen bat lai duoc.
// VAN CON 25-51 Hz, tuc 0,26 va 0,52 L/phut ao — xem muc canh bao ben duoi.
// 22/09, SAU KHI GAN DIEN TRO 4,7 kOhm len 3,3 V cho ca hai chan:
//    bom TAT  : GPIO 19 = 0,0 Hz    ·  GPIO 4 = 0,0 Hz     <- sach tuyet doi
//    bom CHAY : GPIO 19 = 1548,4 Hz ·  GPIO 4 = 1474,4 Hz
//
// Nen luc bom tat gio DUNG BANG 0, truoc do la 25-51 Hz. So doc luc khong bom
// da dung duoc, va bo dem the tich khong con cong don rac nua.
//
// Luc bom chay van con khoang 1500 Hz, tuc 15,8 L/phut trong khi bom that chi
// day 0,36 L/phut — van la nhieu, nhung da giam ba lan so voi 4750 Hz do duoc
// truoc khi gan dien tro. Phan con lai thuoc ve diot 1N4007 mac song song
// nguoc hai cuc bom va viec tach day bom khoi day tin hieu.
//
// Cong FLOW_MAX_PLAUSIBLE_HZ = 1200 Hz bat duoc muc 1500 Hz nay va bao
// "khong tin duoc" dung trong khoang bom chay, nen bat cam bien la an toan.
#define FLOW_SENSOR_ENABLED   1

// ---------- SUY LUU LUONG TU MUC NUOC ----------
// Dat 1 de BO HAN hai cam bien luu luong va tinh moi thu tu toc do doi muc.
//
// Ly do: do ngay 22/09, luu luong xa that la 0,147 L/phut, trong khi dai lam
// viec cua YF-S401 la 0,30 - 6,00 L/phut. Luu luong that nam duoi day dai hai
// lan nen canh quat khong quay, va cam bien dau ra doc 0 mai mai. Khong phai
// hong, chi la sai dai do.
//
// Muc nuoc sau khi loc thi du muot de lam viec nay: chinh con so 0,147 L/phut
// o tren duoc tinh ra tu muc nuoc, va no dang tin hon cam bien dang lap.
//
//    luu luong rong = toc do doi muc (cm/s) x tiet dien (cm2) x 60 / 1000
//    dau ra         = luu luong bom - luu luong rong
//    dau vao        = luu luong bom khi bom chay, bang 0 khi bom tat
//
// Cai gia phai tra: dau vao thanh mot hang so hieu chuan chu khong con la
// phep do doc lap, nen luat DRY_RUN mat y nghia va bi tat theo. Chay kho van
// duoc bat bang NO_CURRENT va NO_PROGRESS.
#define FLOW_FROM_LEVEL       1

// Luu luong bom, DO TREN MACH THAT ngay 21/09 bang toc do doi muc nuoc:
// muc len 1,2 cm trong 20 giay tren tiet dien 100 cm2 = 0,36 L/phut.
// Datasheet JT-DC3L ghi 1,67 L/phut o cot nuoc bang 0; chenh gan nam lan
// la do cot nuoc va suc can duong ong. Dung so DO DUOC, khong dung datasheet.
#define PUMP_FILL_LPM       0.36f

// He so lam muot cho toc do doi muc. Toc do la dao ham nen no khuech dai
// nhieu; can lam muot manh hon ca ban than muc nuoc. 0,02 o chu ky 200 ms
// cho hang so thoi gian khoang 10 giay.
#define LEVEL_RATE_ALPHA    0.02f

// ---------- Uoc luong dong xa ----------
// Dong xa CHI duoc do khi bom TAT va muc nuoc da on dinh, roi GIU NGUYEN
// trong luc bom chay — do mo van xa khong doi khi bom bat.
//
// Vi sao: cong thuc cu (dau ra = luu luong bom - toc do doi muc) lay mot
// buoc nhay TUC THI (bom bat, 0 -> 0,36 L/phut) tru di mot uoc luong TRE
// (bo loc can vai giay moi nhan ra muc da bat dau len). Trong vai giay do dau
// ra vot len theo bom, luc bom tat thi tut ve 0. Nguoi dung thay duong do
// nhay len dung luc duong xanh nhay len — van xa khong he biet bom bat.
//
// Toc do tu bo loc alpha-beta (alpha 0,03) co hang so thoi gian khoang
// 0,2 / sqrt(beta) = 9,4 giay, nen doi 20 giay sau khi bom tat moi bat dau do.
#define DRAIN_SETTLE_MS     20000UL
// Lam muot rieng cho dong xa: 0,01 o chu ky 200 ms la khoang 20 giay.
#define DRAIN_EMA_ALPHA     0.01f

// ---------- Tham so dieu khien ----------
#define LEVEL_LOW_PCT       30.0f
// Ha tu 80 xuong 70 va tu 95 xuong 85 de mat nuoc dung xa mat cam bien hon.
// Bon cao 25 cm: dung o 70% la nuoc cao 17,5 cm, con cach cam bien 37,5 cm;
// khoa chong tran o 85% la nuoc cao 21,3 cm, con cach cam bien 33,7 cm.
// Truoc day dung o 80% va khoa o 95% thi chi con cach 32,5 va 26,3 cm,
// qua sat vung mu 2 cm cua HC-SR04 va qua sat mieng bon.
#define LEVEL_HIGH_PCT      70.0f
#define LEVEL_OVERFLOW_PCT  85.0f

// Chan an toan doc thang tu khoang cach tho, KHONG qua bo loc nao.
// Cam bien doc gan hon so nay la nuoc da len qua cao: NGAT BOM NGAY.
// Doc lap hoan toan voi levelOk, voi trung vi va voi phao.
// Muc cao nhat 10 cm thi khoang cach con 15,5 - 10 = 5,5 cm.
// Dat chan cung o 4,5 cm: gan hon the la nuoc da vuot muc lam viec 1 cm,
// va cung da cham nguong so doc khong con dang tin cua HC-SR04.
// Dich theo TANK_SENSOR_TO_BOTTOM_CM. Chan cung dat o muc 11 cm, tuc cao hon
// muc lam viec 10 cm dung 1 cm: khoang cach con 17,5 - 11 = 6,5 cm.
// Chan cung dat o muc nuoc 13 cm, tuc con cach mieng thung 1 cm:
// khoang cach cam bien 17,5 - 13 = 4,5 cm.
#define LEVEL_MIN_DISTANCE_CM   4.5f

// Bao nhieu lan phat LIEN TIEP duoi nguong tren thi moi coi la nuoc that su
// da len qua cao. Mot lan duy nhat khong du: do that cho thay cam bien thinh
// thoang tra ve mot so ngan vo co, va luc bom vua khoi dong thi con hay hon.
// Da gap: bom vua bat 4 giay da bi khoa OVERFLOW trong khi bon dang can kiet.
//
// 3 lan x chu ky 200 ms = 600 ms. Nuoc day nhanh nhat cung chi len 0,278 cm/s,
// tuc 0,17 cm trong 600 ms — khong the vuot qua chan an toan trong khoang do.
#define TOO_CLOSE_STREAK        3
// Bon chi 1 lit. Bom JT-DC3L day 1,67 L/phut, tuc 0,028 L moi giay.
// Giu bom chay toi thieu 10 giay la bom them 0,28 lit, bang 28 phan tram
// bon — du de vot tu nguong dung 70 phan tram len gan tran. Ha xuong 3 giay:
// chi con 8 phan tram, van du dai de tranh ro le dong cat lien hoi.
#define MIN_ON_MS            3000UL
#define MIN_OFF_MS          20000UL
// Thoi gian bom toi da truoc khi ket luan bat thuong.
// TINH LAI THEO BOM THAT (JT-DC3L, 100 L/gio = 1,67 L/phut o cot nuoc bang 0):
//    the tich bon      = 100 cm2 x 10 cm = 1 L
//    bom tu 30% len 80% = 5 L
//    o luu luong TOI DA  : 5 / 1,67 x 60 = 180 s  <- dung bang gia tri cu
//    o luu luong thuc te : bom co cot nuoc nen cham hon, khoang 300 s
// Gia tri cu 180 s se bao FILL_TIMEOUT ngay trong lan bom binh thuong.
// Dat 600 s = khoang hai lan thoi gian day thuc te. PHAI do lai bang thi
// nghiem E3 roi chinh cho khop bom cua ban.
// TINH LAI THEO BON THAT (1 lit) VA BOM THAT (JT-DC3L, 1,67 L/phut):
//    day tu 30% len 70% = 0,4 lit -> 14 giay o luu luong toi da
//    day tu can len day  = 1,0 lit -> 36 giay o luu luong toi da
// Co cot nuoc thi cham hon, cu cho la cham gap doi: 72 giay.
// Dat 90 giay. Gia tri cu 240 giay rong gap hon ba lan thuc te, tuc la
// bom co the chay them hon hai phut sau khi bon da day.
// DO THAT NGAY 21/09 tren bom da lap vao he: muc len 1,2 cm trong 20 giay,
// tuc 0,06 cm/s = 0,36 L/phut. Cham hon datasheet (1,67 L/phut) gan nam lan
// vi con cot nuoc va suc can duong ong.
//    day tu can len 70 phan tram = 7 cm -> 117 giay
// Dat 200 giay, rong gan gap doi. Gia tri cu 90 giay se bao FILL_TIMEOUT
// ngay giua mot lan bom hoan toan binh thuong.
// TINH LAI theo muc lam viec 14 cm va toc do RONG do duoc 0,032 cm/s
// (van xa luon mo): day tu 30 phan tram len 70 phan tram la 5,6 cm, het 175
// giay. Gia tri cu 200 giay sat qua, se bao FILL_TIMEOUT ngay giua lan bom
// binh thuong. Dat 240 giay: vua du, va den luc do neu cam bien con tot thi
// khoa chong tran o 85 phan tram cung da chan truoc roi.
#define MAX_FILL_MS         240000UL

// ---------- Ba chan an toan KHONG phu thuoc cam bien sieu am ----------
// Bon 10 lit. Bom them qua so nay trong MOT lan bom la chac chan co van de:
// hoac cam bien muc sai, hoac nuoc dang chay di dau do.
// The tich lam viec gio la 100 cm2 x 14 cm = 1,4 lit.
#define MAX_FILL_VOLUME_L    2.5f

// Bom chay ma muc nuoc khong nhich len duoc NO_PROGRESS_CM trong
// NO_PROGRESS_MS thi ngat. Bom that day 1,67 L/phut vao tiet dien 400 cm2
// tuc 0,069 cm/s, nen trong 60 s phai len it nhat 4,1 cm. Lay 1,5 cm la
// rong gap gan ba lan, du cho bom yeu hay cot nuoc cao.
// Voi toc do do duoc 0,06 cm/s, trong 45 giay muc phai len 2,7 cm.
// Doi hoi 1,0 cm la chi bang mot phan ba thuc te — du rong de nhieu +-1 cm
// cua sieu am khong gay bao dong gia, van du chat de bat duoc cam bien noi doi.
// Ban cu 20 giay/1,0 cm da bao NO_PROGRESS ngay giua lan bom binh thuong.
// TINH LAI ngay 22/09 theo nhieu DO DUOC luc bom chay.
//
// Muc nuoc luc bom chay dao dong khoang +-0,6 cm, tuc dai dinh-dinh 1,2 cm.
// Nguong cu 1,0 cm NAM TRONG dai nhieu do, nen hai chuyen xay ra:
//   - mot so doc vot cao dat "moc tien do" len cao gia tao, va muc that sau
//     do khong bao gio vuot noi moc + 1,0 cm nua;
//   - bao dong NO_PROGRESS no giua lan bom hoan toan binh thuong.
//
// Dat 2,0 cm, cao hon han dai nhieu 1,2 cm. Trong 60 giay bom that dua muc
// len 0,06 x 60 = 3,6 cm, tuc van gap 1,8 lan nguong. Hai dai tach han nhau.
//
// 60 giay bom them 0,36 lit vao bon 1 lit. Chap nhan duoc, va MAX_FILL_MS,
// PUMP_HARD_LIMIT_MS, waterTooClose cung phao muc cao deu van canh.
// TINH LAI ngay 23/09 theo toc do RONG do duoc khi van xa DANG MO.
//
// Sai cu: toi lay 0,06 cm/s, la toc do bom khi van xa DONG. Van cua nguoi
// dung luon mo, nen nuoc vao mot phan chay ra ngay. Toc do RONG do duoc:
//    3,13 cm luc 10:29:46  ->  5,63 cm luc 10:31:05  =  0,032 cm/s
// Trong 60 giay muc chi len 1,9 cm, tuc NGAY DUOI nguong 2,0 cm. Bao dong
// gia la chac chan xay ra, va da xay ra: NO_PROGRESS no dung luc muc dang
// len muot va cam bien dang doc tot.
//
// Dat 90 giay / 1,5 cm. Toc do doi hoi la 1,5/90 = 0,0167 cm/s, bang mot
// nua toc do rong do duoc — bien an toan 1,9 lan. Nhieu cua muc nuoc sau khi
// loc chi con khoang 0,1 cm moi buoc nen 1,5 cm nam cao hon han.
//
// 90 giay bom them 0,54 lit. Bon 1 lit, nhung nguong dung 70 phan tram va
// MAX_FILL_MS = 200 s deu cat truoc, va day chi la luoi do cuoi cung cho
// truong hop cam bien muc noi doi.
#define NO_PROGRESS_MS      90000UL
#define NO_PROGRESS_CM      1.5f

// Tran cuoi cung. Khong dieu kien, khong ngoai le, khong tu phuc hoi.
// Bom khong duoc phep chay lien tuc lau hon so nay du bat ky ly do gi.
#define PUMP_HARD_LIMIT_MS  300000UL

// ---------- Nguong phat hien su co ----------
#define DRYRUN_MS           6000UL
#define DRYRUN_FLOW_LPM     0.25f
#define NOCURRENT_MS        2000UL
// Nguong nhan biet bom dang co dong, do tai CHAN ESP32 sau chia ap 10k/10k.
// TINH THEO BOM THAT (JT-DC3L, 100~200 mA):
//    ACS712-5A   185 mV/A -> 200 mA cho 37,0 mV -> sau chia ap 18,5 mV
//    ACS712-20A  100 mV/A -> 200 mA cho 20,0 mV -> sau chia ap 10,0 mV
//    ACS712-30A   66 mV/A -> 200 mA cho 13,2 mV -> sau chia ap  6,6 mV
// CHI loai 5A moi vuot nguong nay, va bien an toan chi con 23 phan tram.
// Dung loai 20A hay 30A thi luat NO_CURRENT khong bao gio phat hien duoc.
// Chay test_current de do so that roi dat nguong bang khoang MOT NUA
// hieu giua luc bom chay va luc bom tat.
// Do tren mach that: bom chay cho hieu 19,6 den 22,6 mV so voi diem nghi.
// Dat 10 mV la khoang mot nua, du xa nhieu nen ma van bat duoc bom chay.
#define CURRENT_ON_MV       10.0f

// Doi dien ap cam bien dong ra mA. ACS712 ban 5 A: 185 mV moi ampe. Theo so do
// mach (KiCad, 06/10) chia ap la R12 10k noi tiep, R13 20k xuong dat, he so 2/3,
// con 123,3 mV moi ampe tai chan ESP32, tuc 8,11 mA moi mV. (Ban cu gia dinh
// 10k/10k, 10,81 mA/mV, nen bao dong cao hon that 4/3 lan.)
// Loai 20 A: 100 mV/A -> 20,0 mA/mV. Loai 30 A: 66 mV/A -> 30,3 mA/mV.
// Neu KHONG co chia ap thi chia doi cac so tren.
// Kiem chung mot lan bang dong ho van nang mac noi tiep voi bom.
#define CURRENT_MA_PER_MV   8.11f

// Nen nhieu cua phep do dong. Do ngay 23/09, bom TAT, 40 mau: 0 .. 2,7 mV,
// tuc 0 .. 29 mA — chi la nhieu cua bo ADC ESP32 (mot nac da la 0,8 mV).
// Bom CHAY cho tu 20 mV tro len. Duoi 4 mV thi bao 0 mA: phep do nay khong
// phan giai duoc dong nho hon khoang 40 mA, bao so le duoi muc do la bao sai.
#define CURRENT_NOISE_MV     4.0f

// ---------- Phan loai suc khoe bom ----------
// Phan nang cao thu hai de bai cho phep: "pump-current/flow consistency to
// classify pump faults". Ket hop hai bang chung DOC LAP — dong dien qua bom
// va nuoc co chay vao hay khong — de tach cac kieu hong ra:
//    co dong, co nuoc     -> ok
//    khong dong           -> no_current : ro le, day noi, hoac dong co chay
//    co dong, khong nuoc  -> no_flow    : chay kho, ong hut ho, hoac bi tac
// Bang chung nuoc chay: muc nuoc dang len (khi suy luu luong tu muc), hoac
// cam bien luu luong co xung (khi dung cam bien).
//
// Muc nuoc len rong 0,032 cm/s do duoc khi van xa mo. Lay mot phan ba lam
// nguong, va cho 25 giay de bo loc toc do on dinh sau khi bom bat.
#define PUMP_START_MS        2000UL

// Bom chay KHO nhan ra bang DONG DIEN (do 07/10 tren bom that): ngap nuoc
// 39-41 mV ~ 320-330 mA; nhac khoi nuoc 26-28 mV ~ 215-230 mA. Dong co mat
// tai nen an it dong hon. Duoi nguong nay lien tuc DRY_CURRENT_MS (sau
// PUMP_START_MS khoi dong) thi bao DRY_RUN va khoa bom, khong phai cho 90 s
// cua NO_PROGRESS. Dat giua hai muc, cach moi ben khoang 45 mA.
#define DRY_CURRENT_MA      270.0f
#define DRY_CURRENT_MS     3000UL
#define FLOW_EVIDENCE_MS    25000UL
#define FLOW_EVIDENCE_CMS    0.010f

// Toc do bam theo diem nghi khi bom dang tat. 0,02 voi chu ky 200 ms cho
// hang so thoi gian khoang 10 giay: du nhanh de theo kip troi nhiet, du
// cham de khong bi mot xung nhieu keo di.
#define CURRENT_OFFSET_ALPHA  0.02f

// Cho bao lau sau khi cap nguon moi do diem nghi lan dau, tinh bang ms.
#define CURRENT_SETTLE_MS     1500UL
#define LEAK_MS             60000UL
#define LEAK_FLOW_LPM       0.20f
// Nang 4 -> 9 giay, phai lon hon LEVEL_STALE_MS mot khoang du rong.
// levelOk chi ha khi da 5 giay khong co so doc hop le nao; bao su co ngay o
// giay thu 4 nghia la bao truoc ca khi co dieu gi dang xay ra.
// Bom van duoc canh doc lap: FILL_LEVEL_GRACE_MS 10 s, MAX_FILL_MS 200 s,
// PUMP_HARD_LIMIT_MS 240 s, waterTooClose va phao muc cao.
// Nang 9 -> 20 giay. Do that ngay 23/09: cam bien nay sap tung dot 10-20
// giay roi tu hoi, va moi dot deu sinh ra mot bao dong FAULT_SENSOR du khong
// co gi phai xu ly — nhat la sau khi lan bom da ket thuc binh thuong.
//
// Khi bom TAT thi mot doan mu 20 giay khong gay hai gi: khong co gi dang
// chay de phai ngat. Khi bom CHAY thi luat nay khong dung con so 20 giay ma
// dung MODEL_MAX_BLIND_MS, va mo hinh muc nuoc cam lai trong suot doan do.
// Nang 9 -> 45 giay, bang dung MODEL_MAX_BLIND_MS.
//
// Do that ngay 23/09: cam bien nay sap tung dot 10-25 giay roi tu hoi lai.
// Voi nguong 9 hay 20 giay thi MOI dot deu sinh ra mot FAULT_SENSOR, ke ca
// khi dot do xay ra NGAY SAU mot lan bom da ket thuc binh thuong — khong co
// gi phai xu ly, chi la mot dong chu do tren giao dien.
//
// Khi bom TAT thi mot doan mu 45 giay khong gay hai: khong co gi dang chay
// de phai ngat. Khi bom CHAY thi luat nay cung dung 45 giay, va trong suot
// doan do mo hinh muc nuoc cam lai viec dieu khien.
//
// Cam bien hong THAT — nhu hom qua, 242 lan phat khong mot tieng doi — van
// bi bao sau 45 giay. Do moi la truong hop luat nay sinh ra de bat.
#define SENSOR_TIMEOUT_MS  45000UL

// Bao lau khong co mot phep do hop le nao thi coi la MAT cam bien.
//
// HC-SR04 trong thung 10 x 10 cm rot khoang 30 phan tram so lan phat: chum
// song 15 do o khoang 15 cm da rong hon 7 cm nen tia bien danh vao thanh
// thung, co lan khong co tieng doi tro ve kip.
//
// Ban cu cho levelOk = false ngay tu MOT lan rot. Hau qua: levelOk lat
// lien tuc 200 ms mot lan, va nhom ST_FAULT_SENSOR — von doi 5 GIAY LIEN TUC
// khong rot lan nao moi chiu phuc hoi — khong bao gio thoat ra duoc.
// Thiet bi ket o SENSOR_TIMEOUT vinh vien du cam bien van chay.
//
// Nay giu lai so doc hop le cuoi trong 2 giay. Rot le di qua duoc, mat that
// van bi bat sau 2 giay, va ST_FILLING van ngat bom ngay khi levelOk false.
// Nang 3 -> 5 giay. Cua so trung vi gio dai 15 mau, tuc 3 giay, nen sau mot
// chuoi phat hong no can chung do thoi gian de gom lai du mau. Giu 3 giay thi
// levelOk ha xuong ngay truoc khi cua so kip day lai.
#define LEVEL_STALE_MS      5000UL

// Bom duoc phep chay tiep bao lau khi DANG BOM ma mat tin hieu muc.
//
// Vi sao can: do that cho thay HC-SR04 rat on dinh khi nuoc dung yen — 20 mau
// lien tiep, do lech chuan 0,010 cm. Nhung luc bom chay thi mat nuoc gon,
// tieng doi tan di, cua so trung vi trai rong qua LEVEL_SPREAD_MAX_CM va
// levelOk ha xuong. Ban cu ngat bom NGAY luc do, nen lan bom nao cung dung
// somn o khoang 50 phan tram thay vi len toi nguong 70 phan tram.
//
// Vi sao an toan: chan cuoi cung waterTooClose doc THANG khoang cach tho tu
// tung lan phat, khong qua cua so trung vi, nen no VAN lam viec trong suot
// khoang an han nay. Phao muc cao, PUMP_HARD_LIMIT_MS, MAX_FILL_MS va
// NO_PROGRESS cung deu khong phu thuoc levelOk.
//
// 10 giay o luu luong do duoc 0,36 L/phut la them 0,06 lit, tuc 6 phan tram
// cua bon 1 lit. Cong voi LEVEL_STALE_MS thi toi da 13 giay khong co so doc.
#define FILL_LEVEL_GRACE_MS 10000UL

// ---------- MO HINH MUC NUOC CHAY SONG SONG ----------
// Bai toan: cam bien sieu am thinh thoang mat han vai chuc giay giua lan bom.
// Do that: 75 giay dau sach, muc len muot 2,91 -> 5,42 cm, roi cam bien sap
// khoang 80 giay va tu hoi lai. Moi lan nhu vay bom bi ngat o khoang 50 phan
// tram va khong bao gio len duoc toi nguong 70.
//
// Cach chua: chay mot mo hinh muc nuoc song song. Khi co so do that thi mo
// hinh duoc keo dan ve so do; khi mat cam bien thi mo hinh tu chay tiep bang
// phep tich phan, va may trang thai dieu khien theo no.
//
// Mo hinh KHONG duoc phep thay the cam bien lau dai: sau
// MODEL_MAX_BLIND_MS ma van khong co so do that nao thi ngat bom va bao loi.
// 60 giay chay mu them 0,36 lit vao bon 1 lit. Chan waterTooClose doc thang
// khoang cach tho, phao muc cao, MAX_FILL_MS va PUMP_HARD_LIMIT_MS deu van canh.
#define MODEL_CORRECT_ALPHA 0.05f

// Sau mot doan mat cam bien, so doc quay lai phai nam trong khoang nay so voi
// mo hinh thi moi duoc nhan.
//
// Do that ngay 23/09: cam bien mat luc muc o 5,83 cm, mo hinh chay tiep len
// 6,91 cm, roi cam bien quay lai voi so doc 0,15 cm. Khong co cong nay thi
// so 0,15 duoc nhan ngay, lastGoodLevelCm nhay ve 0,15, mo hinh bi keo sup
// va lan bom bi huy khi chi con 0,09 cm nua la toi nguong dung.
//
// Mot lan quay lai KHAC cho 6,22 cm — lech 0,7 cm so voi mo hinh, hoan toan
// hop ly. 2,5 cm nhan duoc truong hop do va loai truong hop 0,15 cm.
//
// Cong nay chi lam viec sau khi da mat cam bien; luc dang doc binh thuong
// thi mo hinh khong co quyen phu quyet gi ca.
#define MODEL_REJOIN_CM     2.5f
// 45 giay chu khong 60. Tinh theo so do that: cam bien sap o khoang 5,8 cm,
// va tu do len nguong dung 7,0 cm chi con 1,2 cm. O toc do rong 0,032 cm/s
// la 38 giay. 45 giay du cho mo hinh hoan thanh lan bom, va khong du de no
// di qua xa neu mo hinh sai.
#define MODEL_MAX_BLIND_MS  90000UL   // 05/10: vung mu ~8-9 cm duoi cam bien can toi ~75 s
// Ha 5 -> 2,5 giay. Doi 5 giay LIEN TUC khong rot lan nao la qua kho voi cam
// bien nay, nen thiet bi ket lai o nhom su co lau hon han thoi gian no that
// su hong. levelOk gio da co san 5 giay du tru ben trong roi.
#define SENSOR_RECOVER_MS   2500UL
#define CONFLICT_LEVEL_PCT  70.0f
// Phao muc thap bao "da tut duoi vach thap" ma sieu am lai bao day hon so
// nay thi hai cam bien dang noi nguoc nhau — mot trong hai dang hong.
#define CONFLICT_MIN_PCT    60.0f
// Toc do doi muc nuoc toi da coi la co the ve mat vat ly, cm moi giay.
// TINH THEO BOM THAT: 1,67 L/phut / 100 cm2 = 0,278 cm/s khi bom.
// Xa nhanh qua voi mo cung chi khoang 0,2 cm/s.
// Dat 1 cm/s: rong gap 3,6 lan truong hop bom nhanh nhat, du cho ca luc xa
// nuoc, nhung chan duoc phan lon xung nhieu cua cam bien sieu am.
#define MAX_LEVEL_RATE_CMS  1.0f

// Sai so do cua rieng phep do, khong lien quan gi toi nuoc chay nhanh hay cham.
// Do that trong thung 10 x 10 cm: hai lan doc lien tiep cach nhau 0,2 giay
// lech nhau toi 1,1 cm. Chum song 15 do cua HC-SR04 o khoang 15 cm da rong
// hon 7 cm, tia bien danh vao THANH thung roi moi doi ve nen moi lan do lai
// chon mot duong di khac.
//
// Neu chi lay MAX_LEVEL_RATE_CMS x dt lam gioi han thi trong mot chu ky 0,2 s
// chi cho phep lech 0,2 cm, va moi so doc that deu bi loai oan — thiet bi
// bao SENSOR_TIMEOUT lien tuc du cam bien van chay tot.
//
// Cong them so nay vao gioi han: nhieu tung mau di qua duoc, nhung neu muc
// nuoc troi that thi qua vai giay tich luy lai van vuot gioi han va bi bat.
#define LEVEL_NOISE_CM      2.0f

// Muc nuoc duoc phep TUT bao nhieu trong mot chu ky KHI BOM DANG CHAY.
//
// Rang buoc vat ly: bom day 0,36 L/phut, xa trong luc chi 0,147 L/phut, nen
// bom chay thi muc BAT BUOC phai len. Bat ky so doc tut xuong nao trong luc
// do cung la sai, va chi duoc phep lech bang dung sai so cua phep do.
//
// Vi sao can rieng con so nay: cong chan toc do cu doi xung, cho phep lech
// 1,0 x dt + 2,0 = 2,2 cm moi chu ky theo CA HAI chieu. Do that ngay 23/09
// cho thay cam bien khong sup mot phat ma TRUOT DAN qua vai chu ky —
// 5,6 -> 3,5 -> 1,5 -> 0,5 cm — moi buoc deu duoi 2,2 cm nen lot qua het,
// va levelOk van bao true suot. Mo hinh bi keo theo va NO_PROGRESS no.
//
// 1,0 cm chan duoc chuoi truot do ngay tu buoc dau, trong khi van rong gap
// muoi lan nhieu con lai sau bo loc (khoang 0,1 cm moi buoc).
#define LEVEL_FALL_PUMPING_CM  1.0f
// So lan lien tiep cong "tut khi dang bom" duoc phep chan truoc khi coi
// cu tut la that (10 x 200 ms = 2 s). Xem readLevel().
#define FALL_ACCEPT_STREAK     255   // 05/10: tat — tieng doi lac o vung mu cung on dinh, khong duoc tin
// So doc on dinh lien tiep can de thang cong "lech mo hinh" (xem readLevel)
#define JOIN_ACCEPT_STREAK     255   // 05/10: tat — mo hinh da dung luu luong do that

// ---------- Chu ky ----------
#define CONTROL_PERIOD_MS   200UL
// Khoang cach toi thieu giua hai lan phat sieu am. Datasheet HC-SR04 khuyen
// tren 60 ms de tieng vong cua lan truoc kip tat han. Ban cu phat 5 lan lien
// tiep cach nhau 6 ms nen lan sau bat phai tieng vong cua lan truoc.
// Nay moi chu ky dieu khien chi phat MOT lan, va lay trung vi truot 5 mau.
// 9 chu khong phai 5. Do that trong thung 10 x 10 cm: ngoai nhieu +-1 cm,
// cam bien con thinh thoang cho SAI SO THO — doc 0,00 cm trong khi bon dang
// o 4,6 cm. Cua so 5 mau chi chiu duoc 2 mau hong lien tiep; 9 mau chiu duoc 4.
// 9 mau x 200 ms = 1,8 giay, trong do nuoc chi kip dang 0,11 cm nen khong
// lam cham phan ung chut nao.
// 15 chu khong phai 9. Do ngay 22/09, bom TAT va mat nuoc tinh, 40 mau:
//    do lech chuan 0,472 cm · dai dao dong 2,32 cm · buoc nhay lon nhat 1,75 cm
// Trong khi nuoc that chi tut 0,013 cm moi giay. Nhieu gap hai muoi lan tin
// hieu. Cua so 9 mau chiu duoc 4 mau hong lien tiep; 15 mau chiu duoc 7.
#define LEVEL_MEDIAN_WINDOW 15
// Lay phan vi thu bao nhieu cua cua so lam so do (50 = trung vi).
// Do 05/10: tieng doi yeu lam HC-SR04 bat tre 1-4 chu ky song 40 kHz, moi
// chu ky +0,43 cm; nuoc dung yen ma so doc la 14,2 / 14,7 / 15,5 / 16,4 cm.
// Loi nay CHI lam doc XA HON, khong bao gio gan hon, nen phan vi 25 sat
// khoang cach that hon trung vi.
#define LEVEL_PICK_PCT      25

// ---------- Bo loc lam muot dau ra ----------
// Trung vi chi loai dot bien, no KHONG lam muot. Chin mau deu lech +-0,5 cm
// thi trung vi cua chung van lech +-0,5 cm, va phan tram tren giao dien nhay
// giat cuc hai muoi phan tram du mat nuoc dung yen.
//
// Trung binh truot mu dat SAU trung vi moi lam muot duoc. He so 0,06 o chu ky
// 200 ms cho hang so thoi gian khoang 3,2 giay, va giam nhieu ngau nhien
// khoang sau lan: sqrt(0,06 / 1,94) = 0,176.
//
// Cai gia phai tra la tre 3,2 giay. Nuoc chay nhanh nhat cung chi 0,06 cm/s,
// nen tre do tuong duong sai lech 0,19 cm — nho hon ca sai so cua phep do.
// Chan an toan waterTooClose doc thang khoang cach THO nen khong he bi tre.
#define LEVEL_EMA_ALPHA     0.06f   // khong con dung, giu cho ban cu doc duoc

// He so bo loc alpha-beta. 0,03 o chu ky 200 ms giam nhieu ngau nhien khoang
// sau lan (tu +-0,3 xuong +-0,05 cm), trong khi nuoc xa that tut 0,12 cm moi
// 5 giay — nhieu con lai nho hon han buoc that, nen so hien thi di mot chieu.
#define LEVEL_AB_ALPHA      0.03f
// Bien ngoai dai hinh hoc con chap nhan, tinh bang cm. So doc nam ngoai
// [15,5-10-6 , 15,5+6] = [-0,5 , 21,5] cm bi loai truoc khi vao cua so trung vi.
#define LEVEL_GATE_MARGIN_CM   6.0f
// So doc xa hon day bon qua muc nay la tieng doi lac, bo
#define LEVEL_FLOOR_MARGIN_CM  1.0f

// Do phan tan toi da trong cua so trung vi, tinh bang cm.
//
// Do that khi bom dang chay: cam bien nhay qua lai giua 4,8 cm va 0,00 cm —
// luc thay mat nuoc, luc nhin xuyen xuong DAY thung. Mat nuoc bi dong nuoc
// vao lam gon nen tieng doi tan di, chi con tieng doi tu day tro ve.
//
// Trung vi khong cuu duoc kieu hong nay: khi hai nhom xap xi bang nhau thi
// trung vi chi la mot lan tung dong xu. Thay vi doan bua, hay noi thang la
// KHONG BIET — cac chan an toan theo thoi gian van lam viec binh thuong.
// Noi tu 3,0 len 4,5 cm cho khop cua so 15 mau: cua so dai hon thi trai qua
// nhieu thoi gian hon nen tu nhien rong hon. Trung vi 15 mau cong bo loc mu
// da du suc xu ly do phan tan nay.
// Gio la nguong cho KHOANG TU PHAN VI, khong con la max - min. Nhieu binh
// thuong cho khoang tu phan vi duoi 0,5 cm. Cam bien nhay giua mat nuoc va day
// thung cho vai cm. 2,0 cm tach hai truong hop ra ro rang.
// Do that 23/09 voi 2,0 cm: ty le nhan tang 60 -> 80 phan tram nhung van
// con chum mau bi loai lien nhau. Khi cam bien that su lan giua mat nuoc va
// day thung thi hai nhom cach nhau ~9 cm (17,5 cm so voi ~8 cm), con nhieu
// thuong nho hon 0,5 cm. 3,5 cm van thap hon han khoang cach 9 cm do.
#define LEVEL_SPREAD_MAX_CM    3.5f

// ---------- CHE DO CHAN DOAN: TIN CAM BIEN MUC VO DIEU KIEN ----------
// Dat 1 de BO cong xac thuc: bo kiem tra do phan tan cua so, bo cong chan
// toc do doi muc. levelOk chi con false khi that su KHONG co mot tieng doi
// nao trong LEVEL_STALE_MS.
//
// DUNG DE XEM HE CHAY RA SAO, KHONG PHAI DE CHAY LAU DAI.
// Bo hai cong nay la nhan luon ca cac so doc sai tho — da tung do duoc cam
// bien nhay qua lai giua 4,8 cm va 0,00 cm trong khi bom chay.
//
// Nhung chan an toan sau VAN LAM VIEC day du, vi khong cai nao dua vao levelOk:
//    waterTooClose   doc thang khoang cach tho tung lan phat
//    phao muc cao    tiep diem co khi, doc lap hoan toan
//    NO_PROGRESS     bom chay ma muc khong len
//    MAX_FILL_MS     va PUMP_HARD_LIMIT_MS, thuan tuy theo thoi gian
// KET QUA THU NGAY 21/09 voi gia tri 1, che do tu dong, van xa khoa:
//    20:25:29  FILLING  muc 0,17 cm
//    20:25:37  FILLING  muc 2,55 cm   <- dang len binh thuong
//    20:25:41  FILLING  muc 0,00 cm   <- SUP, trong khi bom VAN DANG CHAY
//    20:25:57  NO_PROGRESS, ngat bom
//
// Bo hai cong xac thuc KHONG giup gi. So doc tho that su sup ve 0,00 trong
// luc bom chay — cam bien khong con thay mat nuoc nua ma thay thu gi do o
// 15,5 cm tro ra. Hai cong do khong phai nguyen nhan; chung chi bao dung
// rang du lieu dang hong.
//
// Dieu dang mung: NO_PROGRESS van ngat bom du levelOk bi ep thanh true suot.
// Lop an toan khong dua vao levelOk da lam dung viec cua no.
#define LEVEL_TRUST_ALWAYS     0
// Bao nhieu lan phat hong LIEN TIEP thi coi la mat cam bien va xoa cua so.
// 5 lan x chu ky 200 ms = 1 giay, van con thua truoc SENSOR_TIMEOUT_MS = 4 s.
// Do that: rot khoang 30 phan tram, nen chuoi 5 lan rot lien tiep xay ra
// vai lan moi phut. Moi lan xoa cua so la mat them 600 ms nua de gom lai du
// 3 mau. Nang len 10 lan (2 giay) — van con thua truoc SENSOR_TIMEOUT_MS 4 s.
#define LEVEL_FAIL_STREAK_MAX  10
#define TELEMETRY_PERIOD_MS 1000UL
#define NVS_SAVE_PERIOD_MS  60000UL
#define OFFLINE_BUFFER_SIZE 240

// ---------- Ket noi lai ----------
#define RECONNECT_BASE_MS   1000UL
#define RECONNECT_MAX_MS    30000UL
#define MQTT_KEEPALIVE_S    15
