NhanHuynh2006/smart-water-tank/(commit log)

2026-09-18 Hệ thống bồn nước thông minh: firmware ESP32, backend và báo cáo
    Đồ án cuối kỳ môn IoT Foundations and Applications. Toàn bộ luật điều
    khiển và luật phát hiện sự cố nằm trong ESP32 chứ không nằm trên máy
    chủ, nên bồn vẫn được cấp đầy đúng ngưỡng khi mất mạng.
    Nội dung:
    IOT/ dự án PlatformIO: firmware, backend FastAPI,
    dashboard, cấu hình broker Mosquitto
    water-tank-arduino/ cùng firmware đó, dựng lại cho Arduino IDE
    iot-report-en/ báo cáo LaTeX 45 trang
    schematic-canvas/ nguồn sáu bản vẽ đấu dây
    Hai cảm biến lưu lượng, một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
    [config.example.h, main.cpp, step2_level.cpp, step3_relay.cpp, step5_flow.cpp]
2026-09-18 README: cập nhật cây thư mục sau khi đổi tên, thêm bước tạo config.h từ bản mẫu
2026-09-21 Sửa ba lỗi tìm ra khi chạy trên mạch thật
    Bám theo điểm nghỉ ACS712: đo được nó trôi 32 mV trong 20 giây đầu sau
    khi cấp nguồn, lớn hơn cả ngưỡng nhận biết 15 mV. Hiệu chuẩn một lần lúc
    khởi động là không đủ. Nay bám bằng trung bình trượt chậm, chỉ cập nhật
    khi bơm đang tắt. Ngưỡng hạ từ 15 xuống 10 mV theo số đo thật: bơm chạy
    cho hiệu 19,6 tới 22,6 mV, tức khoảng 212 tới 245 mA.
    Lọc xung nhiễu trên hai chân cảm biến lưu lượng: khi Wi-Fi bật, hai chân
    bắt 1635 tới 2735 Hz dù không có nước chảy; tắt Wi-Fi thì đếm đúng 0.
    Điện trở kéo lên n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
2026-09-21 An toan bom: bit moi duong dan lam bom chay mai
    Tim ra bang do that tren mach: cam bien sieu am doc 4,3 cm trong khi
    config khai bao day bon cach cam bien 55 cm, va gan 50 phan tram lan phat
    khong co tieng doi. Moi so doc deu ngoai dai nen levelOk luon false.
    Trong ban cu, mat cam bien muc KHONG lam bom dung:
    - ST_FILLING chi dung bom khi levelPct vuot nguong. levelOk false thi
    levelPct dong bang o lan doc hop le cuoi, va bom chay tiep cho toi
    MAX_FILL_MS = 600 s. Bon 10 lit khong chiu noi 10 phut bom.
    - ST_FAULT_SENSOR khong he goi stopPump trong than vong lap, chi dua vao
    mot lan goi luc phat loi. Nhom nay lai tu phuc hoi, nen cam bien chap chon
    sinh ra chuoi dot bom 4 giay mot.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
2026-09-21 Loai bo so doc luu luong gia, sua lenh xoa bo dem the tich
    Do tren mach, bom da rut, khong mot giot nuoc chay: chan GPIO 4 dem duoc
    17 103 Hz khi TAT Wi-Fi va 8 228 Hz khi bat. Chan GPIO 19 im hoan toan.
    Phep thu keo len keo xuong cho thay GPIO 4 khong duoc giu chat ve ben nao.
    Bo loc FLOW_MIN_PULSE_US khong he loai duoc nhieu nay. No chi lay mau thua,
    bien 17 kHz thanh 833 Hz, tuc 8,5 L/phut — mot con so trong rat that. Dashboard
    vi the bao 4,6 L/phut o ca hai duong va tich luy 5 858 lit vao mot bon 10 lit.
    Do khong phai loi cua dashboard: no hien dung nhung gi cam bien bao.
    Sua:
    - Dem them bo dem xung THO, khong qua bo loc nao. Tan so tho vuot
    FLOW_MAX_PLAUSIBLE_HZ = 1200 Hz thi dan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
2026-09-21 Tinh lai toan bo nguong theo bon THAT: 1 lit, khong phai 10 lit
    Do tay: mat cam bien cach day thung 15,5 cm, day 10 x 10 cm.
    Tru 5,5 cm cho vung mu 2 cm cua HC-SR04 va sai so, muc lam viec con 10 cm.
    The tich lam viec = 100 cm2 x 10 cm = 1 LIT.
    Moi nguong cu deu duoc dat cho mot bon 10 lit tuong tuong nen rong gap muoi
    lan. Tinh lai het theo bom JT-DC3L 1,67 L/phut:
    TANK_SENSOR_TO_BOTTOM_CM 55 -> 15,5 cm
    TANK_MAX_LEVEL_CM 25 -> 10 cm
    TANK_AREA_CM2 400 -> 100 cm2
    LEVEL_MIN_DISTANCE_CM 32 -> 4,5 cm (muc 10 cm ung voi 5,5 cm)
    MIN_ON_MS 10 s -> 3 s (10 s bom them 28% bon)
    MAX_FILL_MS 240 s -> 90 s (day he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
2026-09-21 Ro le bi dao cuc tinh — day moi la ly do that su bom khong chiu dung
    Nguoi dung bao: bam "tat bom" o che do thu cong ma bom van chay.
    Doi chieu voi so lieu: muc nuoc dang tu 0,2 cm len 11,2 cm trong suot thoi
    gian telemetry bao pump = false va trang thai OVERFLOW_LOCK.
    RELAY_ACTIVE_LOW dat 1, nen setRelay(false) dua GPIO 26 len MUC CAO. Module
    tren mach nay kich muc CAO, nen moi lan phan mem ra lenh NGAT thi phan cung
    lai BAT. Doi thanh 0. Nap xong muc nuoc ngung dang ngay.
    Dieu nay con giai thich ca so doc dong dien gan bang 0 trong khi bom chay:
    EWMA diem nghi cua ACS712 chi cap nhat khi !pumpOn, ma firmware tin rang bom
    luon tat, nen no da hoc luon dong cua bom lam diem nghi.
    Ba loi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
2026-09-21 Hai phao deu tren bon chua; bit ban tin bi cat cut; tat cam bien luu luong
    PHAO. Nguoi dung cho biet ca hai phao deu gan tren BON CHUA, mot phao muc
    cao va mot phao muc thap. Bon nguon khong co cam bien nao. Ban cu hieu phao
    thu hai la phao bon nguon va dung no de CHAN bom, nen thiet bi tu chan chinh
    minh vinh vien: khong lenh nao bat duoc bom.
    PIN_FLOAT_SRC -> PIN_FLOAT_MIN, FLOAT_SRC_ACTIVE_LOW -> FLOAT_MIN_ACTIVE_LOW
    Bo han rao chan "source_tank_empty".
    Phao muc thap thanh dieu kien BAT bom, song song voi sieu am — sieu am rot
    30 phan tram so lan do nen mot duong la khong du.
    Them luat SENSOR_CONFLICT chieu nguoc: phao muc thap bao da tut ma sieu am
    bao con day thi mot tron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
2026-09-21 Tai lieu: lam ro chon 10k/20k hay 1k/2k cho chia ap ECHO
    Muc TXS0108E viet vi du 1k/2k, lech voi phan con lai cua tai lieu va voi
    bang vat tu — ca hai deu ghi 10k/20k. Viet lai cho khop va noi ro khac biet:
    Ti so nhu nhau nen dien ap nhu nhau, deu 3,33 V. Khac o tro khang diem giua:
    6,7 kOhm voi 10k/20k, 0,67 kOhm voi 1k/2k. Suon tin hieu 730 ns so voi 73 ns,
    tuong duong sai so khoang cach 0,013 cm va 0,001 cm — deu chim duoi sai so
    +-1 cm ma cam bien dang co, nen ve thoi gian khong can ban.
    Khac biet that la chong nhieu: diem giua 6,7 kOhm nhay gap muoi lan. Bo mach
    nay da co san van de nhieu nang, nen them ba loi khuyen dat dien tro sat chan
    ESP32, di day ECHO tach khoi day bom, va n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
2026-09-21 Chan doan lai 3 kHz nhieu tren hai chan luu luong: nghi la TXS0108E
    Truoc do toi ket luan day tin hieu "chua noi chac". Nguoi dung cho biet cac
    cam bien deu di qua bo chuyen muc TXS0108E, va gia thuyet do giai thich so
    lieu tot hon han:
    - Hai kenh cho tan so gan bang nhau (3445 va 3282 Hz). Hai cam bien roi nhau
    khong co ly do gi trung nhau toi 5 phan tram; cung mot con chip thi co.
    - Tat Wi-Fi khong doi gi. Vay khong phai nhieu song vo tuyen ma la chinh con
    chip dao dong.
    - Tan so doi theo cach cau hinh chan. Chan tha noi that thi im — chan doi
    chieu GPIO 23 cho 0 Hz. Chan bi nguon that dieu khien thi khong doi theo
    cach keo. Chi mach do chieu dang bi dien tro keo cua ESP32 quay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
2026-09-21 Xac nhan cuc tinh ro le bang do gon dong; cau phan ap sua han HC-SR04
    CAU PHAN AP. Nguoi dung thay TXS0108E tren chan ECHO bang cau 10k/20k.
    Do lai 179 mau:
    so lan khong co tieng doi : 28-30 phan tram -> 0 / 179
    do lech chuan : 0,73 cm
    dai 5-95 phan tram : rong 2,0 cm
    Con chip da an mat khoang mot phan ba so tieng doi. Day cung la bang chung
    gian tiep cho chan doan ben hai chan luu luong: cung con chip, cung kieu hong.
    CUC TINH RO LE. Them test_relaytruth: lan luot dua chan dieu khien xuong
    muc thap roi len muc cao, do dong o tung muc, va ket luan bang so.
    Ban dau ham ket luan dung MUC TRUNG BINH va cho ket qua SAI. ACS712 la cam
    bien hai chieu: ngo ra nam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
2026-09-21 Bom bom 4750 Hz vao ca hai day tin hieu luu luong; YF-S401 con sai dai do
    Nguoi dung nghi hai cam bien luu luong bi dau nguoc: ong xa luon mo, bom
    tat, ma dashboard bao duong VAO chay 0,3 L/phut. Them test_flowmap de tra
    loi: bat bom roi xem chan nao nhay len.
    Ket qua khong tra loi duoc cau hoi do, nhung tim ra thu lon hon:
    GPIO 4 GPIO 19
    bom TAT : 26,4 Hz 25,2 Hz
    bom CHAY : 4755,9 Hz 4722,0 Hz
    4750 Hz chia he so K 98 ra 48 L/phut, trong khi bom that chi day 0,36 L/phut.
    Va hai kenh trung nhau toi 0,7 phan tram — hai cam bien roi nhau khong the
    trung nhu vay. Do la NHIEU DONG PHA do bom bom vao ca hai duong tin hieu
    cung luc. Chung nao co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
2026-09-21 Dao hai cam bien luu luong; 50,00 Hz tren GPIO 19 la dien luoi
    DAO CAM BIEN. Nguoi dung khang dinh ong xa luon mo va chua dong bao gio.
    Doc lai so lieu voi gia thiet do: che do thu cong, bom TAT,
    GPIO 4 doc 0,26-0,36 L/phut <- co dong chay
    GPIO 19 doc 0,00 <- khong co dong chay
    Bom tat thi duong VAO bat buoc phai bang 0. No khong bang 0, con duong duoc
    goi la RA thi lai bang 0 dung luc nuoc dang xa that. Da doi PIN_FLOW thanh
    19 va PIN_FLOW_OUT thanh 4.
    Truoc do toi khong dao vi test_flowmap khong ket luan duoc — nhung phep thu
    do chay trong luc bom bom 4750 Hz nhieu vao ca hai duong, nen no khong the
    ket luan duoc gi. Bang chung vat ly cua nguoi dung manh hon.
    50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
2026-09-21 Chung minh 50 Hz la dien luoi; bo cong xac thuc muc khong giup gi
    VAN KHOA — phep thu doi chung dut diem. Nguoi dung khoa van xa, bom tat,
    khong co gi co the chay:
    GPIO 19 (vao) : 0,00 Hz
    GPIO 4 (ra) : dung 50,00 Hz, moi mau
    Van khoa ma van dem 50,00 Hz thi chi co the la DIEN LUOI cam ung vao day tin
    hieu. Khong con nghi ngo gi nua. Dien tro 4,7 kOhm len 3,3 V la bat buoc.
    HC-SR04 KHONG PHE. Cung luc do, 20 mau lien tiep voi nuoc dung yen:
    3,89 3,87 3,89 3,89 3,89 3,89 3,87 3,89 3,87 3,89
    3,87 3,87 3,87 3,89 3,89 3,89 3,89 3,87 3,89 3,87
    do lech chuan 0,010 cm, dai dao dong 0,02 cm
    Sai so 0,1 mm. Van de nam hoan toan o luc bom lam gon mat nuoc.
    BO CONG XAC THUC —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
2026-09-21 Tai lieu: huong dan noi dien tro 4,7 kOhm cho hai cam bien YF-S401
    So do day du, buoc kiem tra mo dun co san dien tro keo len chua, giai thich
    vi sao phai keo len 3,3 V chu khong phai 5 V, cac con so dong va tro khang,
    va cach kiem chung bang test_flownoise sau khi noi.
2026-09-21 Bom khong phai nguyen nhan: so do da loan 3-5 cm truoc khi bom chay
    test_pumpecho phat sieu am 200 ms mot lan va dong cat ro le giua chung, de
    tach nhieu dien khoi gon nuoc. Ket qua bac bo CA HAI gia thuyet truoc do:
    vong ro le NGAT (bom khong chay) ro le DONG (bom chay)
    1 dai dao dong 5,04 cm 26,89 cm
    2 dai dao dong 3,36 cm 17,75 cm
    So do da loan 3-5 cm trong khi bom CHUA he chay. Neu nguyen nhan la nhieu
    dien do bom thi doan ro le ngat phai sach. Vay ha cau chia ap ECHO xuong
    1k/2k se KHONG chua duoc — rut lai khuyen nghi do. Bom van lam nang them
    khoang nam lan nen diot 1N4007 van dang gan.
    BIEN THAT SU LA MUC NUOC. Doi chieu ba phep do cung ngay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
2026-09-22 Dien tro 4,7 kOhm dap tat hoan toan nhieu nen; tim ra Wi-Fi dang o 5 GHz
    DIEN TRO 4,7 kOhm — hieu qua tron ven o phan nen. test_flownoise sau khi gan:
    GPIO 4 : 0 Hz o CA BA kieu keo (truoc: 3445 / 13403 / 3150 Hz)
    GPIO 19 : 0 Hz o CA BA kieu keo (truoc: 3282 / 12123 / 2938 Hz)
    Nen luc bom tat gio dung bang 0. Khong con 50 Hz dien luoi, khong con the
    tich ao cong don, khong con bao dong gia LEAK_SUSPECTED.
    Luc bom chay van con 1474 va 1548 Hz, tuc 15,8 L/phut trong khi bom that day
    0,36 L/phut. Giam ba lan so voi 4750 Hz truoc khi gan dien tro, nhung van la
    nhieu. Phan con lai thuoc ve diot 1N4007 va viec tach day bom.
    HA CONG PLAUSIBLE 1200 -> 700 Hz. Mot phan nhieu luc bom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
    [config.example.h, main.cpp, step13_wifiscan.cpp, test_wifiscan.ino, water_tank_firmware.cpp]
2026-09-22 Wi-Fi 2,4 GHz chay tot; diot khong giam nhieu; sua mau thuan trang thai va su co
    WI-FI. Sau khi nguoi dung doi diem phat sang 2,4 GHz:
    [WIFI] da noi 'NhanHuynh' · IP 10.60.119.13 · RSSI -47 dBm
    [MQTT] dang ket noi 10.60.119.188:1883... thanh cong
    Chan doan them vao firmware hom qua da chi dung cho ngay tu lan dau.
    DIOT 1N4007 KHONG GIAM NHIEU. Do truoc va sau khi gan diot va dua day bom
    di xa han khoi day tin hieu:
    GPIO 19 bom chay : 1548,4 -> 1567,0 Hz
    GPIO 4 bom chay : 1474,4 -> 1487,3 Hz
    ca hai, bom tat : 0 -> 0 Hz
    Chenh duoi 1,3 phan tram, nam trong sai so phep do. Neu la nhieu buc xa thi
    tach day ra xa phai co tac dung. Vay phan con lai DAN theo duong nguon va
    d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
2026-09-22 Them bo loc mu cho cam bien muc: giat cuc giam muoi hai lan
    Nguoi dung bao phan tram nuoc nhay giat cuc 5-7 phan tram du bom tat va mat
    nuoc tinh. Do lai 40 mau lien tiep thi con te hon:
    do lech chuan 0,472 cm · dai dao dong 2,32 cm = 23 phan tram
    buoc nhay giua hai mau: trung binh 0,267 cm, lon nhat 1,75 cm
    Trong khi nuoc that chi tut 0,013 cm moi giay. Nhieu gap hai muoi lan tin hieu.
    NGUYEN NHAN. Trung vi chi loai DOT BIEN, no khong lam muot. Chin mau deu lech
    +-0,5 cm thi trung vi cua chung van lech +-0,5 cm. Suot tu dau den gio duong
    xu ly chi co trung vi va khong he co mot khau lam muot nao.
    SUA. Cua so trung vi 9 -> 15 mau, va them trung binh truot mu dat SAU trung
    vi, he s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
2026-09-23 Suy luu luong tu muc nuoc; mo hinh muc nuoc chay song song; HC-SR04 da chet
    HC-SR04 CHET HAN. Nguoi dung bao da rut het nuoc va muon bom lai. Viet
    test_fillwatch de vua bom vua theo doi tung lan phat, co gioi han thoi gian:
    bom tat, bon can : 14 lan phat, 0 tieng doi
    bom chay 90 giay : 205 lan phat, 0 tieng doi (them 0,54 lit)
    bom tat, da co nuoc : 23 lan phat, 0 tieng doi
    242 lan phat, khong mot tieng doi. Khac han voi "doc sai khoang cach": luc
    bon can truoc day cam bien van tra ve 16-21 cm. Im hoan toan la khong phat
    duoc song. Chan ECHO do ra bi giu muc thap o ca ba kieu keo nen day van con.
    Day la hong phan cung, khong phai chuyen bon can va khong phai phan m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
2026-09-23 Bom len toi nguong 70 phan tram lan dau; 40/40 mau khong mot su co
    Sau khi nguoi dung mat dien va cap lai, HC-SR04 hoat dong tro lai ngay. Nap
    lai phan sun nhieu lan hom qua khong cuu duoc vi nap lai chi khoi dong lai
    ESP32, KHONG cat nguon 5 V cua cam bien — nguon do lay thang tu coc buck.
    HC-SR04 co the khoa cung sau mot xung kich di thuong hoac mot lan sut ap, va
    o nguyen trang thai do cho toi khi bi cat nguon.
    VUNG 5,8 cm. Do lap lai nam lan trong ngay: khi muc nuoc dang bom cham
    khoang 5,7-5,9 cm, cam bien chuyen tu do mat nuoc sang do DAY THUNG va tra
    ve gia tri tuong duong muc 0-1 cm. No KHONG bao loi; so doc trong hoan toan
    hop le. Hai chuc giay sau no quay lai va doc dung 5,8 cm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
2026-09-23 Ve lai dashboard theo bang mimic; khoa lenh bang token; sua hinh hoc cam bien
    DASHBOARD. Ban cu — va ca ban dau toi viet lai — roi dung vao hai trong nam
    "dau hieu may tao" ma skill frontend-design liet ke: luoi the bo goc giong het
    nhau, va nhan IN HOA gian chu phia tren moi khoi. Viet lai theo mot huong co
    lap truong rieng: bang mimic phong dieu khien.
    - Ve thang he thong: nguon -> bom -> dong ho -> bon -> van xa, so lieu dat
    dung vi tri tung bo phan. Bom sang mau ho phach va ong day doi mau khi chay.
    - Bon la ONG THUY co cay thuoc khac vach ben canh, vach chinh moi 2 cm co
    ghi so. Bo con so cm nho trong khung: cay thuoc da noi thay no.
    - Nen men thep xanh dau, khong pha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
2026-09-23 Dashboard hien so ma BO DIEU KHIEN dang dung, khong hien so cam bien dong bang
    Nguoi dung thay man hinh dung yen o khoang 50 phan tram roi NHAY mot phat len
    70 kem thong bao ngat bom. Do la mo hinh muc nuoc lam dung viec cua no, nhung
    GIAO DIEN hien sai — va cho sai la cua toi.
    Khi cam bien mat tin hieu, level_pct dong bang o lan doc hop le cuoi cung,
    trong khi mo hinh moi la thu dang cam lai va dang quyet dinh luc nao ngat bom.
    Dashboard lai hien level_pct. Nguoi xem thay so dung yen roi nhay, va khong co
    cach nao biet ben trong van dang chay binh thuong.
    Nay khi mat tin hieu thi hien thang so cua mo hinh: khong con dung yen, khong
    con cu nhay. Mat nuoc trong ong thuy mo bot va duong ma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
2026-09-23 Muc lam viec 10 -> 14 cm, dung chieu cao THAT cua thung
    Nguoi dung bao web ngat o 70 phan tram ma mat nhin chua toi 70. Khong phai
    sai so cam bien — nguoi dung da xac nhan so cm la dung — ma la hai ben dang
    noi ve hai thang do khac nhau.
    TANK_MAX_LEVEL_CM dat 10 cm, nen 70 phan tram nghia la 7,0 cm nuoc. Thung
    that cao 14 cm, nen 7,0 cm nhin bang mat chi la 50 phan tram chieu cao thung.
    Web va mat khong cach nao khop duoc chung nao con hai thang do.
    Dat 14 cm, dung chieu cao that. Tu gio 100 phan tram tren giao dien la 100
    phan tram cua cai thung nguoi dung nhin thay.
    An toan khong mat gi, vi moi nguong deu la phan tram cua con so nay:
    bom khi duoi 30% = 4,2 cm cach mieng thu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
2026-09-23 Dem ly do loai so doc muc nuoc; tim broker bang mDNS; thu nhieu mang Wi-Fi
    DEM LY DO LOAI. Nguoi dung doi sua TRIET DE chuyen dong chu vang "mat tin
    hieu". Hien dep hon khong phai la sua — goc la levelOk rot qua thuong xuyen,
    va toi chua biet CONG NAO dang loai so doc. Them mot o dem cho tung cong va
    cong bo ra telemetry:
    rj_echo khong co tieng doi rj_gate ngoai dai hinh hoc
    rj_few cua so chua du mau rj_spread cua so trai qua rong
    rj_rng chieu cao phi vat ly rj_rate vuot toc do doi muc
    rj_fall tut xuong khi dang bom rj_join lech mo hinh khi quay lai
    cung lv_try va lv_ok. Do xong moi sua dung cong dang chan, thay vi noi lung
    tung tat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
    [main.cpp, water_tank_firmware.cpp]
2026-09-23 File mau: them cac muc moi va quet ca IP nam trong chu thich
    Bo sinh file mau chi thay gia tri cua #define, nen cac dia chi IP that viet
    trong chu thich van di theo len GitHub. Chung khong phai mat khau nhung lo ra
    so do mang that. Nay quet ca chu thich, giu lai dung 192.168.1.10 la dia chi
    vi du.
    Them WIFI_SSID_2, WIFI_SSID_3 va MQTT_HOST_NAME vao file mau cho khop voi
    config.h hien tai.
2026-09-23 Cong trai qua rong doi sang tu phan vi; loc alpha-beta; phan quyen xem va dieu khien
    TIM DUNG CONG DANG CHAN. Dem ly do loai cho tung lan phat trong mot lan bom
    binh thuong: 605 lan phat, 244 bi loai, 98 phan tram so bi loai la do cong
    "cua so trai qua rong". Khong co tieng doi chi 2 phan tram — cam bien tra ve
    gan nhu moi lan.
    Cong do do phan tan bang max - min, thong ke nhay voi DUY NHAT mot mau lac.
    Mot tieng doi tu day thung trong 15 mau la du vut ca cua so. Dung bo loc
    trung vi de chiu nhieu le, roi chan no bang thuoc do nhay voi nhieu le nhat,
    la tu pha chinh minh. Doi sang khoang tu phan vi, nguong 3,5 cm — van nho hon
    han khoang cach ~9 cm giua mat nuoc va day thung khi cam bien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
2026-09-23 Xem cong khai qua Internet, dieu khien bang mat khau; sua xac nhan lenh bom
    DUA RA INTERNET. Nguoi dung gui link trong Wi-Fi cho nguoi khac nhung ho
    khong vao duoc, va noi dung: IoT la de xem tu xa, khong phai ai o gan moi
    xem duoc. start.sh gio mac dinh mo Cloudflare Quick Tunnel — khong can tai
    khoan, khong mo cong router — va in ra dia chi https cong khai.
    ./start.sh local de bo qua. stop.sh tat ca duong ham.
    PHAN QUYEN LAM LAI TU GOC. Cach nhan quan tri theo IP may chu sai ngay tu y
    tuong: qua duong ham MOI yeu cau deu den tu 127.0.0.1, nen ai tren Internet
    cung thanh "may chu". Nguoi dung cung chi ra chieu nguoc lai: mo bao nhieu
    tab tren may chu cung dieu khien duoc ma khong can g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
2026-09-23 Dashboard: bao ket qua lenh bang loi de hieu va dem nguoc thoi gian nghi cua bom
    Nguoi dung chon thu cong, bam bat bom ma "khong duoc". Bang lenh cho thay tam
    lan bam trong mot giay, lan nao cung toi thiet bi va bi tu choi voi ly do
    min_off_time: bom vua tat sau mot chu ky tu dong, va phan sun bat nghi 20 giay
    truoc khi bat lai de bao ve dong co. Tinh nang bao ve chay dung — loi o giao
    dien, khong noi gi voi nguoi bam.
    - Sau moi lenh, doi thiet bi xac nhan (toi da 4 giay) roi hien ket qua ngay
    duoi nut: "Da thuc hien." hoac ly do tu choi bang loi de hieu, vi du
    "Bom vua tat, phai nghi 20 giay giua hai lan bat de bao ve dong co."
    - Nut Bat bom hien dem nguoc "Bat bom · cho N s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
2026-09-23 Dashboard: ghi ro "Da dang nhap quan tri", an nut dieu khien cho toi khi xac nhan
    Nguoi dung mo lai trang va tuong o mat khau bi mat. Thuc ra trinh duyet con
    giu phien dang nhap 7 ngay nen trang hien nut dieu khien thay cho o mat khau
    — dung hanh vi, nhung khong co gi tren man hinh noi ra dieu do.
    - Dau khung Dieu khien ghi "Da dang nhap quan tri." kem nut Dang xuat, thay
    cho hang "Phien" nam lan o cuoi.
    - Cac nut dieu khien AN SAN trong HTML, chi hien sau khi /api/auth xac nhan
    da dang nhap. Truoc day chung hien mac dinh roi moi bi an, nen nguoi chua
    dang nhap thay chung chop len mot nhip luc trang dang tai.
    Kiem tra: chua dang nhap chi thay o mat khau; dang nhap xong th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
2026-09-23 Dashboard: bo dong 'suy tu muc nuoc' duoi o dong vao va dong ra
    Chi con hien chu duoi o Dong ra khi that su khong tinh duoc (mat muc nuoc
    qua 10 giay); luc binh thuong de trong.
2026-09-23 Dong ra khong con nhay theo bom: do dong xa luc bom tat roi giu nguyen
    Nguoi dung thay duong do (dong ra) vot len dung luc duong xanh (dong vao)
    nhay len khi bat bom, va tut ve 0 luc tat. Van xa khong he biet bom bat, nen
    day la loi cua cach tinh, khong phai nuoc ra that.
    Cong thuc cu: dau ra = luu luong bom - toc do doi muc. Luu luong bom la mot
    buoc nhay TUC THI, con toc do doi muc tu bo loc can vai giay moi theo kip.
    Trong vai giay do phep tru cho so qua lon luc bat bom va am (ep ve 0) luc tat.
    Nay dong xa chi duoc do khi bom TAT va da qua DRAIN_SETTLE_MS = 20 giay —
    toc do tu bo loc alpha-beta co hang so thoi gian khoang 9,4 giay — roi lam
    muot rieng voi DRAIN_EMA_ALPHA = 0,01 va G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
2026-09-26 Doi chieu de bai: the tich theo ngay, phan loai loi bom, duong nen ro ri song lai
    Doi chieu tung dong cua de bai Project 08 voi he thong hien tai, sua cac cho
    chua dat.
    THE TICH THEO NGAY. De bai: "dashboard for level, flow, daily volume, ...".
    Dashboard chi co the tich tich luy. Them the "The tich theo ngay": cot doi 7
    ngay, bom vao va tieu thu, kem dong "Hom nay". Endpoint /api/volume/daily viet
    lai: ban cu lay MAX - MIN bo dem trong ngay, nen chi mot lan "Dat lai the
    tich" la tra ve nguyen gia tri truoc luc dat lai. Nay cong don cac buoc tang
    bang ham cua so LAG, bo buoc tut (dat lai) va buoc > 2 lit (rac). Nuoc bom vao
    chi cong khi bom DANG chay — bom tat thi khong the co nuoc bom vao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
2026-09-26 Kiem chung theo de bai: TESTING.md, cong cu bench (mat mang, do tre loi, hieu chuan muc); gioi han thoi gian thu ket noi broker de vong dieu khien khong treo khi mat mang
    [main.cpp, water_tank_firmware.cpp]
2026-09-26 Huong dan doc ma cho nguoi moi: kien truc, vong lap, loc muc nuoc, may trang thai, duong di cua lenh, mat mang (Mermaid)
2026-09-26 Sua loi bat bom sau moi lan khoi dong (levelOk=true voi muc 0% truoc khi co so do that); gui ly do khoi dong trong ban tin status
2026-09-27 Bao cao: cap nhat chuong 2-8 theo he thong cuoi va de bai Project 08, them ket qua E2/E3/E4/E7 va hinh ve tu du lieu that
2026-10-03 So do kien truc: nhan POST va HTTPS khong de len khung
2026-10-05 Firmware: kiem tra socket ghi duoc truoc khi gui (het treo 10 s khi mat mang), phat lai bo dem co the noi tiep; gui kem luu luong cam bien de doi chieu; bench.py chay nen voi SUDO_PASS
2026-10-05 Bai thu fillwatch: tu ngat bom khi muc tren 75 %
2026-10-05 Them bo kiem thu he thong tu dong (systest.py): ket noi, bao mat, lenh, tu choi, bom tay, mat mang
2026-10-05 Loc muc nuoc: cong 'tut khi bom' so voi muc da loc va chap nhan chuoi on dinh (het khoa chet), mo hinh khong cong nuoc khi bom no_flow, so doc on dinh thang mo hinh troi; doi nhan no_flow tren dashbo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
2026-10-05 Bai thu step16: ghi khoang cach sieu am tho khi bom tat/chay de chan doan
2026-10-05 Bai thu chay nguoc qua bom (test_backflow)
2026-10-05 Hinh hoc bon do lai: cam bien cach day 15,88 cm, muc lam viec 12,4 cm; lay phan vi 25 cua cua so (tieng doi tre chi lam doc xa hon)
2026-10-05 Hieu chuan muc theo bac voi chuan the tich bom (step17) va so lieu 05/10
2026-10-05 Vung mu sieu am 8-9 cm: bo so doc xa hon day, mo hinh bac cau toi 90 s ca luc ranh; K cam bien vao 85,5 theo thuoc
2026-10-05 Kich ban quay video minh chung (7 clip, moi clip ung voi mot yeu cau cua de)
2026-10-06 MQTT: khong thay broker qua mDNS thi hoi lai sau moi lan ket noi that bai (truoc day ket o dia chi du phong cu toi khi Wi-Fi rot)
    [main.cpp, water_tank_firmware.cpp]
2026-10-06 Bom tay khong bi ngat khi di qua vung mu: chay tiep theo mo hinh toi da 90 s, chan tran theo muc mo hinh; bat moi van can so do that
2026-10-06 Bao cao va slide theo so do KiCad cua nhom: bo 2 hinh TikZ sai, them so do mach va anh mo hinh; chia ap 10k/20k cho luu luong va ACS712 (sua he so dong 8,11 mA/mV), nguon 5 V va 3,3 V rieng; kich ban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
2026-10-07 start.sh: grep -a de khong in canh bao 'binary file matches' khi doc tunnel.log
2026-10-07 Bom tay bat duoc khi nuoc dung trong vung mu (theo mo hinh, toi da 90 s moi lan)
2026-10-07 Bao bom chay kho theo dong dien (DRY_RUN khi duoi 270 mA trong 3 s; ngap nuoc ~325 mA, kho ~220 mA), nhan suc khoe 'dry' tren dashboard; cap nhat bao cao va slide
2026-10-09 Bao cao: tach thong tin bia va bang phan cong ra bia_phancong/ de sua rieng
